rhoppel/CBS-1100-XV_git/Released/Documentation/ST-Link SWD Programming for STM32F01.pdf

# ST-Link SWD Programming for STM32F01

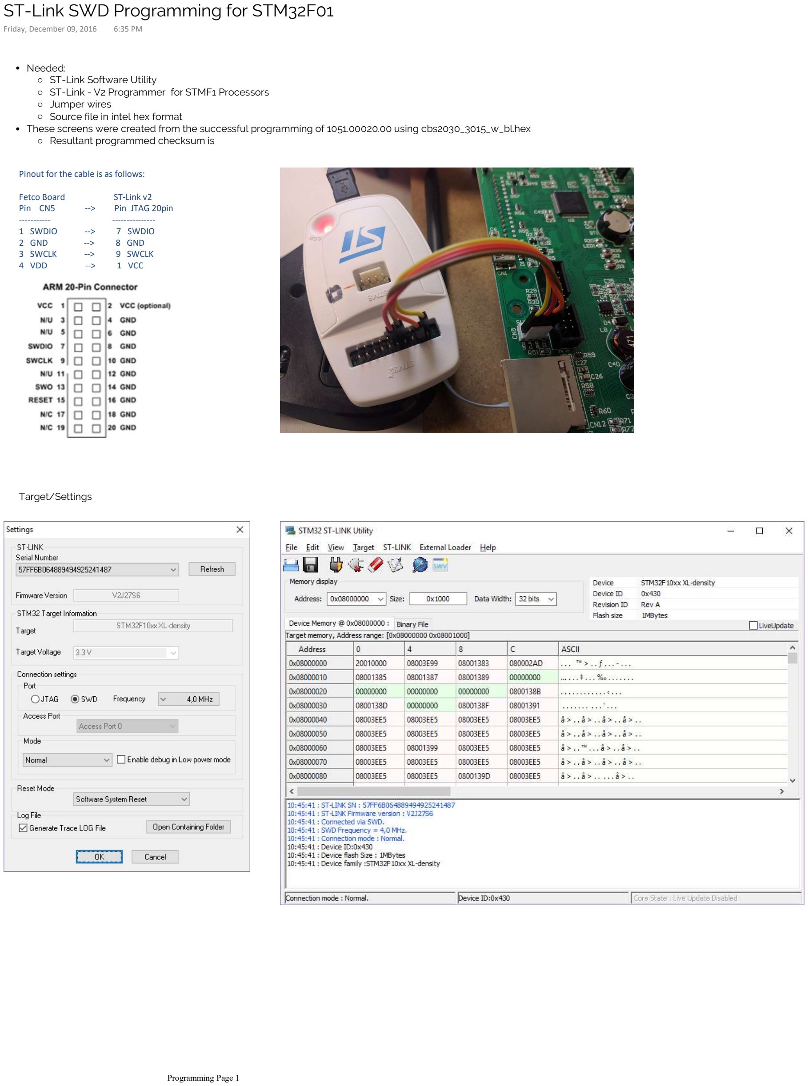
[picture p16: page 1]

- ST-Link Software Utility ○ ST-Link - V2 Programmer for STMF1 Processors ○ Jumper wires ○ Source file in intel hex format • Needed: ○ Resultant programmed checksum is • These screens were created from the successful programming of 1051.00020.00 using cbs2030_3015_w_bl.hex

Pinout for the cable is as follows:

Fetco Board | ST-Link v2 Pin CN5 | --> | Pin JTAG 20pin
----------- | --------------- 1 SWDIO | --> | 7 SWDIO
2 GND | | --> | 8 GND
3 SWCLK | | --> | 9 SWCLK
4 VDD | | --> | 1 VCC

Target/Settings

Friday, December 09, 2016 6:35 PM

Programming Page 1

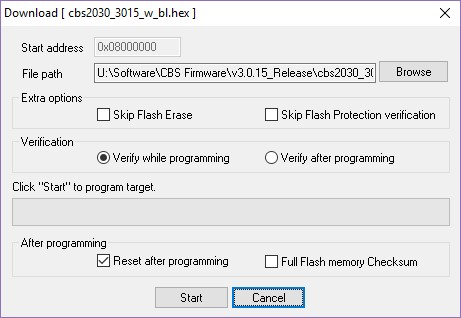
[picture p17: figure]
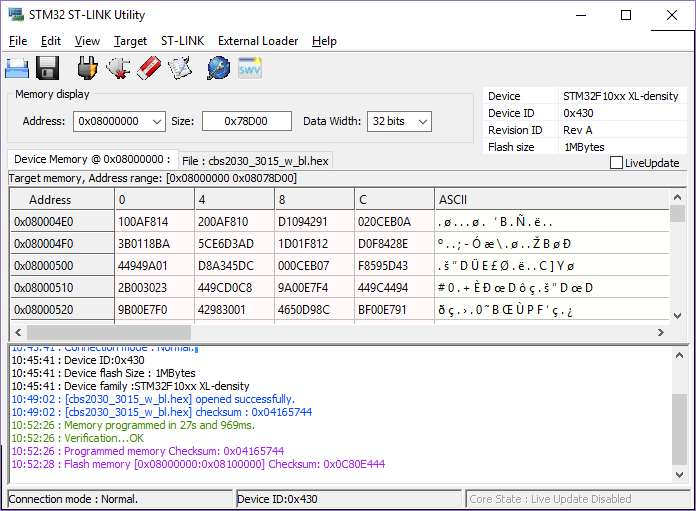
[picture p18: figure]

Target/Program and Verify | Results after a successful program

Programming Page 2
