rhoppel/CBS-1100-XV_git/Released/Drawings/1402 (WIRE HARNESSES)/1402.00097.01.pdf

1402.00097.01 - HARNESS, LOW AMP, CBS-1151-XV+, UL | rev.A
YELLOW | 33" | YELLOW
RED | 33"
BLACK | 33" | BLACK

RED

6" YELLOW
YELLOW | 17" | 1/4", FI
BLACK | 17" | 1/4", FI
ORANGE | 17" | 1/4", FI
GRAY | 10" | 1/4", FI
GRAY | 10" | 1/4", FI

6" BLACK
BLACK | 33"
RED | 33"
6" RED
PURPLE | 30"
YELLOW | 30"
WHITE/GREEN | 32"
GREEN | 16" | RING #8, U

TAB connectors fully insulated.
RING connector double crimped and uninsulated. All wires 18AWG/300VAC, 105o
C (UL 1007/1569).

VHR-5N

1

1

1/4", FI

1/4", FI

1/4", FI

VHR-4N

1/4", FI

VHR-5N

VHR-3N

1

1

1/4", FI

1

VHR-2N

1/4", FI

1/4", FI

SZ 8.18.17
