rhoppel/CBS-1100-XV_git/Released/Drawings/1402 (WIRE HARNESSES)/1402.00097.02.pdf

1402.00097.02 - HARNESS ADDITION, LOW AMP, CBS-1152-XV+, UL | rev.A

6" YEL/WHT 1/4", FI
YELLOW/WHITE | 17" | 1/4", FI
BLACK/WHITE | 17" | 1/4", FI
ORANGE/WHITE | 17" | 1/4", FI
GRAY/WHITE | 10" | 1/4", FI
GRAY/WHITE | 10" | 1/4", FI

1/4" PIGGY, FI

1/4" PIGGY, FI

TAB connectors fully insulated. All wires 18AWG/300VAC, 105o C (UL 1007/1569).

6" RED

1/4", FI

1/4", FI

1

VHR-5N

6" BLACK

SZ 8.18.17
