rhoppel/CBS-1100-XV_git/Released/Drawings/1402 (WIRE HARNESSES)/1402.00098.01.pdf

1402.00098.01 - HARNESS, LOW AMP, CBS-1131-XV+, UL | rev.B
YELLOW | 23" | YELLOW
RED | 23"
BLACK | 23" | BLACK

RED

YELLOW | 17" | 1/4", FI
BLACK | 17" | 1/4", FI
GRAY | 8" | 1/4", FI
GRAY | 8" | 1/4", FI
BLACK | 25"
RED | 25"
PURPLE | 24"
YELLOW | 24" | 1/4", FI
WHITE/GREEN | 29" | 1/4", FI
GREEN | 12" | RING #8, U
RED | 8" | 1/4", FI
BLACK | 8" | 1/4", FI | TAB connectors fully insulated.
| | | RING connector double crimped and uninsulated.
| | | All wires 18AWG/300VAC, 105o C (UL 1007/1569).
RED | 8" | 1/4", FI | * - Wire insulation cut 3/8" from the end and left.
BLACK | 8" | 1/4", FI

1

1

1/4", FI

1/4", FI

1/4", FI

VHR-5N

VHR-3N

1

VHR-5N

VHR-3N

# VHR-4NBLUNT

CUT*

1

1

VHR-2N

1

SZ 8.24.17
