rhoppel/CBS-1100-XV_git/Released/Drawings/1402 (WIRE HARNESSES)/1402.00098.02.pdf

1402.00098.02 - HARNESS ADDITION, LOW AMP, CBS-1132-XV+, UL | rev.B
YELLOW/WHITE | 13" | 1/4", FI
BLACK/WHITE | 13" | 1/4", FI
GRAY/WHITE | 10" | 1/4", FI
GRAY/WHITE | 10" | 1/4", FI

1/4" PIGGY, FI
TAB connectors fully insulated.
1/4" PIGGY, FI | All wires 18AWG/300VAC, 105o
C (UL 1007/1569).

BLACK 6"

RED 6"

1

VHR-5N

1/4", FI

1/4", FI

SZ 8.24.17
