rhoppel/CBS-1100-XV_git/Released/PCB/1051.00041.00-A.3/1051.00041.00_1-A.3/Drawings List/[1051.00041.00_1-A.3] Drawings List-CBS1100(Production).pdf

1051.00041.00_1 | A.3
Project: | CBS1100.PrjPCB
Variant: | CBS Production PCB
Number | Drawing Number | Description | Revision
1 | 1051.00041.00_2 | Schematic; CBS-1100 XV+ | A.4
2 | 1051.00041.00_0 | PCB; CBS-1100 XV+ | A.3
3 | 1051.00041.00_3 | Stencil; CBS-1100 XV+ | A.3
4 | 1051.00041.00_4 | Software; CBS-1100 XV+ | A.1
5
6
7

## DRAWINGS LIST - ASSEMBLY PCB:

Altium Limited Confidential | 8/29/2017 | Page 1
