rhoppel/CBS-1100-XV_git/Released/Documentation/Document.docx

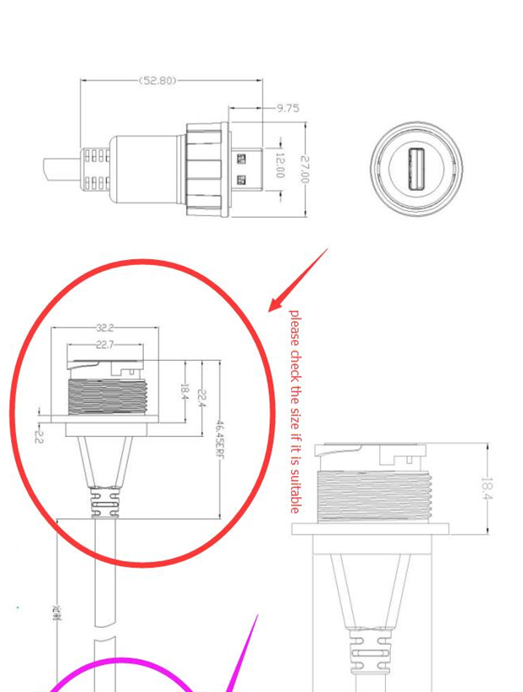
[picture p19: figure]
