rhoppel/CBS-1100-XV_git/Released/Documentation/USB panel waterproof connector.pdf

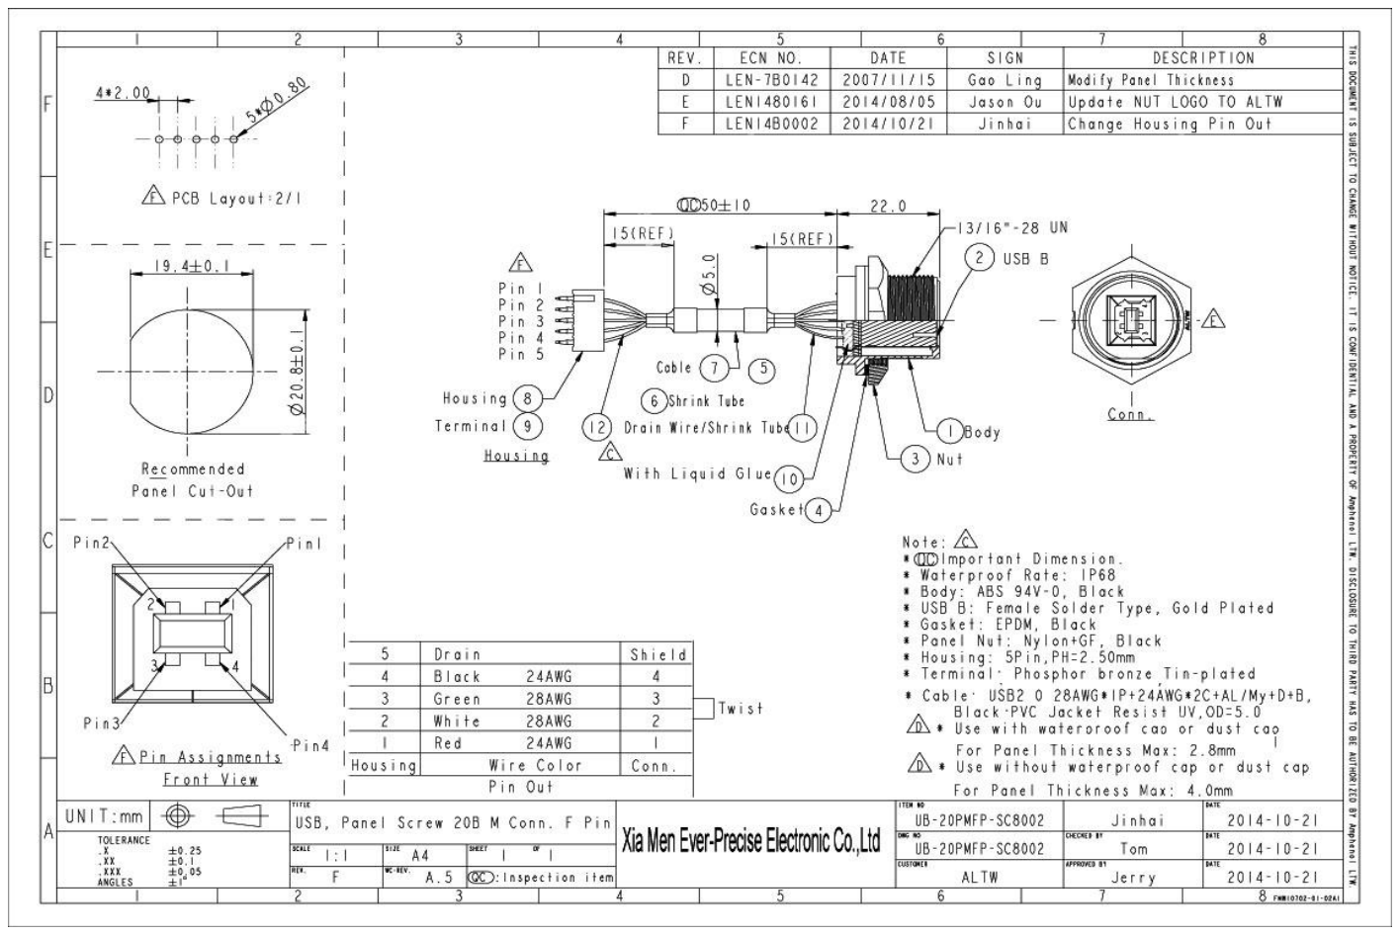
[picture p20: page 1]
