rhoppel/CBS-1100-XV_git/img/CBS/CBS-1131-2.png

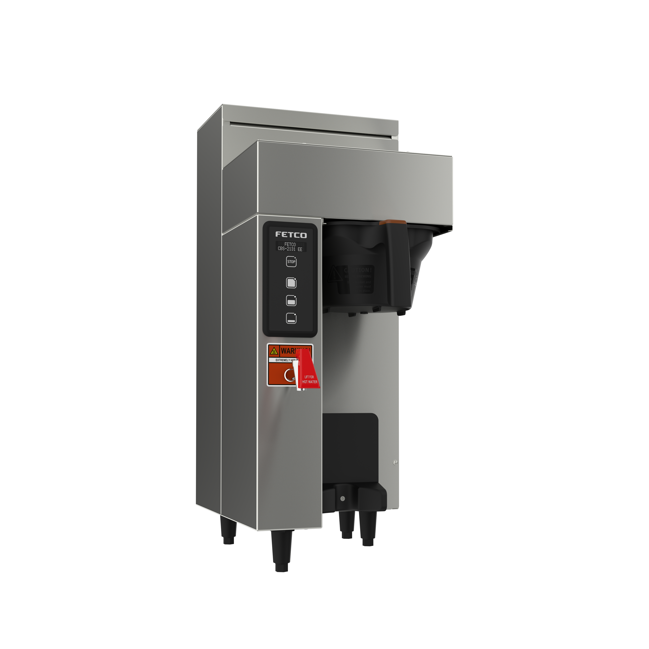
img/CBS/CBS-1131-2.png
