rhoppel/CBS-1100-XV_git/img/CBS/CBS-1131_back.png

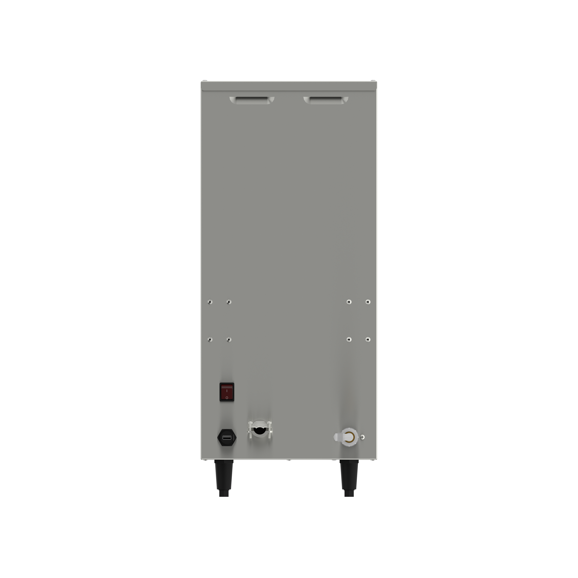
img/CBS/CBS-1131_back.png
