rhoppel/CBS-1100-XV_git/img/CBS/CBS-1131_right.png

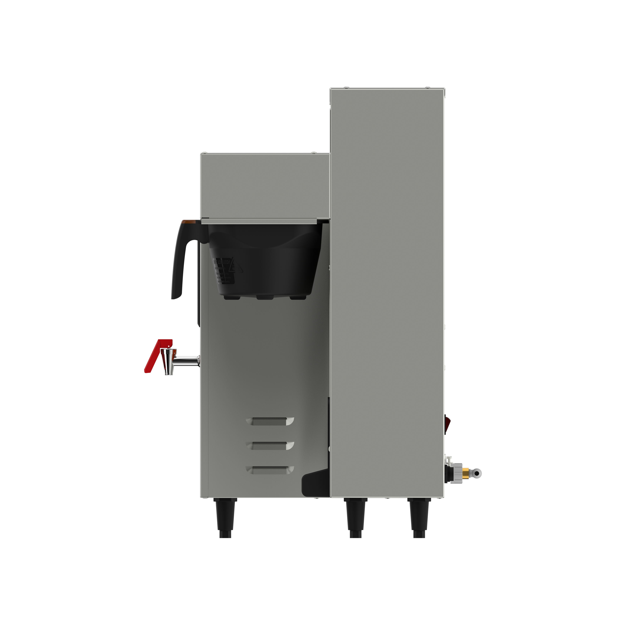
img/CBS/CBS-1131_right.png
