rhoppel/CBS-1100-XV_git/img/CBS/CBS-1132_back.png

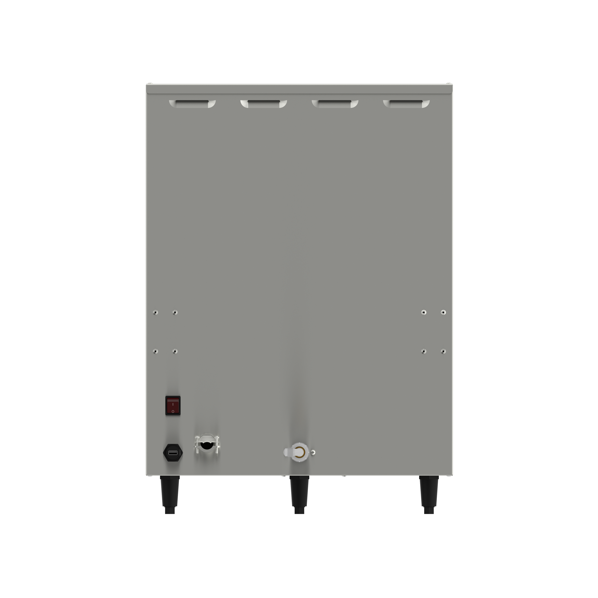
img/CBS/CBS-1132_back.png
