rhoppel/CBS-1100-XV_git/img/CBS/CBS-1132_front.png

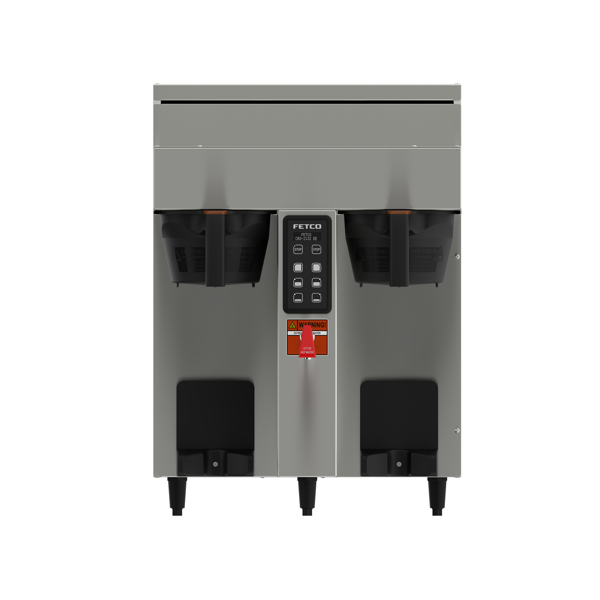
img/CBS/CBS-1132_front.png
