rhoppel/CBS-1100-XV_git/img/CBS/CBS-1151-2.png

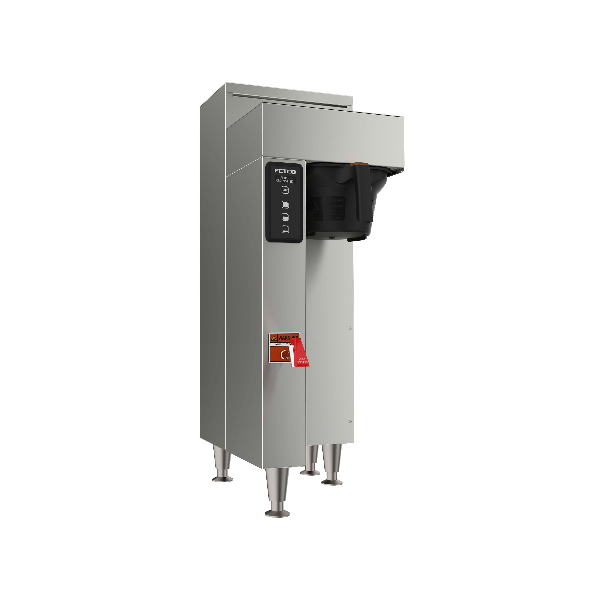
img/CBS/CBS-1151-2.png
