rhoppel/CBS-1100-XV_git/img/CBS/CBS-1151_right.png

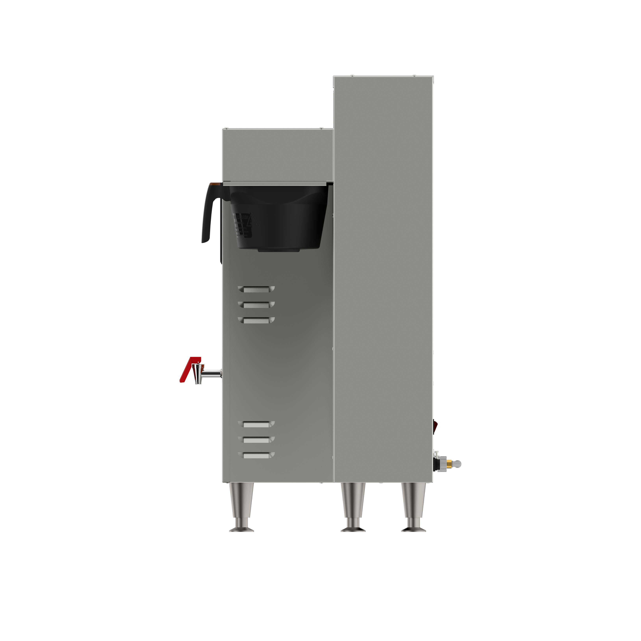
img/CBS/CBS-1151_right.png
