rhoppel/CBS-1100-XV_git/img/CBS/CBS-1152_front.png

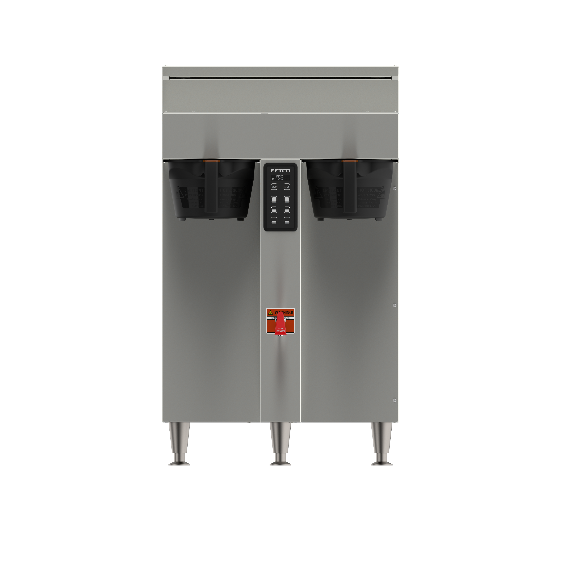
img/CBS/CBS-1152_front.png
