rhoppel/CBS-1100-XV_git/img/FETCO4.jpg

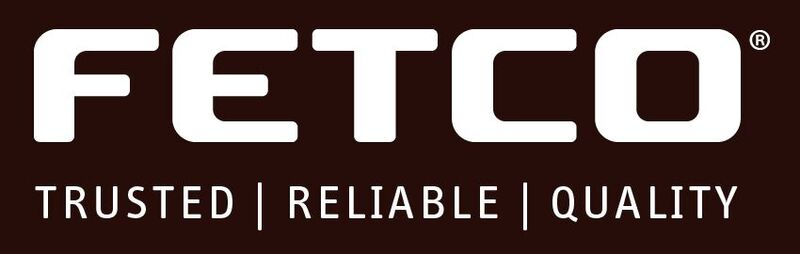
img/FETCO4.jpg
