rhoppel/CBS-1100-XV_git/img/FETCO.png

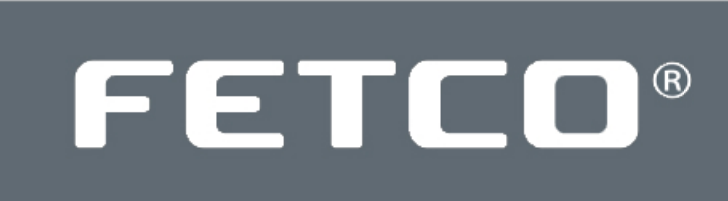
img/FETCO.png
