rhoppel/CBS-1100-XV_git/img/FETCO_HOPPEL.png

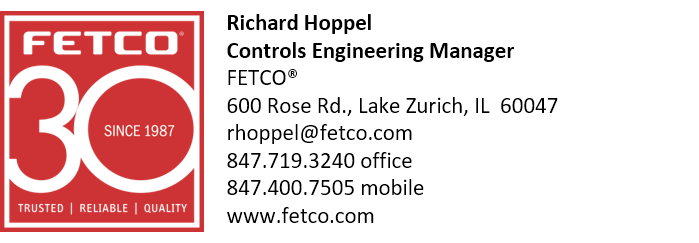
img/FETCO_HOPPEL.png
