rhoppel/CBS-1100-XV_git/img/FETCO_Hoppel_Bcard_small.png

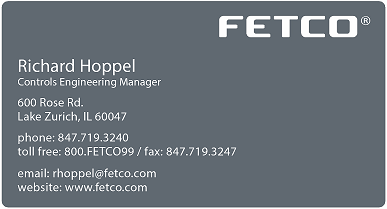
img/FETCO_Hoppel_Bcard_small.png
