rhoppel/CBS-1100-XV_git/img/PCB/1051.00041.00_0-A.3_Top.jpg

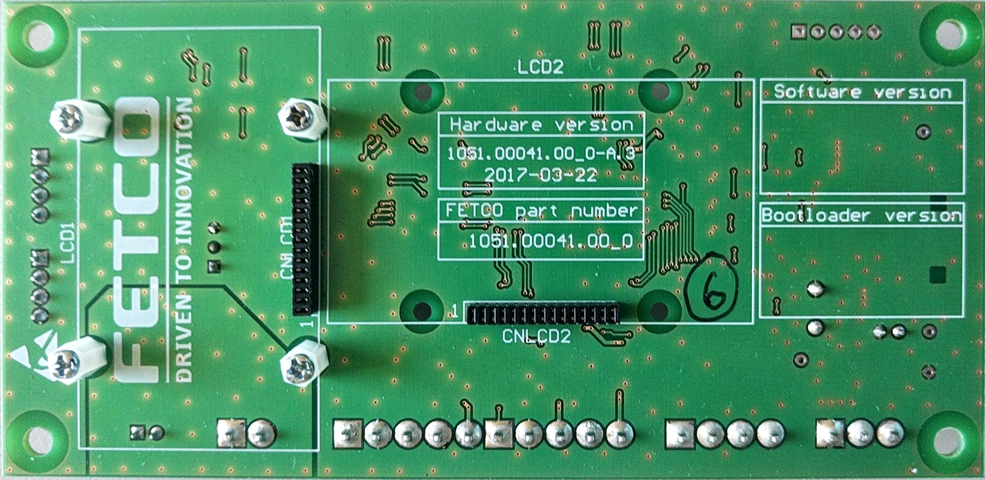
img/PCB/1051.00041.00_0-A.3_Top.jpg
