rhoppel/CBS-1100-XV_git/img/PCB/MembraneSwitch_Dual.jpg

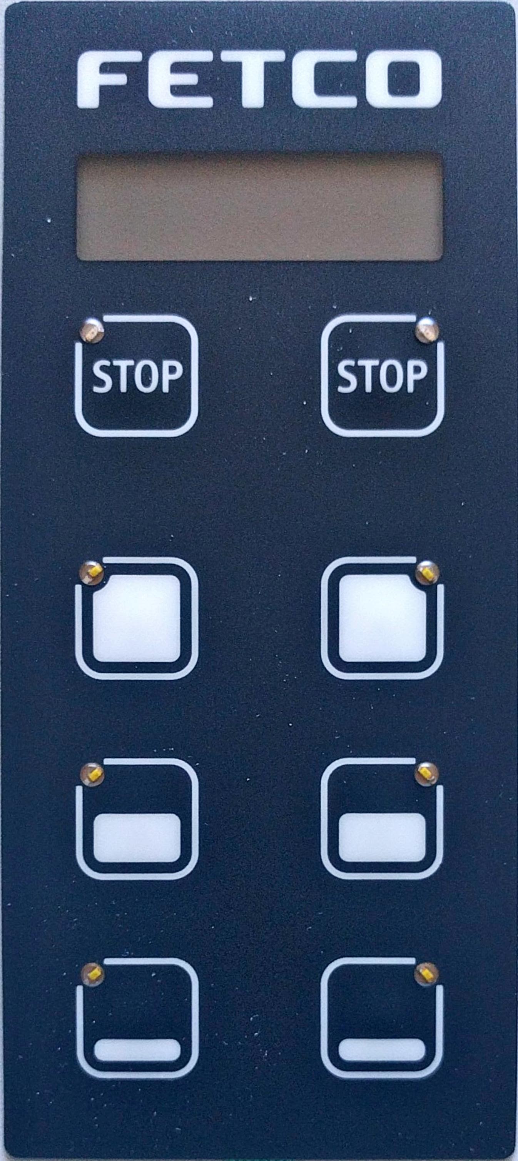
img/PCB/MembraneSwitch_Dual.jpg
