rhoppel/CBS-1100-XV_git/img/PCB/MembraneSwitch_Dual_cable.jpg

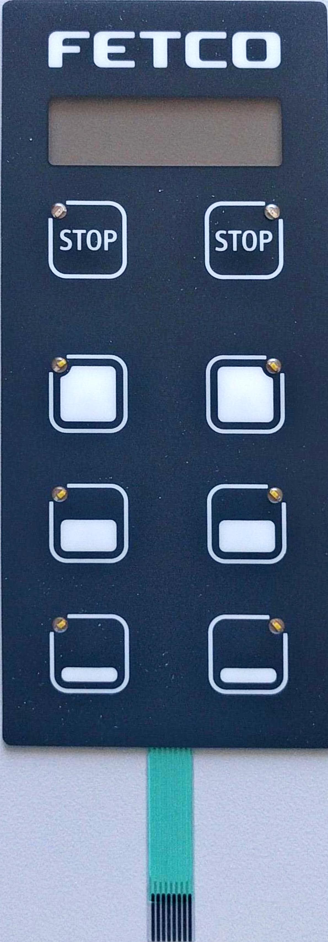
img/PCB/MembraneSwitch_Dual_cable.jpg
