rhoppel/CBS-1100-XV_git/img/PCB/MembraneSwitch_Single.jpg

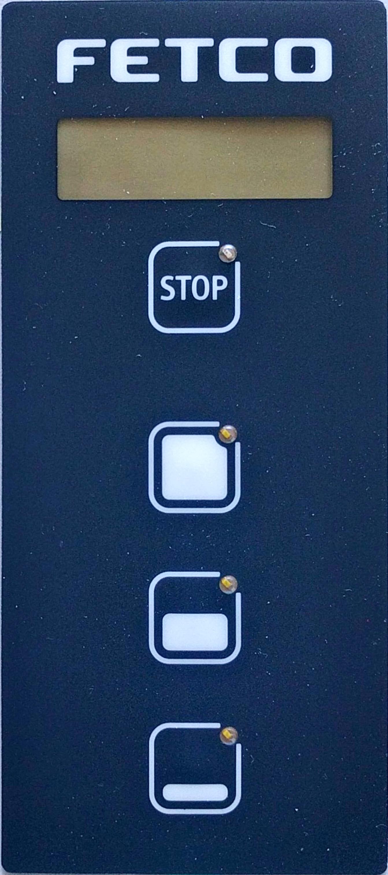
img/PCB/MembraneSwitch_Single.jpg
