rhoppel/CBS-1100-XV_git/img/ST-Link.PNG

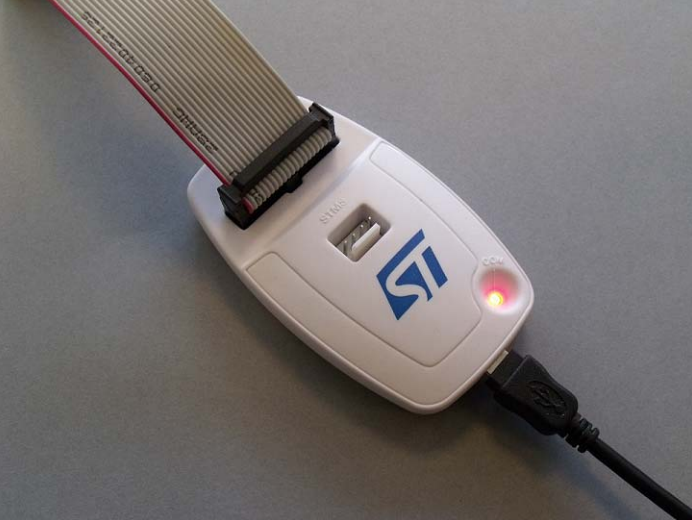
img/ST-Link.PNG
