rhoppel/CBS-1100-XV_git/Released/DisplayAssembly/Documentation/specifications.jpg

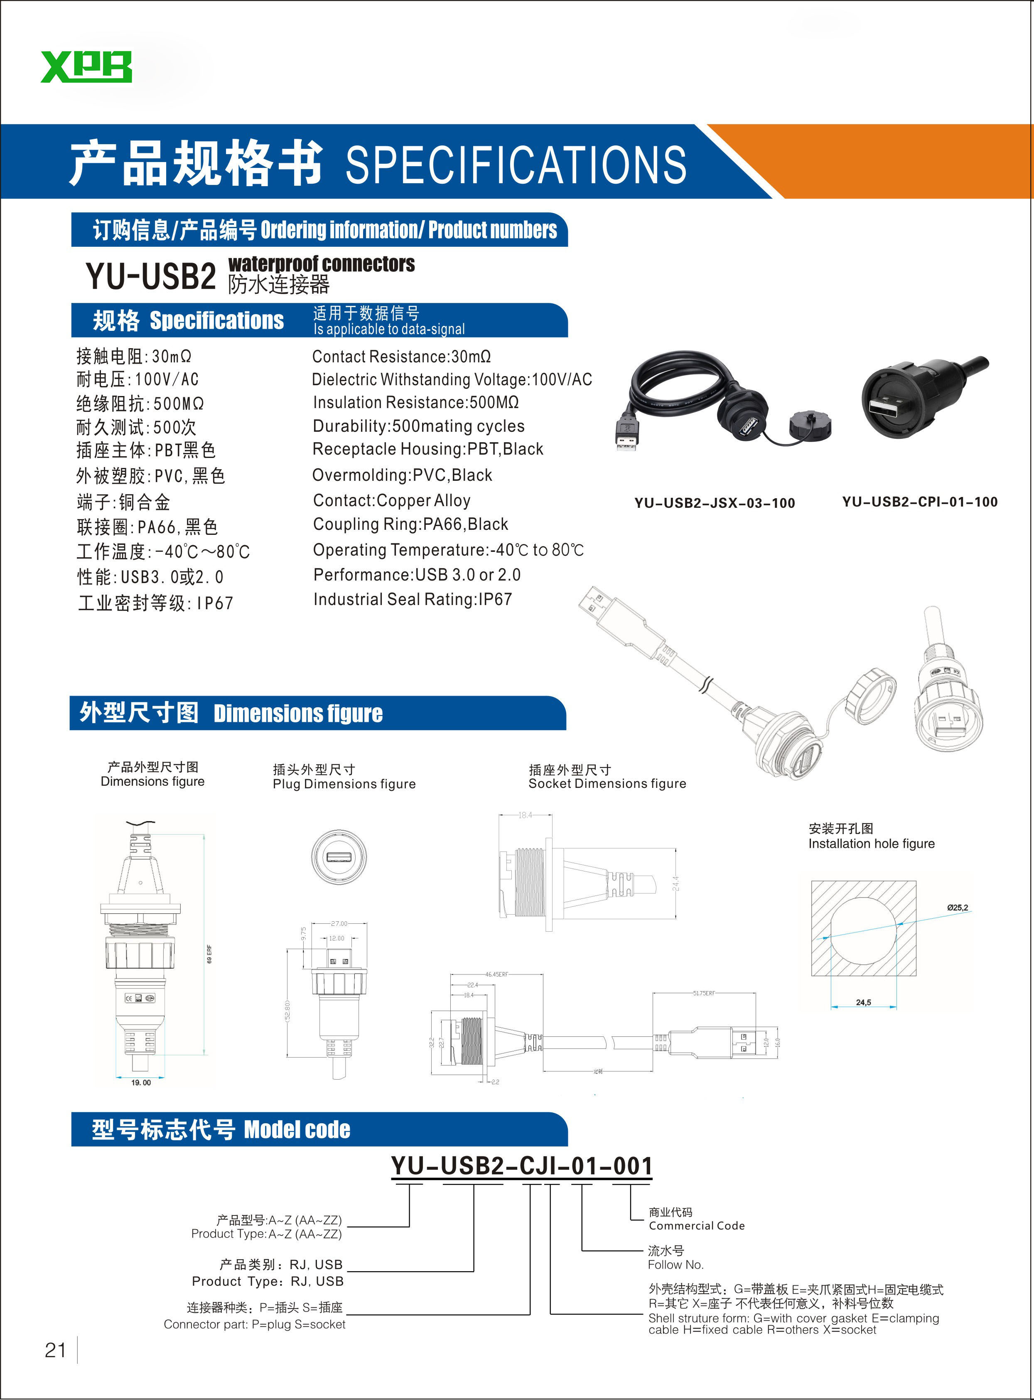
Released/DisplayAssembly/Documentation/specifications.jpg
