rhoppel/CBS-1100-XV_git/Released/DisplayAssembly/Switches/Membrane Switch/CBS Double Schematic2 Transparent.png

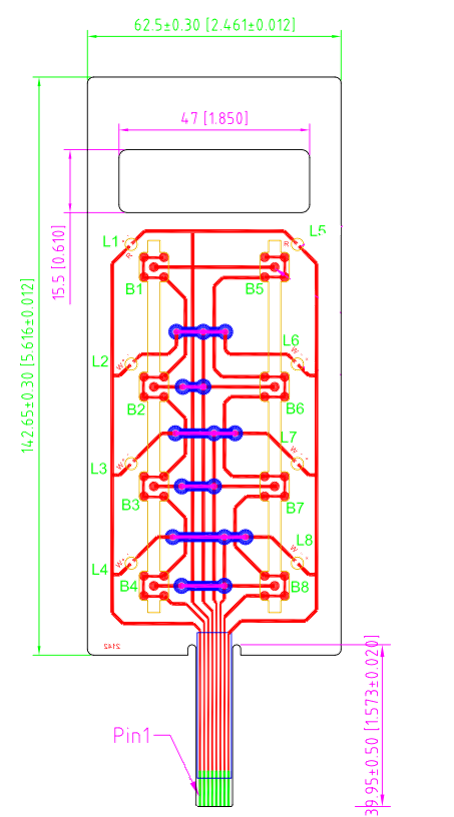
Released/DisplayAssembly/Switches/Membrane Switch/CBS Double Schematic2 Transparent.png
