rhoppel/CBS-1100-XV_git/Released/DisplayAssembly/Switches/Membrane Switch/CBS Single2 Schematic Transparent.png

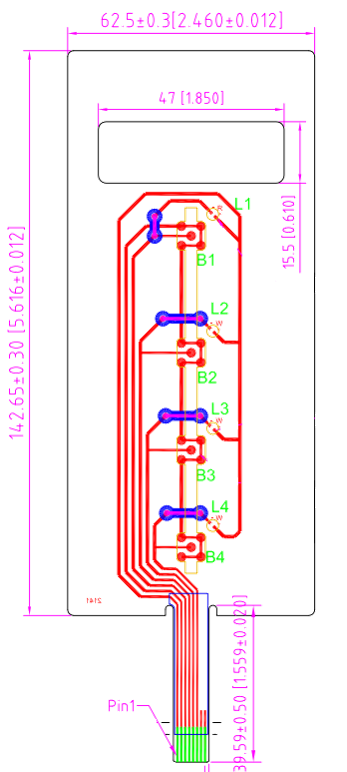
Released/DisplayAssembly/Switches/Membrane Switch/CBS Single2 Schematic Transparent.png
