rhoppel/CBS-1100-XV_git/Released/PCB/img/PCB/1051.00041.png

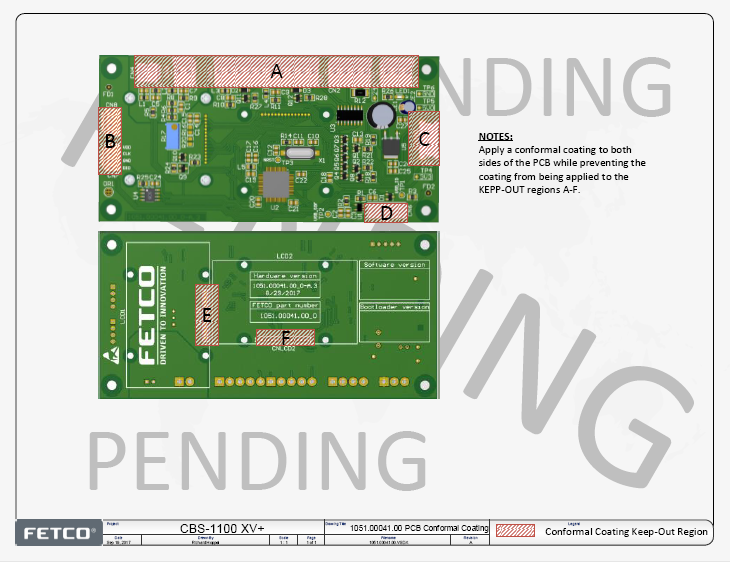
Released/PCB/img/PCB/1051.00041.png
