rhoppel/CBS-1100-XV_git/Released/PCB/img/PCB/PCB_Artwork.PNG

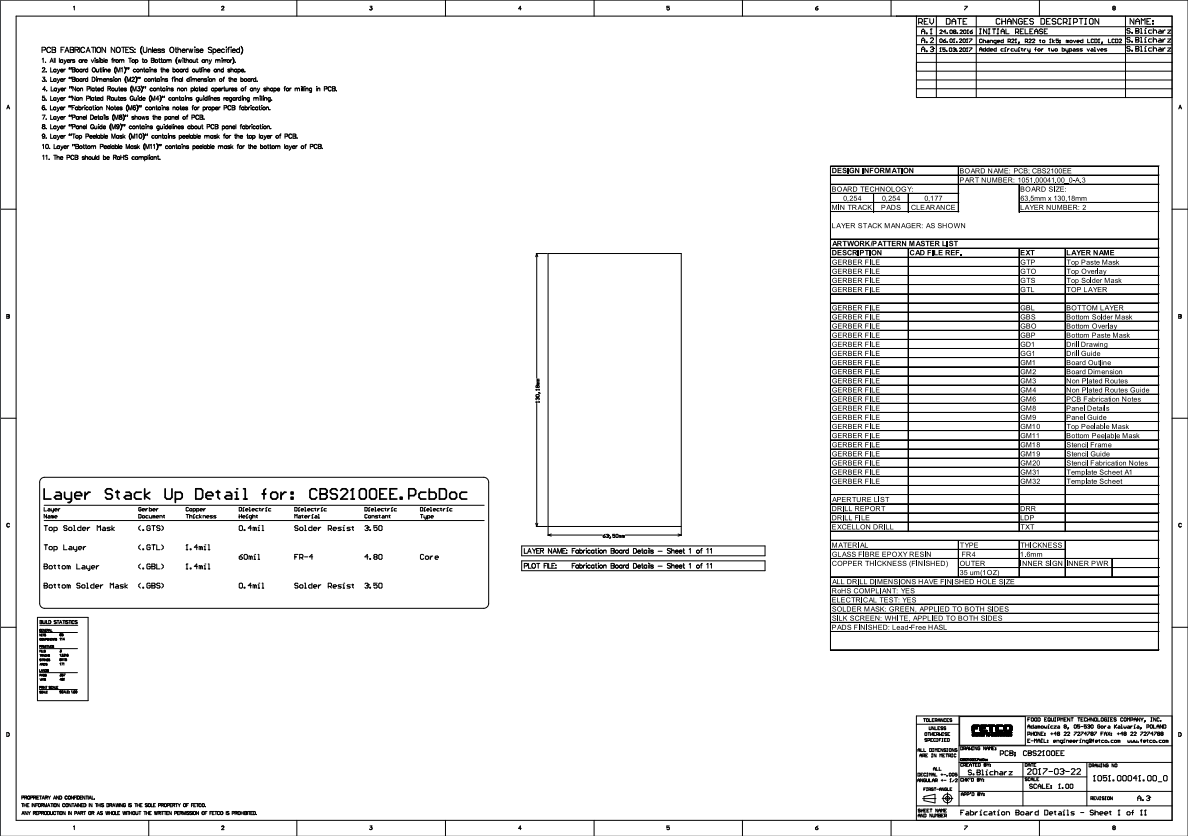
Released/PCB/img/PCB/PCB_Artwork.PNG
