rhoppel/CBS-1100-XV_git/Released/PCB/img/PCB/Stencils_largest.PNG

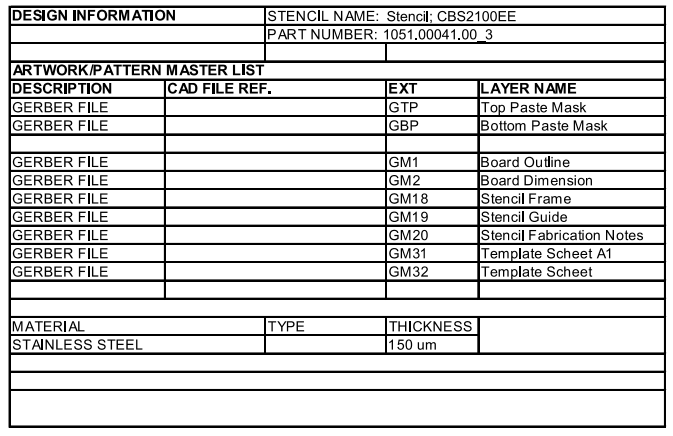
Released/PCB/img/PCB/Stencils_largest.PNG
