rhoppel/CBS-1100-XV_git/Released/PCB/img/PCB/Top_larger.PNG

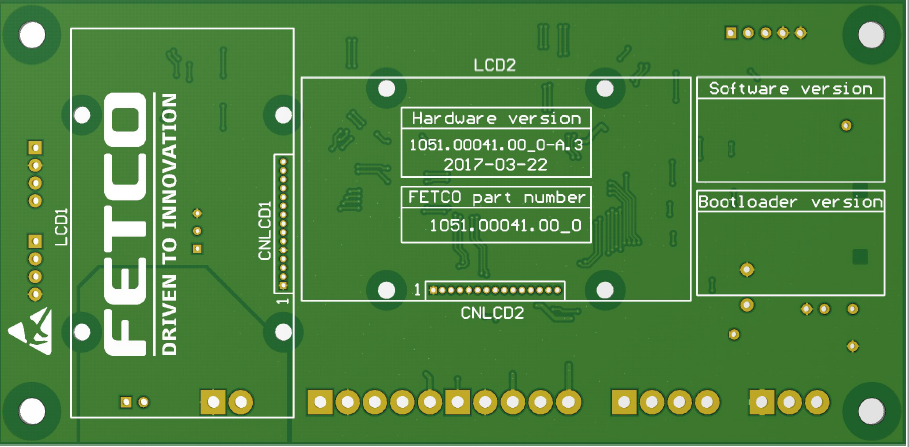
Released/PCB/img/PCB/Top_larger.PNG
