rhoppel/CBS-1100-XV_git/Released/PCB/img/PCB/BOM_largest.PNG

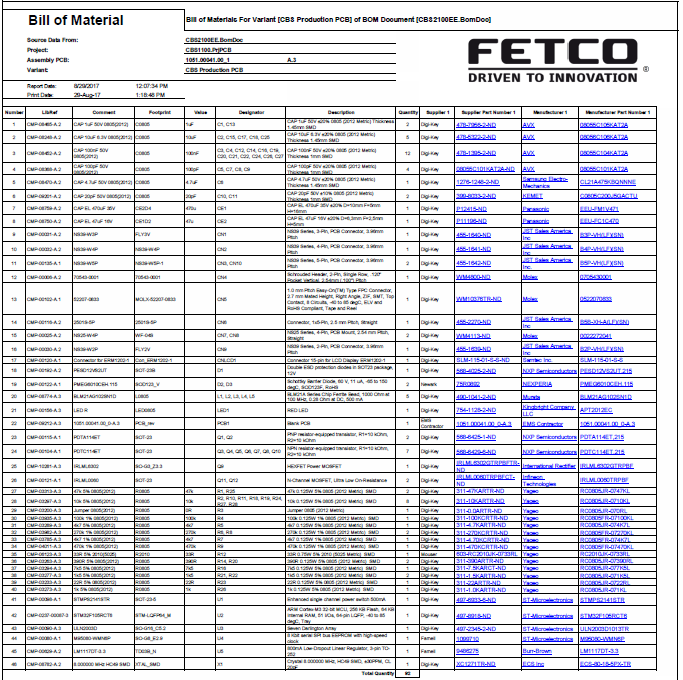
Released/PCB/img/PCB/BOM_largest.PNG
