rhoppel/CBS-1100-XV_git/Released/PCB/1051.00041.00-A.3/1051.00041.00_0-A.3/10510004100_03_19_2017.dxf

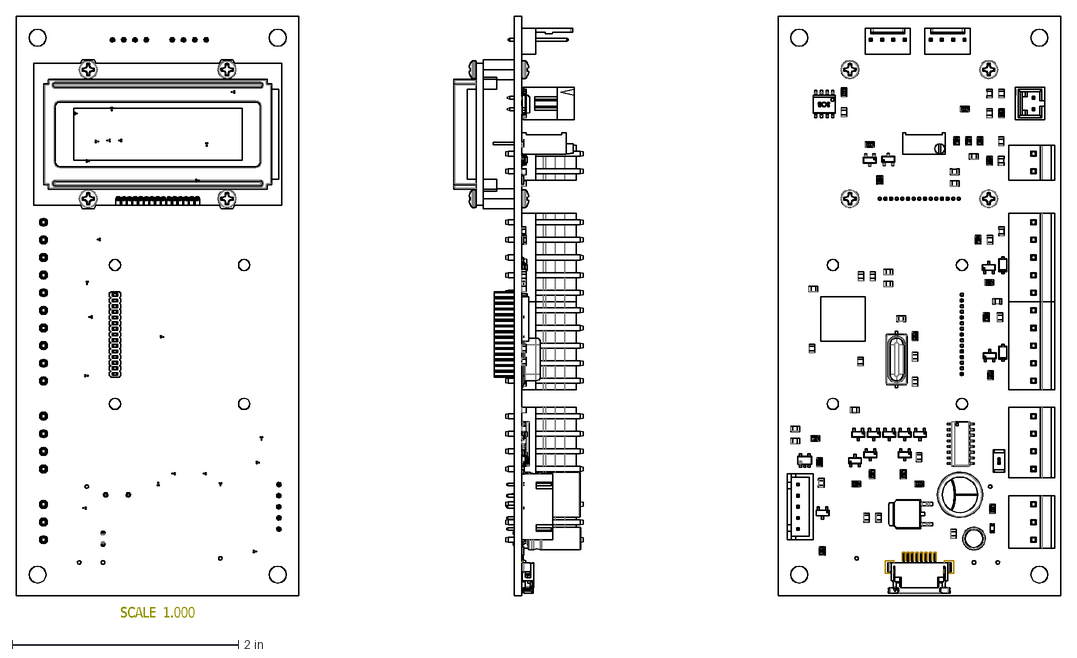
[picture p51: CAD file, 2019-11-21]
Released/PCB/1051.00041.00-A.3/1051.00041.00_0-A.3/10510004100_03_19_2017.dxf
SCALE 1.000
