rhoppel/CBS-1100-XV_git/(list of files, cad)

Other CAD files:
Released/DisplayAssembly/Switches/Membrane Switch/1058.00047.00 CBS Single/UA-1241-R3 PRODUCT DRAWING.DWG
Released/DisplayAssembly/Switches/Membrane Switch/1058.00048.00 CBS Dual/UA-1242-R3 CIRCIUT DRAWING.DWG
Released/DisplayAssembly/Switches/Membrane Switch/UA-1242-R3 CIRCIUT DRAWING.DWG
Released/DisplayAssembly/Switches/Membrane Switch/1058.00047.00 CBS Single/UA-1241-R3 CIRCUIT DRAWING.DWG
Released/DisplayAssembly/Switches/Membrane Switch/1058.00048.00 CBS Dual/UA-1242-R3 PRODUCT DRAWING.DWG
Released/DisplayAssembly/Switches/Membrane Switch/UA-1241-R3 PRODUCT DRAWING.DWG
Released/DisplayAssembly/Switches/Membrane Switch/UA-1242-R3 PRODUCT DRAWING.DWG
Released/DisplayAssembly/Switches/Membrane Switch/UA-1241-R3 CIRCUIT DRAWING.DWG
