rhoppel/CBS-1100-XV_git/Released/Drawings/1108 (ASSEMBLY BOARDS SWITCHING CONTROL & SOFTWARE)/1108.00036.00.pdf

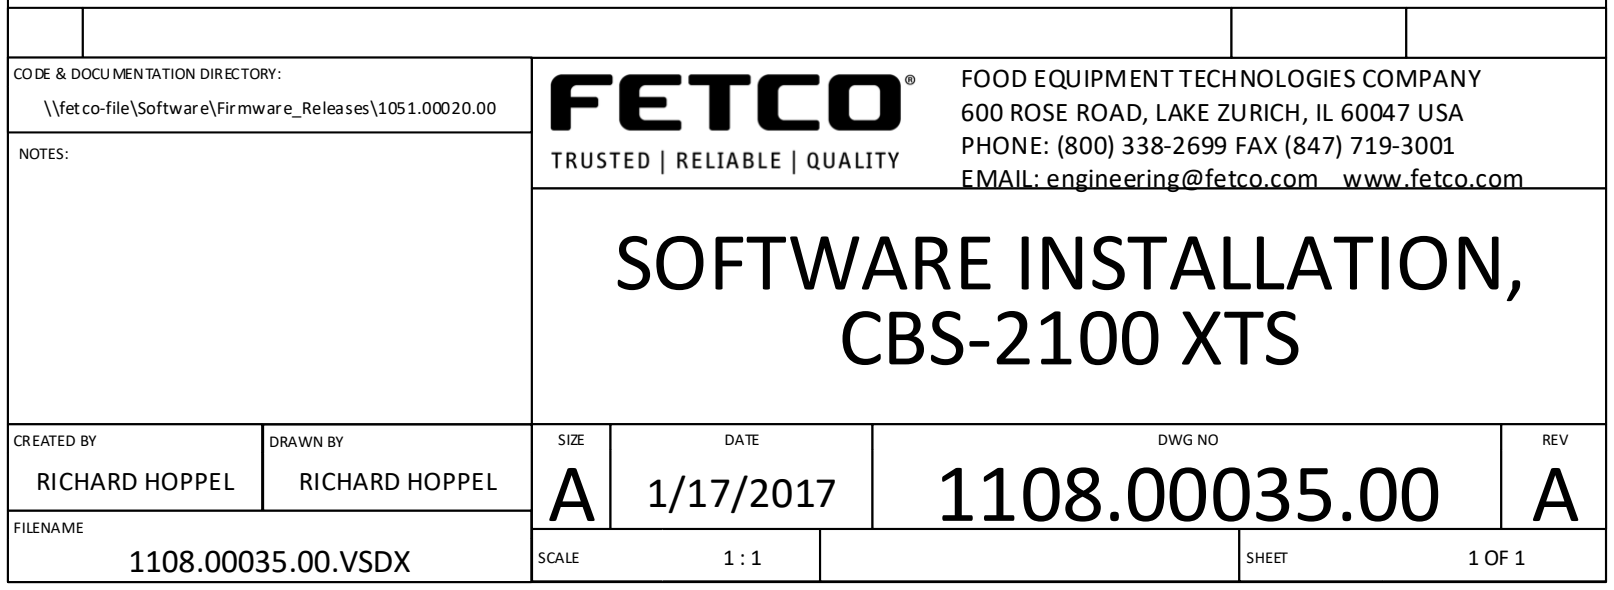
[picture p63: figure]
SOFTWARE INSTALLATION, CBS-2100 XTS; SCALE; SHEET; FOOD EQUIPMENT TECHNOLOGIES COMPANY; FILENAME; 1108.00035.00.VSDX; CODE & DOCUMENTATION DIRECTORY:; NOTES:

CREATED BY | DRAWN BY | SIZE | DATE | DWG NO | REV
RICHARD HOPPEL | RICHARD HOPPEL | A | 1/17/2017 | 1108.00035.00 | A

600 ROSE ROAD, LAKE ZURICH, IL 60047 USA PHONE: (800) 338-2699 FAX (847) 719-3001 EMAIL: engineering@fetco.com www.fetco.com

\\fetco-file\Software\Firmware_Releases\1051.00020.00

### BILL OF MATERIALS

ITEM | PART NUMBER | DESCRIPTION | QTY
1 | 1050.00019.BL | BOOTLOADER, CBS-2100 XTS | 0
2 | 1050.00019.FW | FIRMWARE, CBS-2100 XTS | 0

SOFTWARE = FIRMWARE + BOOTLOADER

SOFTWARE INSTALLATION ON CBS-2100 CONTROL BOARD 1051.00020.00 OR UNIT USING AN SD-CARD:
- OBTAIN A BLANK, FORMATTED SD-CARD GREATER THAN 1 GB
- SKIP THE FOLLOWING STEP IF THE DESIRED BOOTLOADER IS ALREADY INSTALLED ON PCB 1051.00020.00
- COPY 4 FILES SPECIFIED IN 1050.00019.BL ON TO THE SD-CARD
- COPY THE 1 FILE SPECIFIED IN 1050.00019.FW ON TO THE SD-CARD
- CHECK INTEGRITY OF FILES ON SD-CARD BY COMPUTING MD5 CHECKSUM CODE AND VERIFYING THE MD5 CHECKSUM CODE SPECIFIED IN 1050.00019.FW AND 1050.00019.BL
- MD5 CHECKSUM CODE TOOL AND INSTRUCTIONS ARE INCLUDED IN THE DIRECTORY SPECIFIED IN 1050.00019.FW
- POWER OFF UNIT
- INSERT SD-CARD INTO SD-CARD SLOT ON UNIT
- POWER ON UNIT
- UNIT WILL BE AUTOMATICALLY UPDATED
- WAIT UNTIL MESSAGE INDICATING SD-CARD SHOULD BE REMOVED
- REMOVE SD-CARD
- UNIT WILL REBOOT, IF NOT TURN POWER OFF, THEN TURN POWER ON
- CHECK SOFTWARE REVISION ON SCREEN WHICH IS VISIBLE FOR 3 SECONDS AFTER REBOOT, IT SHOULD MATCH THE VERSIONS SPECIFIED IN 1050.00019.FW AND 1050.00019.BL
- REPEAT PROCESS IF NOT PROGRAMMED CORRECTLY

SOFTWARE INSTALLATION ON TO CBS-2100 CONTROL BOARD 1051.00020.00 DURING PCB ASSEMBLY USING SWD CONNECTOR AND A ST-LINK/V2 PROGRAMMER OR USING SPECIALIZED EQUIPMENT TO INSTALL FIRMWARE DIRECTLY ON TO MICROPROCESSOR STM 32F103
- OBTAIN INTEL HEX FORMAT FIRMWARE FILE SPECIFIED IN 1050.00019.FW
- CHECK INTEGRITY OF FILE BY VERIFYING THE MD5 CHECKSUM CODE SPECIFIED IN 1050.00019.FW
- MD5 CHECKSUM CODE TOOL AND INSTRUCTIONS ARE INCLUDED IN THE DIRECTORY SPECIFIED IN 1050.00019.FW
- PROGRAM INTEL HEX FORMAT FIRMWARE FILE ON TO DEVICE USING DESIRED METHOD AS INDICATED ABOVE
- KEEP ALL PROGRAMMING FUSES INTACT
- CHECK PROGRAMMED CHECKSUM TO VERIFY PROGRAMMING AS SPECIFIED IN 1050.00019.FW

### REVISIONS

REV | DESCRIPTION | DATE | APPROVED
A | INSTRUCTIONS FOR INSTALLING FIRMWARE ON TO CBS-2100 CONTROL BOARD 1051.00020.00 | 1/30/17 | RH
