rhoppel/CBS-1100-XV_git/Released/DisplayAssembly/Switches/Membrane Switch/PF_CBS_Double.png

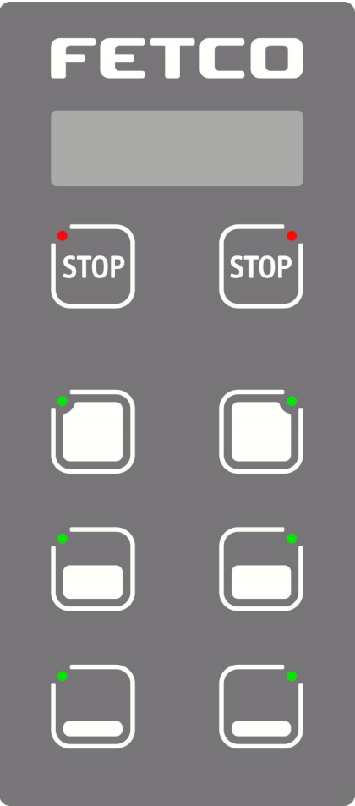
Released/DisplayAssembly/Switches/Membrane Switch/PF_CBS_Double.png
