rhoppel/CBS-1100-XV_git/Released/DisplayAssembly/Switches/Membrane Switch/PF_TBS_Single.png

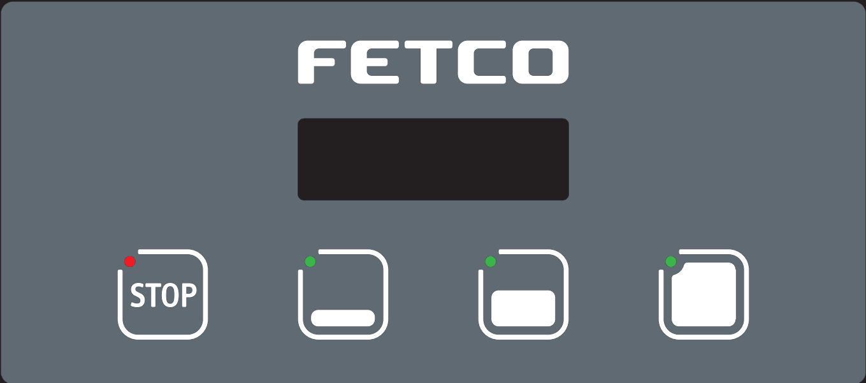
Released/DisplayAssembly/Switches/Membrane Switch/PF_TBS_Single.png
