rhoppel/CBS-1100-XV_git/Released/PCB/img/PCB/SolderPaste_largest.PNG

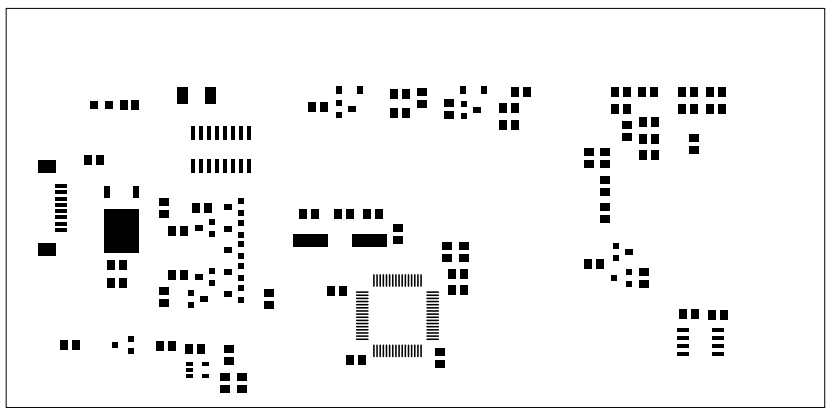
Released/PCB/img/PCB/SolderPaste_largest.PNG
