rhoppel/CBS-1100-XV_git/Released/Test/README.md

FETCO graphic

managed by: __Richard Hoppel__ | Controls Engineering Manager
| __rhoppel@fetco.com__ | mobile 847.400.7505

### [FETCO][FETCO link] |  ProjectName: [__CBS-1100-XV+/Released/Test__](.)
[OneDriveExternalLinkViewonly] | [LocalProjectLocation]  |

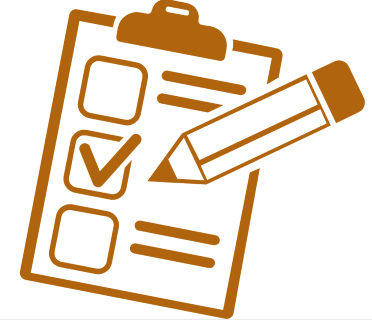
[picture p68: Released/Test/img/checklist_small.PNG]
TestMe


Component | Status | FETCO PN | TYPE | REV |  PCB Base/Link or Drawing NameLink | Notes
--|---|--| --
--|---|--| --
--|---|--| --

---
### To Do
last update:  ___2017.9.22___
- [ ] update Manual

---
### Significant Changes
last update:  ___2017.9.22___

Date  |  Change |  Notes
--|---|--
2017.6.20  | INITIAL  |  New Format
  |   |
-----
### Directory Structure
syntax:[ \[Linked Directory\]](.)  Note: only ___Production Directories/Files___ are shared with our Production Partners

#### \[[..]\] Up A Directory
* [.. README]

#### [\[Drawings\]][Drawings_dir] Main Assembly Production Drawings

#### [\[Documentation\]][Documentation_dir]

#### [\[img\]][img_dir]
<center>Image</center>  |  Name |  Notes
--|---|--
FETCO_label | |

---
[..]: ..
[.. README]: ../README.text.html
[README_html]: README.text.html
[README_markup]: README.text
[FETCO link]: https://www.fetco.com/
[Archive_dir]: Archive
[Documentation_dir]: Documentation
[Drawings_dir]: Drawings
[img_dir]: img

---
[OneDriveExternalLinkViewonly]: https://goo.gl/EGLRtw
