rhoppel/CBS-1100-XV_git/Released/PCB/1051.00041.00-A.3/1051.00041.00_0-A.3/PCB 3D PDF/[1051.00041.00_0-A.3] PCB Bottom 3D.PDF

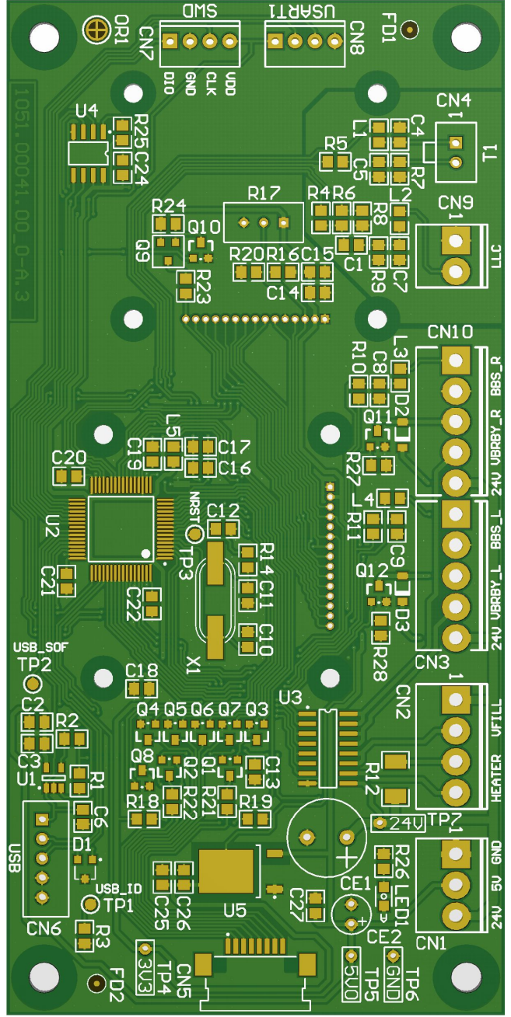
[picture p103: page 1]
