rhoppel/CBS-1100-XV_git/Released/PCB/1051.00041.00-A.3/1051.00041.00_0-A.3/PCB 3D PDF/[1051.00041.00_0-A.3] PCB Top 3D.PDF

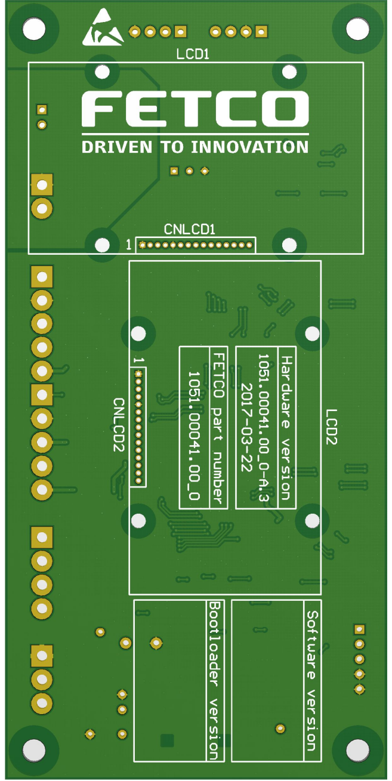
[picture p104: page 1]
