rhoppel/CBS-1100-XV_git/Released/PCB/1051.00041.00-A.3/1051.00041.00_3-A.3/Stencil Documentation/[1051.00041.00_3-A.3] Stencil Paste Mask.PDF

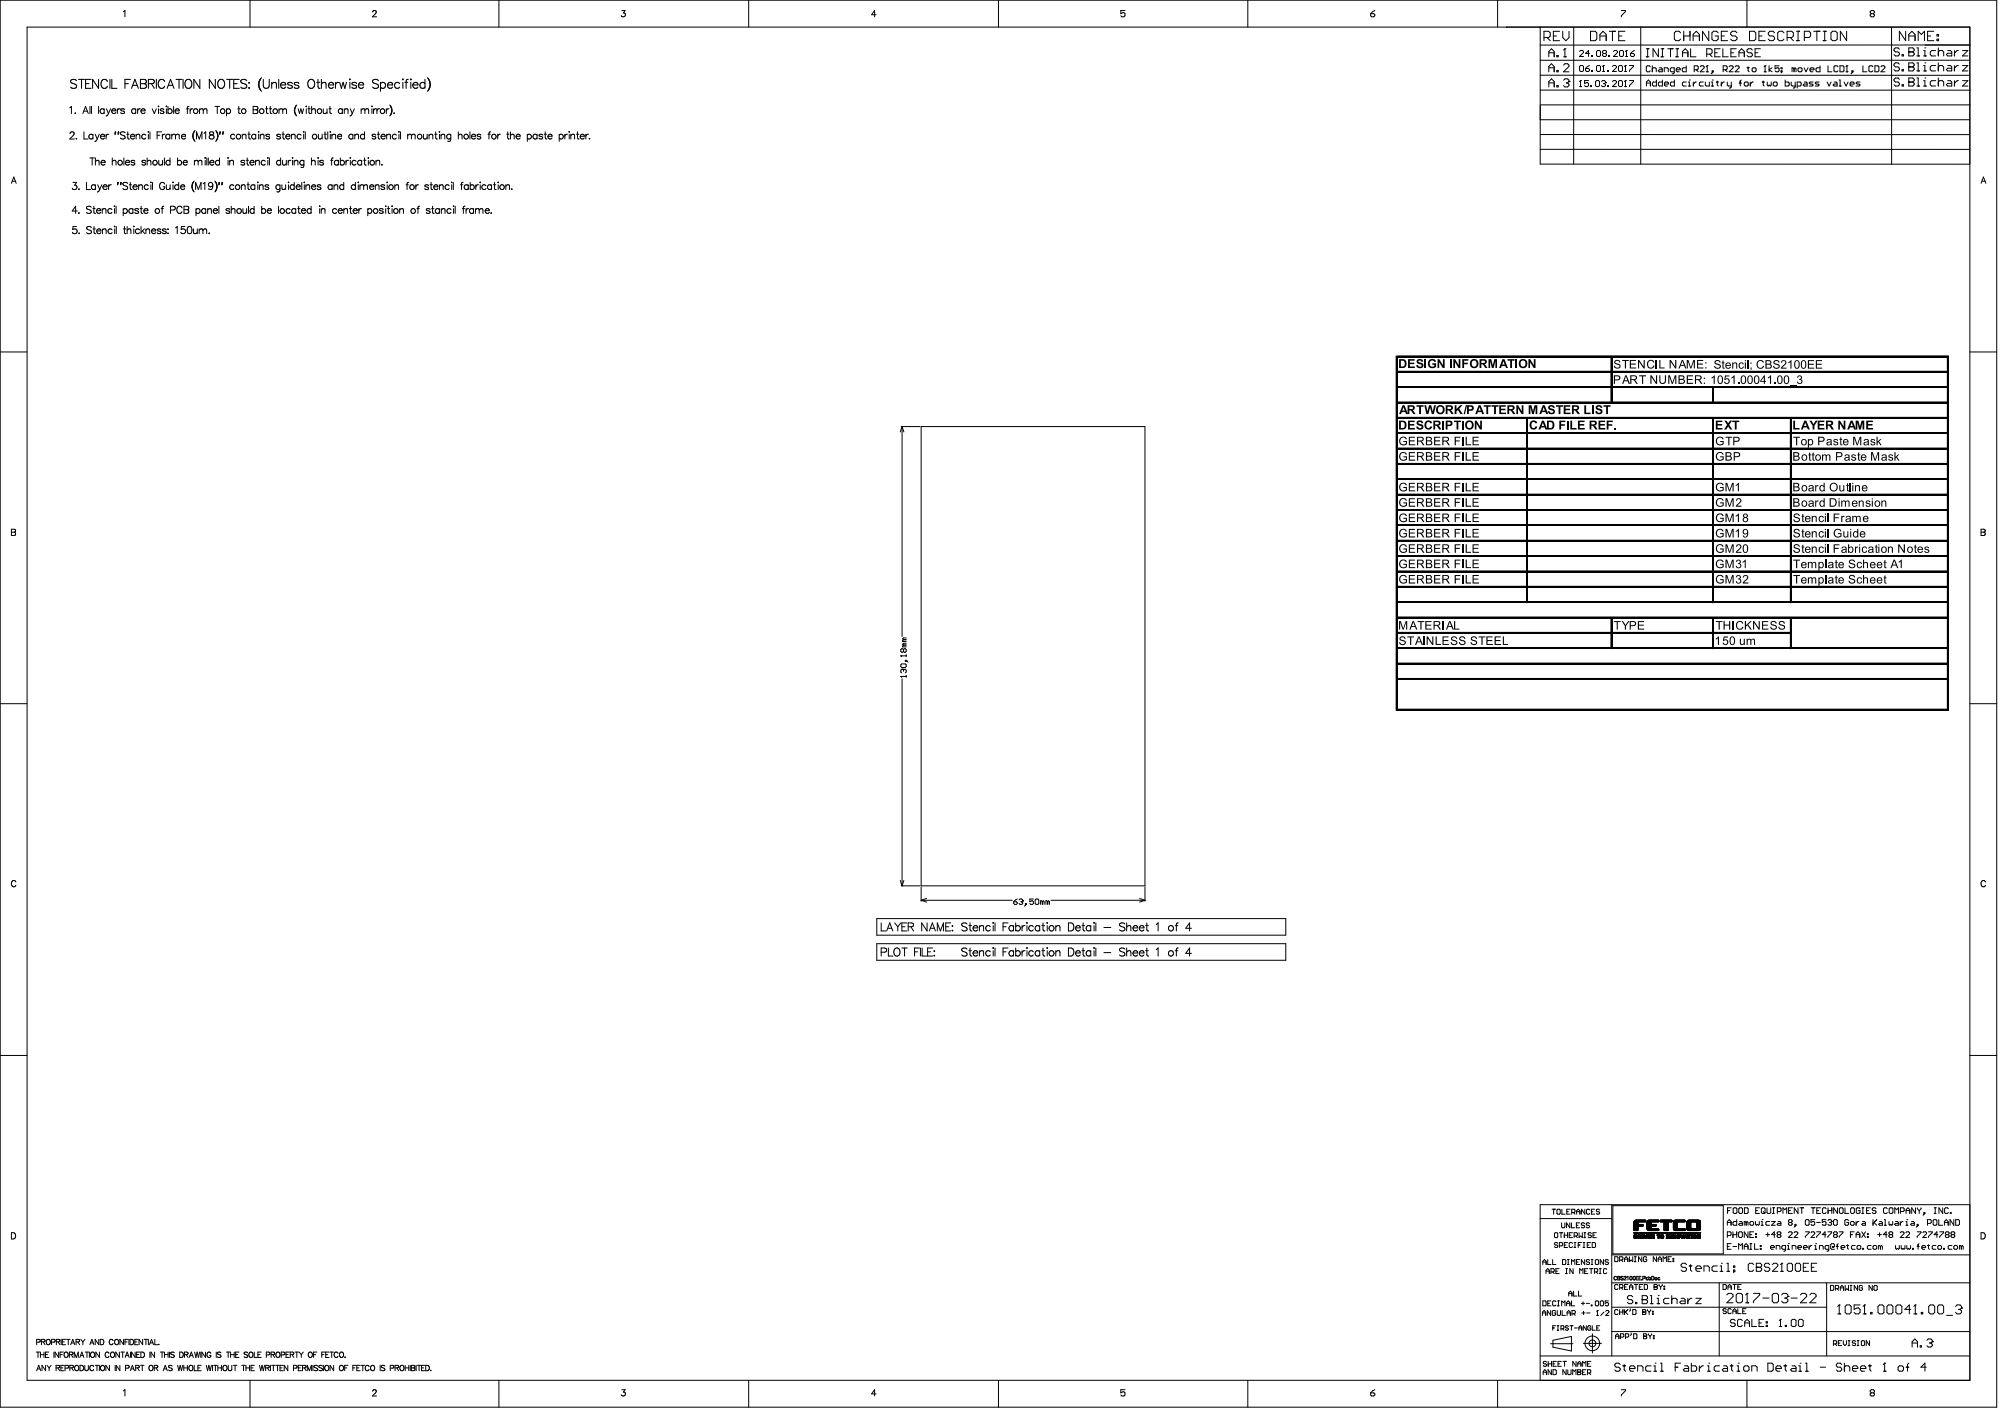
[picture p105: page 1]
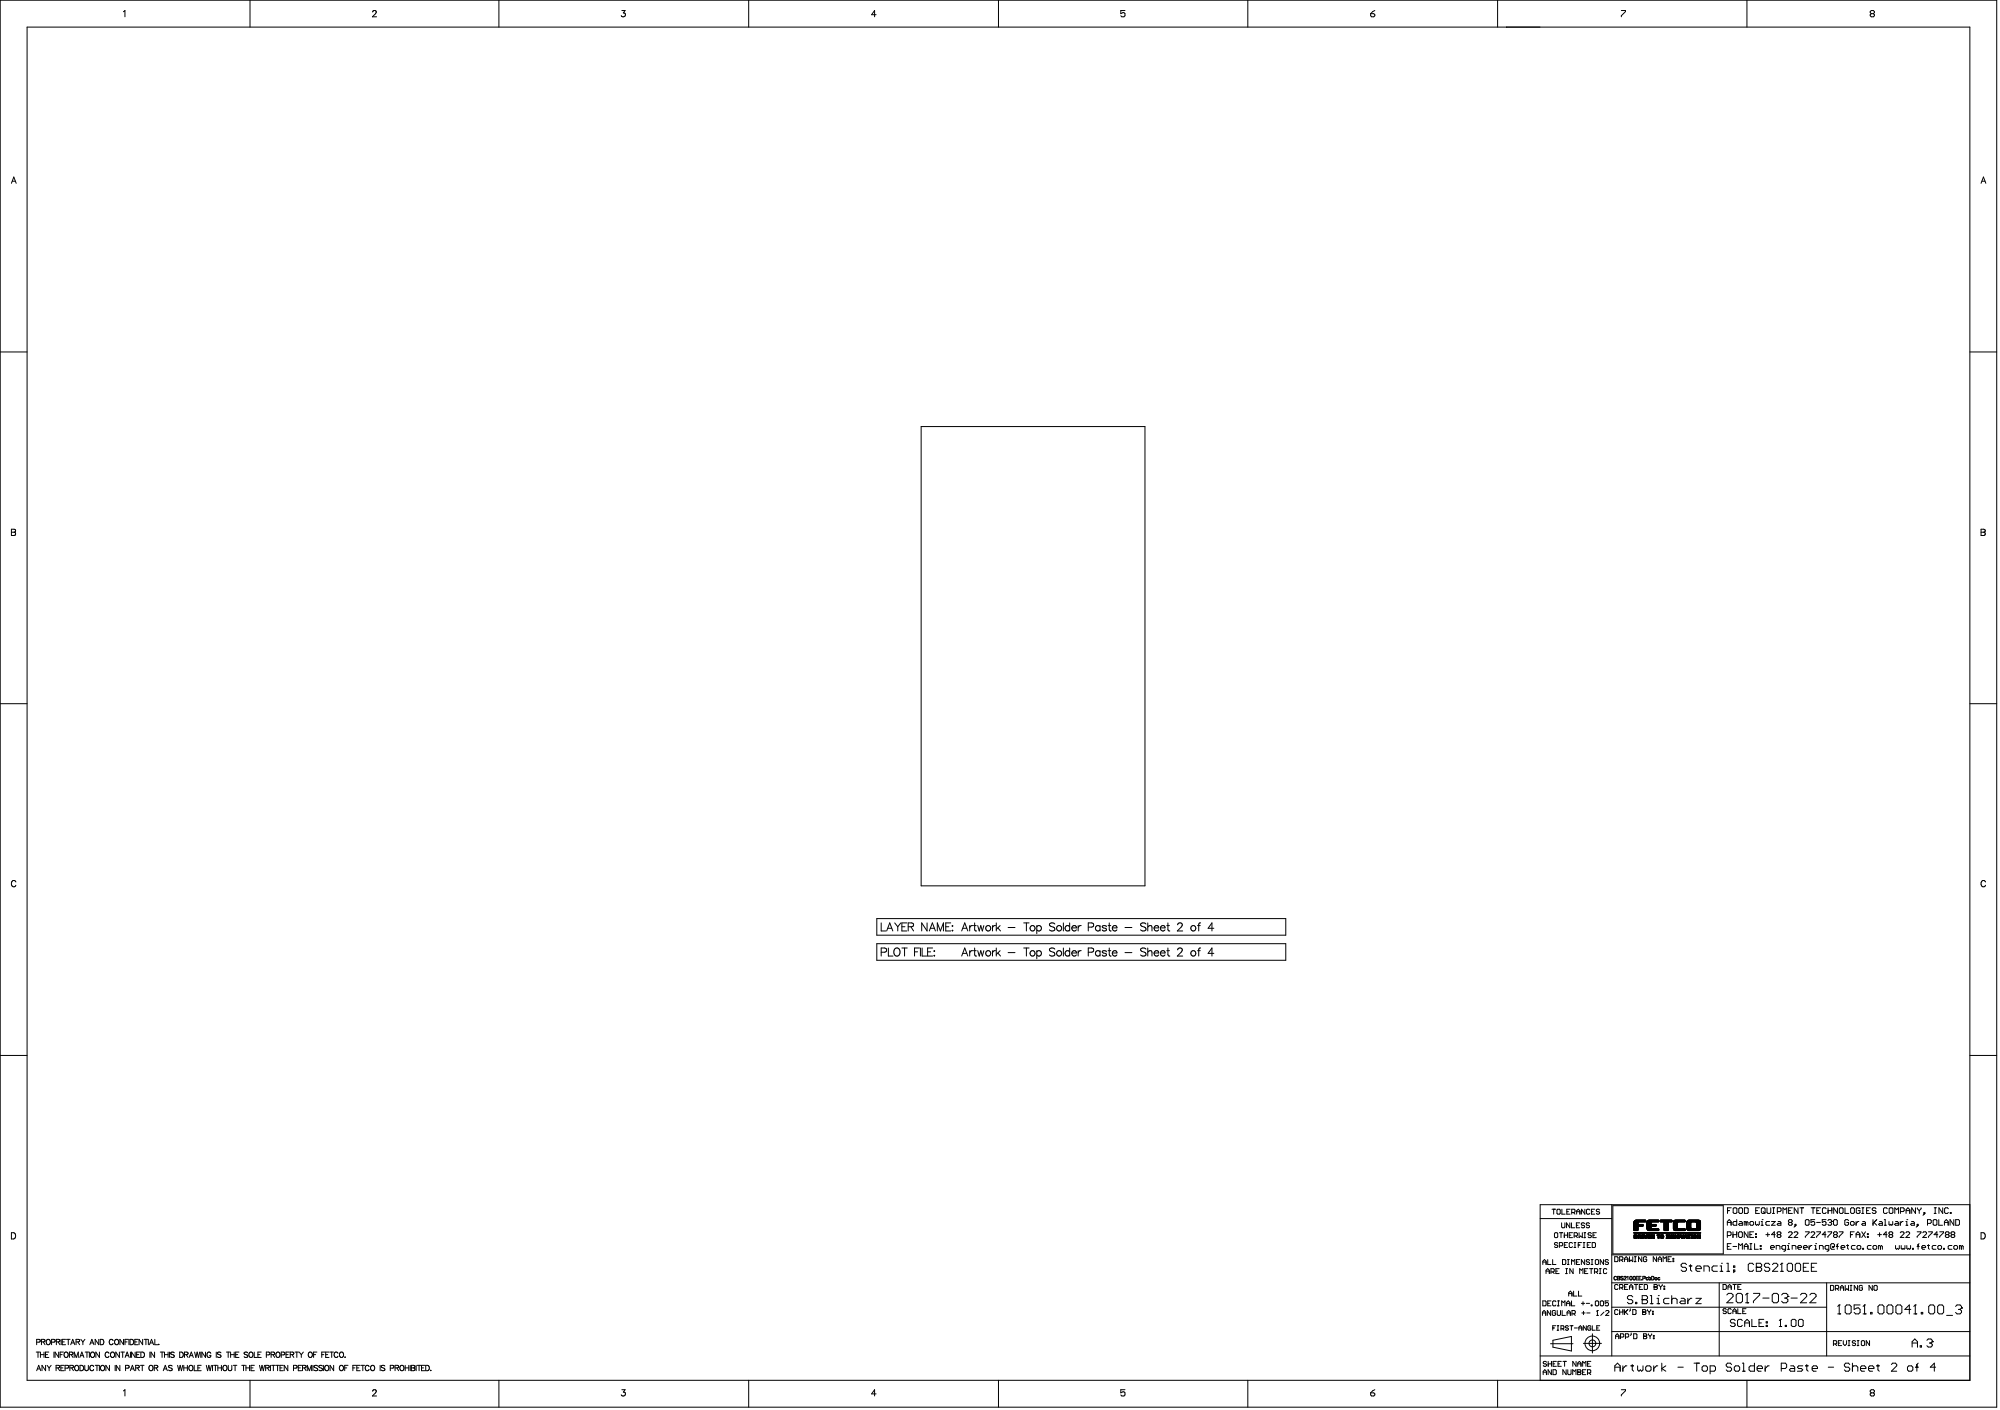
[picture p106: page 2]
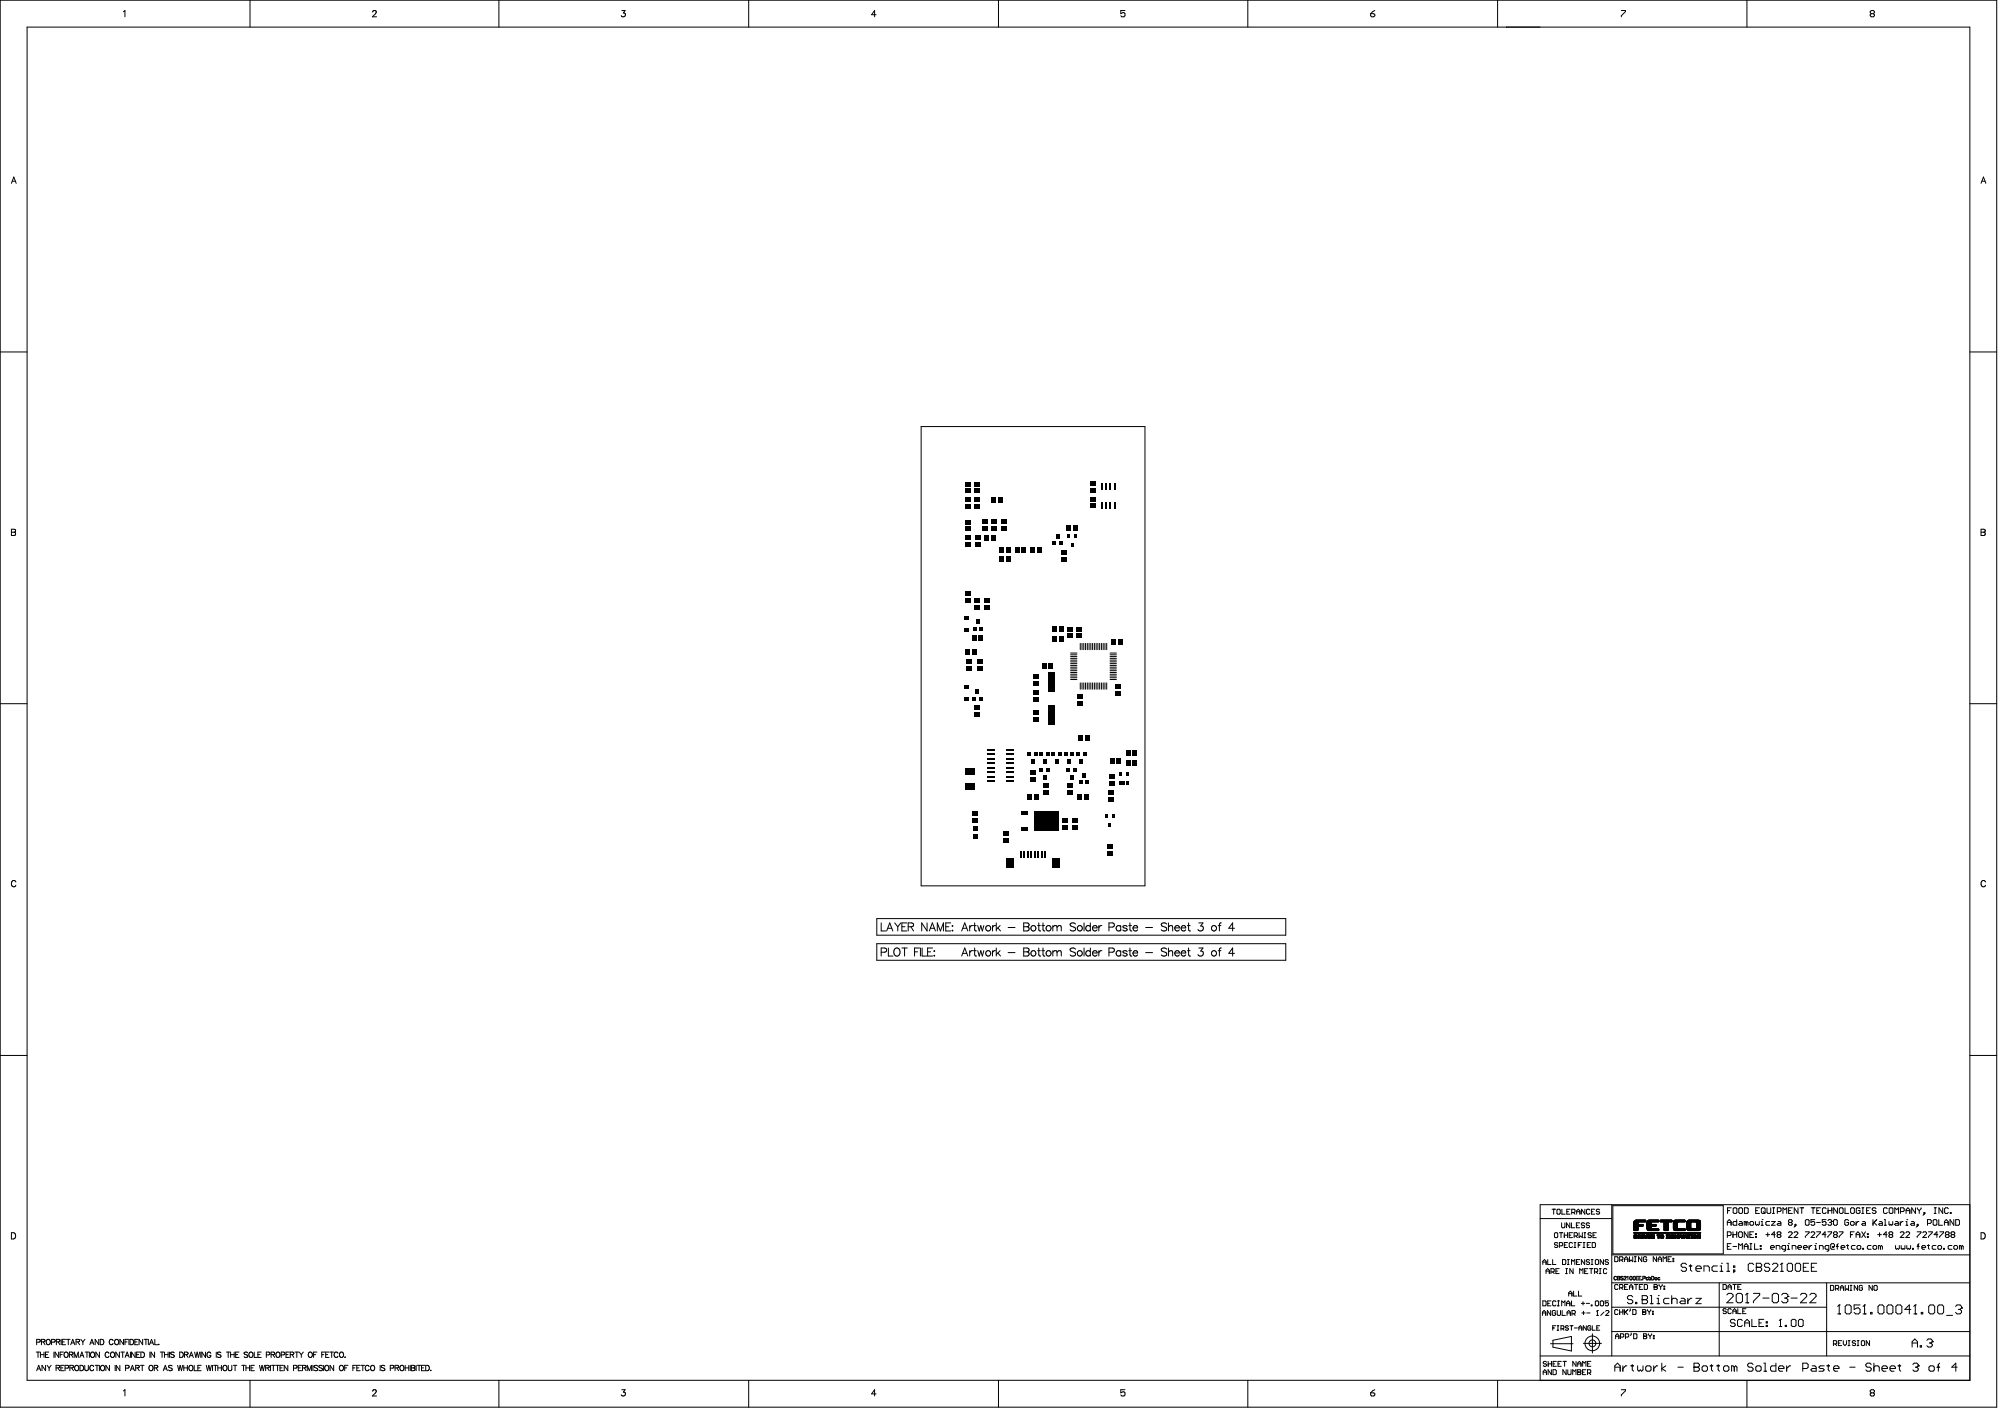
[picture p107: page 3]
