rhoppel/CBS-1100-XV_git/Released/Drawings/1102 (SUB ASSEMBLIES)/1102.00371.00.pdf

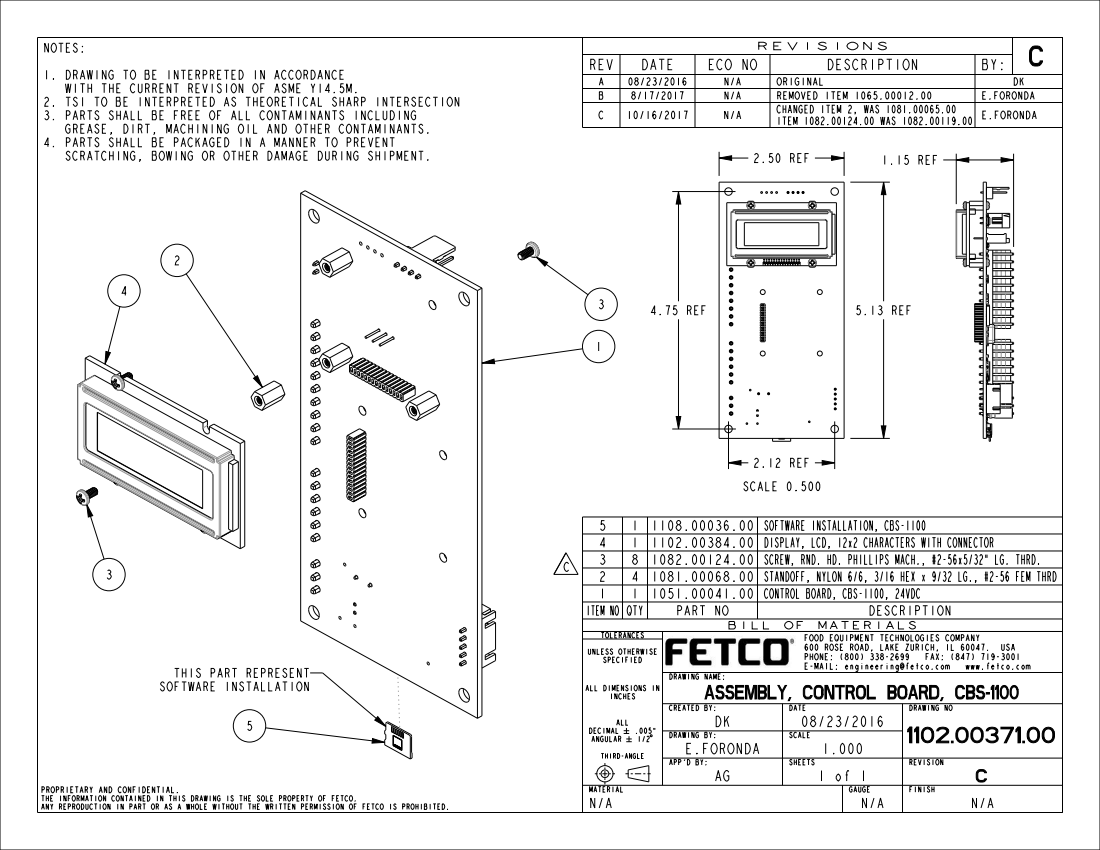
[picture p69: page 1]
4.75 REF; 5.13 REF; 2.12 REF; 2.50 REF; 1.15 REF; TOLERANCES; FOOD EQUIPMENT; TECHNOLOGIES COMPANY; 600 ROSE; ROAD, LAKE; ZURICH, IL; 60047. USA; DRAWING NAME:; INCHES; ASSEMBLY, CONTROL; BOARD, CBS-1100 CREATED BY:; DATE; DRAWING NO; ALL DECIMAL #-; ANGULAR #-; 08/23/2016 DRAWING BY:; SCALE; E.FORONDA; 1.000 THIRD-ANGLE; APP'D BY:; SHEETS; REVISION; C MATERIAL; GAUGE; FINISH; C REVISIONS; REV DATE; ECO NO; DESCRIPTION; ORIGINAL; REMOVED ITEM 1065.00012.00; CHANGED ITEM 2, WAS 1081.00065.00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

NOTES:
1. DRAWING TO BE INTERPRETED IN ACCORDANCE
2. TSI TO BE INTERPRETED AS THEORETICAL SHARP INTERSECTION
3. PARTS SHALL BE FREE OF ALL CONTAMINANTS INCLUDING
GREASE, DIRT, MACHINING OIL AND OTHER CONTAMINANTS.
4. PARTS SHALL BE PACKAGED IN A MANNER TO PREVENT
SCRATCHING, BOWING OR OTHER DAMAGE DURING SHIPMENT.

ITEM 1082.00124.00 WAS 1082.00119.00 E.FORONDA

5 1 1108.00036.00 SOFTWARE INSTALLATION, CBS-1100
4 1 1102.00384.00 DISPLAY, LCD, 12x2 CHARACTERS WITH CONNECTOR
3 8 1082.00124.00 SCREW, RND. HD. PHILLIPS MACH., #2-56x5/32" LG. THRD.
2 4 1081.00068.00 STANDOFF, NYLON 6/6, 3/16 HEX x 9/32 LG., #2-56 FEM THRD
1 1 1051.00041.00 CONTROL BOARD, CBS-1100, 24VDC

BILL OF MATERIALS

UNLESS OTHERWISE
SPECIFIED
ALL DIMENSIONS IN

PHONE: (800) 338-2699 FAX: (847) 719-3001
E-MAIL: engineering @fetco.com www.fetco.com

THIS PART REPRESENT
SOFTWARE INSTALLATION

PROPRIETARY AND CONFIDENTIAL.
THE INFORMATION CONTAINED IN THIS DRAWING IS THE SOLE PROPERTY OF FETCO.
ANY REPRODUCTION IN PART OR AS A WHOLE WITHOUT THE WRITTEN PERMISSION OF FETCO IS PROHIBITED.
