rhoppel/CBS-1100-XV_git/Released/Drawings/1102 (SUB ASSEMBLIES)/1102.00372.00.pdf

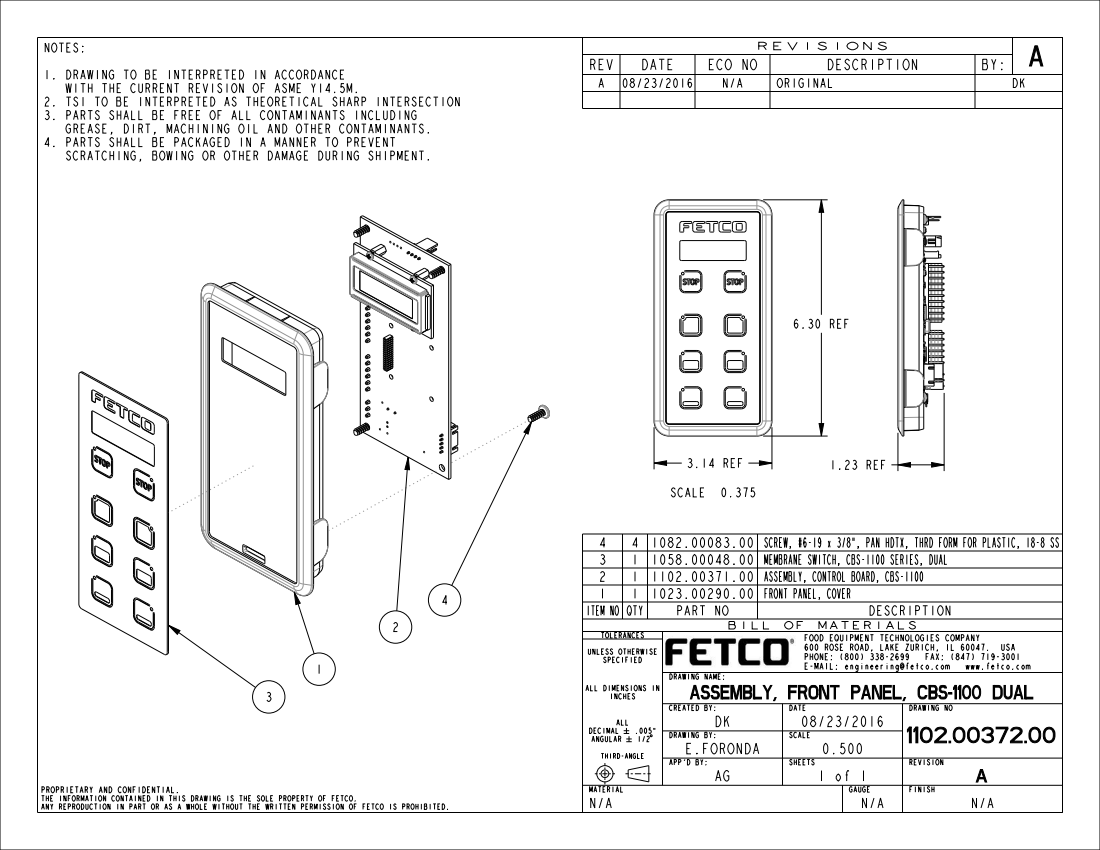
[picture p70: page 1]
3.14 REF; 6.30 REF; 1.23 REF; TOLERANCES; FOOD EQUIPMENT; TECHNOLOGIES COMPANY; 600 ROSE; ROAD, LAKE; ZURICH, IL; 60047. USA; DRAWING NAME:; INCHES; ASSEMBLY, FRONT; PANEL, CBS-1100 DUAL; CREATED BY:; DATE; DRAWING NO; ALL DECIMAL #-; ANGULAR #-; 08/23/2016 DRAWING BY:; SCALE; E.FORONDA; 0.500 THIRD-ANGLE; APP'D BY:; SHEETS; REVISION; A MATERIAL; GAUGE; FINISH; A REVISIONS; REV DATE; ECO NO; DESCRIPTION; ORIGINAL; ITEM NO QTY; PART NO; WITH; THE CURRENT; REVISION OF ASME Y14.5M.; SCALE 0.375

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

4 4 1082.00083.00 SCREW, #6-19 x 3/8", PAN HDTX, THRD FORM FOR PLASTIC, 18-8 SS
3 1 1058.00048.00 MEMBRANE SWITCH, CBS-1100 SERIES, DUAL
2 1 1102.00371.00 ASSEMBLY, CONTROL BOARD, CBS-1100
1 1 1023.00290.00 FRONT PANEL, COVER

BILL OF MATERIALS

UNLESS OTHERWISE
SPECIFIED
ALL DIMENSIONS IN

PHONE: (800) 338-2699 FAX: (847) 719-3001
E-MAIL: engineering @fetco.com www.fetco.com

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
