rhoppel/CBS-1100-XV_git/Released/Drawings/1102 (SUB ASSEMBLIES)/1102.00384.00.pdf

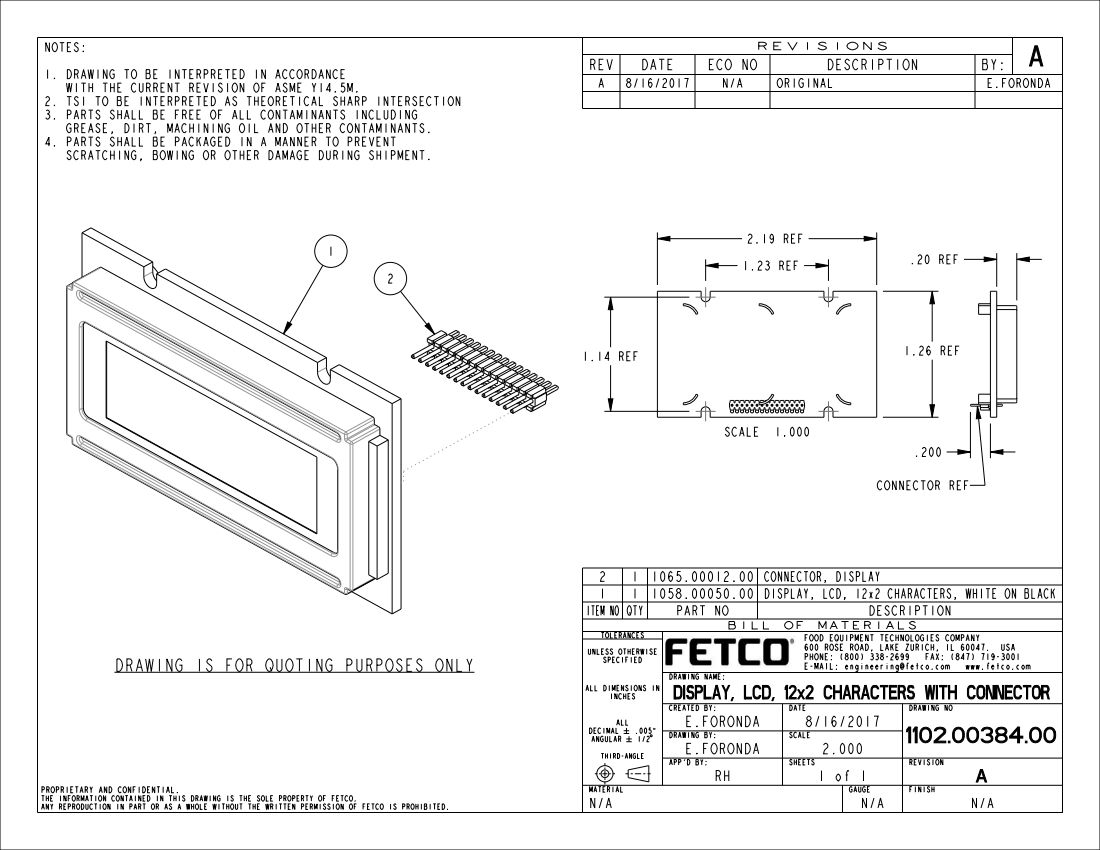
[picture p71: page 1]
.20 REF; 1.26 REF; 2.19 REF 1.23 REF; 1.14 REF; TOLERANCES; FOOD EQUIPMENT; TECHNOLOGIES COMPANY; 600 ROSE; ROAD, LAKE; ZURICH, IL; 60047. USA; INCHES; DISPLAY, LCD,; CHARACTERS; WITH CONNECTOR; ALL DECIMAL #-; ANGULAR #-; A MATERIAL; GAUGE; FINISH; A REVISIONS; ITEM NO; QTY; PART NO; DESCRIPTION; WITH; THE CURRENT; REVISION OF ASME Y14.5M.; SCALE 1.000; CONNECTOR REF

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

REV | DATE | ECO NO | DESCRIPTION | | BY:
A | 8/16/2017 | | N/A | ORIGINAL | E.FORONDA

2 | 1 | | 1065.00012.00 | | CONNECTOR, DISPLAY
1 | | 1 | | 1058.00050.00 | DISPLAY, LCD, 12x2 CHARACTERS, WHITE ON BLACK

BILL OF MATERIALS

UNLESS OTHERWISE
SPECIFIED
ALL DIMENSIONS IN

PHONE: (800) 338-2699 FAX: (847) 719-3001
E-MAIL: engineering @fetco.com www.fetco.com

DRAWING IS FOR QUOTING PURPOSES ONLY

DRAWING NAME:

CREATED BY: E.FORONDA | DATE SCALE 8/16/2017 DRAWING BY: | | 1102.00384.00 | DRAWING NO REVISION

APP'D BY: E.FORONDA | SHEETS 2.000 THIRD-ANGLE

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
