rhoppel/CBS-1100-XV_git/Released/DisplayAssembly/Drawings/1065 (CONNECTOR)/1065.00012.00.pdf

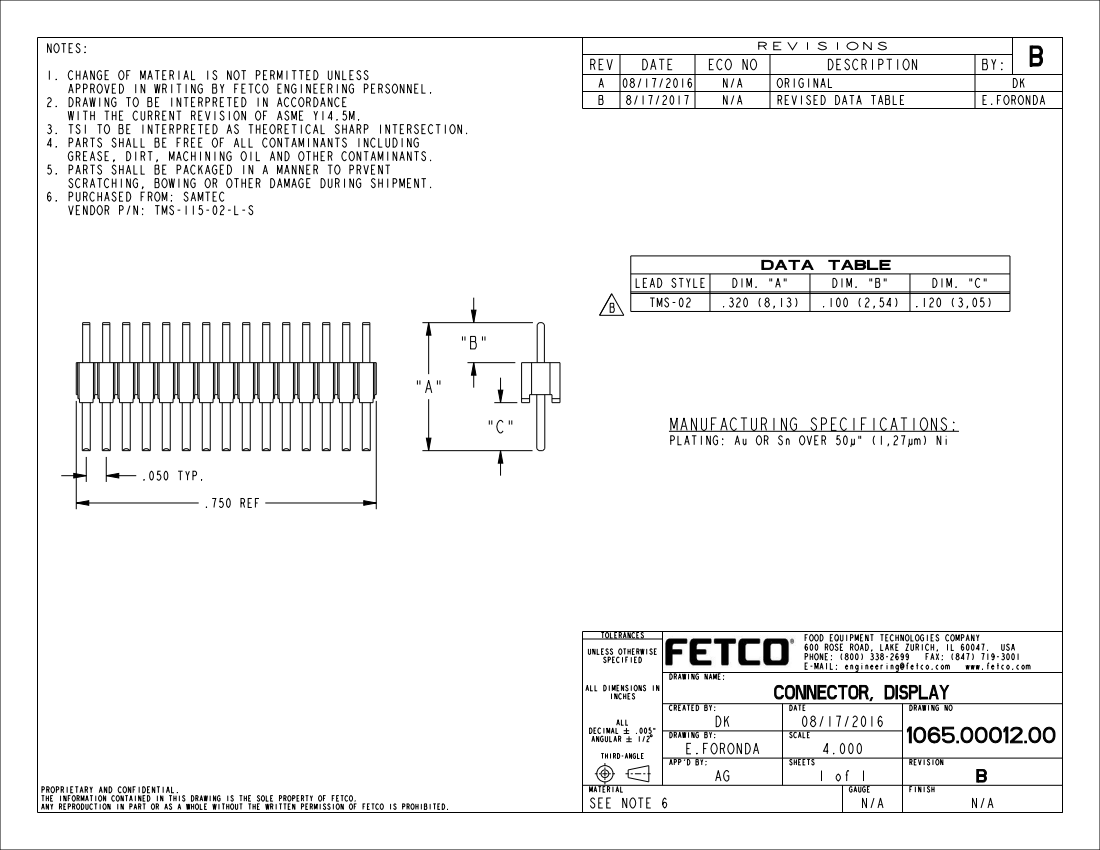
[picture p72: page 1]
.750 REF; .050 TYP.; TOLERANCES; FOOD EQUIPMENT; TECHNOLOGIES COMPANY; 600 ROSE; ROAD, LAKE; ZURICH, IL; 60047. USA; UNLESS OTHERWISE SPECIFIED; INCHES; CONNECTOR,; DISPLAY CREATED BY:; DATE; DRAWING NO; ALL DECIMAL #-; ANGULAR #-; B MATERIAL; GAUGE; FINISH; B REVISIONS; DATA TABLE; 1. CHANGE OF MATERIAL IS NOT; PERMITTED UNLESS; WITH; THE CURRENT; REVISION OF ASME Y14.5M.; MANUFACTURING SPECIFICATIONS:; PLATING: Au; OR Sn OVER 50µ" (1,27µm) Ni

NOTES:
APPROVED IN WRITING BY FETCO ENGINEERING PERSONNEL.
2. DRAWING TO BE INTERPRETED IN ACCORDANCE
3. TSI TO BE INTERPRETED AS THEORETICAL SHARP INTERSECTION.
4. PARTS SHALL BE FREE OF ALL CONTAMINANTS INCLUDING
GREASE, DIRT, MACHINING OIL AND OTHER CONTAMINANTS.
5. PARTS SHALL BE PACKAGED IN A MANNER TO PRVENT
SCRATCHING, BOWING OR OTHER DAMAGE DURING SHIPMENT.
6. PURCHASED FROM: SAMTEC
VENDOR P/N: TMS-115-02-L-S

REV | DATE | ECO NO | DESCRIPTION | | BY:
A | 08/17/2016 | | N/A | ORIGINAL | DK
B | 8/17/2017 | | N/A | REVISED DATA TABLE | | E.FORONDA

LEAD STYLE | DIM. "A" | DIM. "B" | DIM. "C"
TMS-02 | .320 (8,13) | .100 (2,54) | .120 (3,05)

PHONE: (800) 338-2699 FAX: (847) 719-3001
E-MAIL: engineering @fetco.com www.fetco.com

DRAWING NAME:

ALL DIMENSIONS IN

DK | SCALE 08/17/2016 DRAWING BY: 1065.00012.00 | REVISION

APP'D BY: E.FORONDA | SHEETS 4.000 THIRD-ANGLE

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

SEE NOTE 6 | | N/A | N/A
