rhoppel/CBS-1100-XV_git/Released/DisplayAssembly/Drawings/1082 (SCREWS)/1082.00083.00.pdf

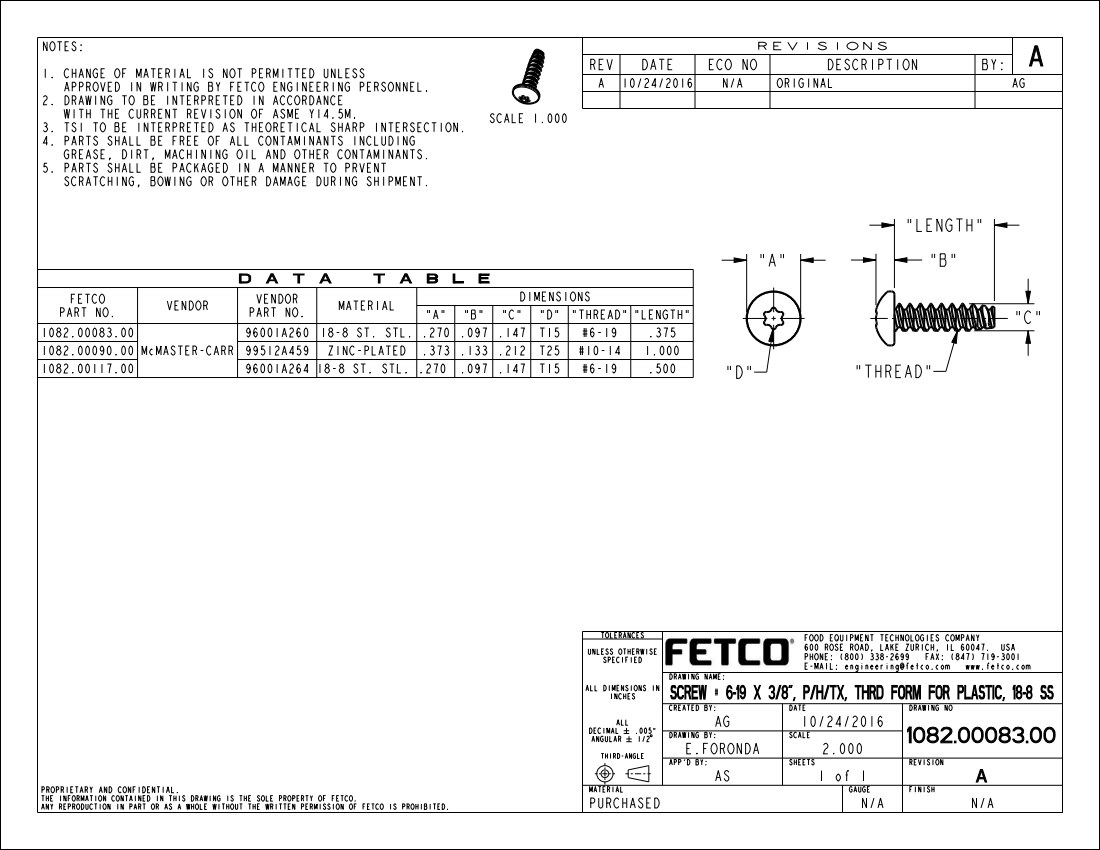
[picture p73: page 1]
"LENGTH"; TOLERANCES; FOOD EQUIPMENT; TECHNOLOGIES COMPANY; 600 ROSE; ROAD, LAKE; ZURICH, IL; 60047. USA; INCHES SCREW # 6-19 X 3/8", P/H/TX, THRD FORM FOR PLASTIC, 18-8 SS CREATED BY:; DATE; DRAWING NO; ALL DECIMAL #-; ANGULAR #-; A MATERIAL; GAUGE; FINISH; A REVISIONS; 18-8 ST. STL.; ZINC-PLATED; 1. CHANGE OF MATERIAL IS NOT; PERMITTED UNLESS; WITH; THE CURRENT; REVISION OF ASME Y14.5M.; "THREAD"; SCALE 1.000

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

REV | DATE | ECO NO | DESCRIPTION | | BY:
A | 10/24/2016 | N/A | ORIGINAL | AG

PART NO. FETCO | | VENDOR | VENDOR PART NO. | MATERIAL | DIMENSIONS

"A" | "B" | "C" | "D" | "THREAD" | | "LENGTH"

McMASTER-CARR

UNLESS OTHERWISE
SPECIFIED
ALL DIMENSIONS IN

PHONE: (800) 338-2699 FAX: (847) 719-3001
E-MAIL: engineering @fetco.com www.fetco.com

DRAWING NAME:

AG | SCALE 10/24/2016 DRAWING BY: 1082.00083.00 | REVISION

APP'D BY: E.FORONDA | SHEETS 2.000 THIRD-ANGLE

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

PURCHASED | | N/A | N/A
