rhoppel/CBS-1100-XV_git/Released/DisplayAssembly/Switches/Membrane Switch/2017-01-10_TBS EE Overlay layouts.pdf

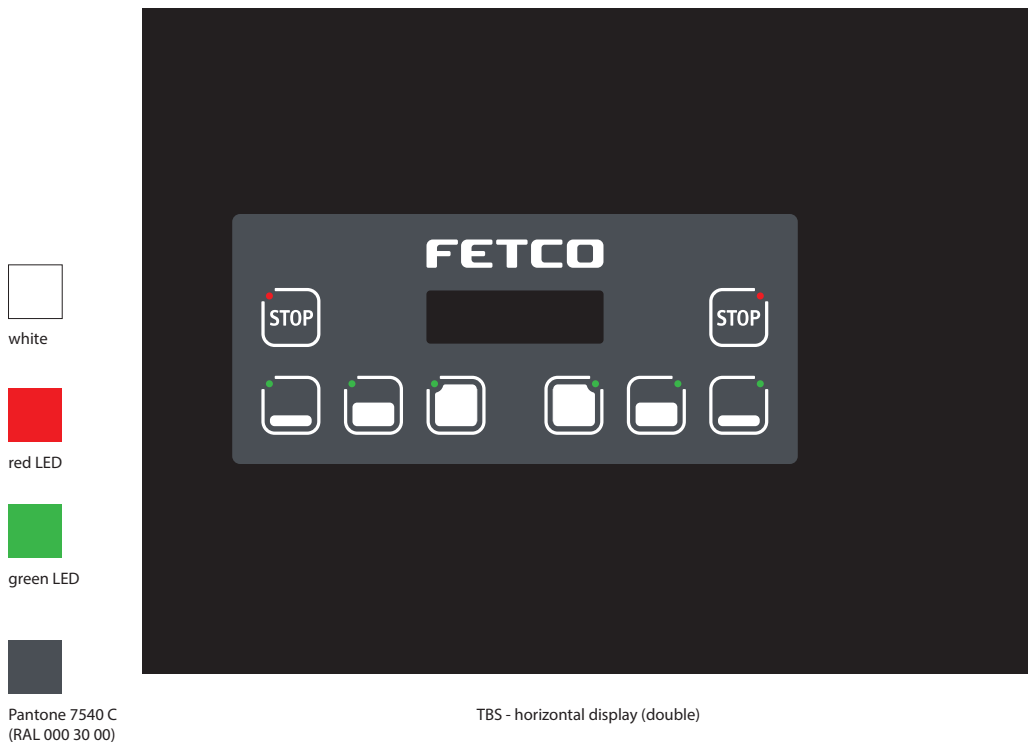
[picture p74: page 1]
Pantone 7540 C (RAL 000 30 00); red LED; green LED; white

TBS - horizontal display (double)

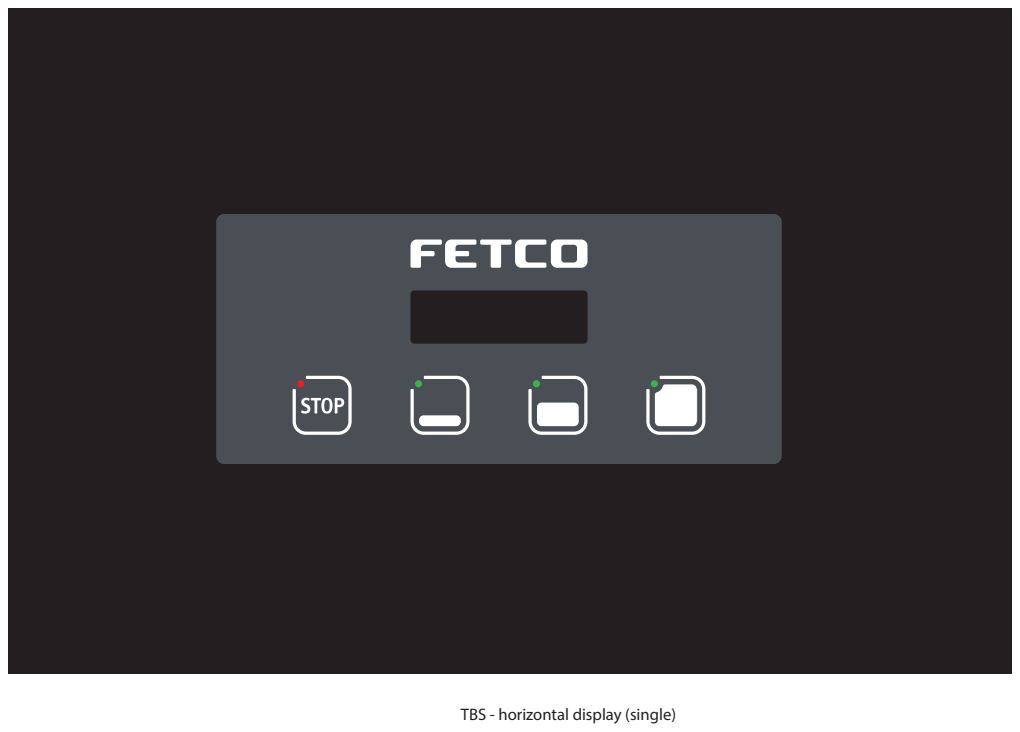
[picture p75: page 2]

TBS - horizontal display (single)
