rhoppel/CBS-1100-XV_git/Released/DisplayAssembly/Switches/Membrane Switch/Cbs_overlays .pdf

# A REVISIONS

REV | DATE | ECO NO | DESCRIPTION | BY:

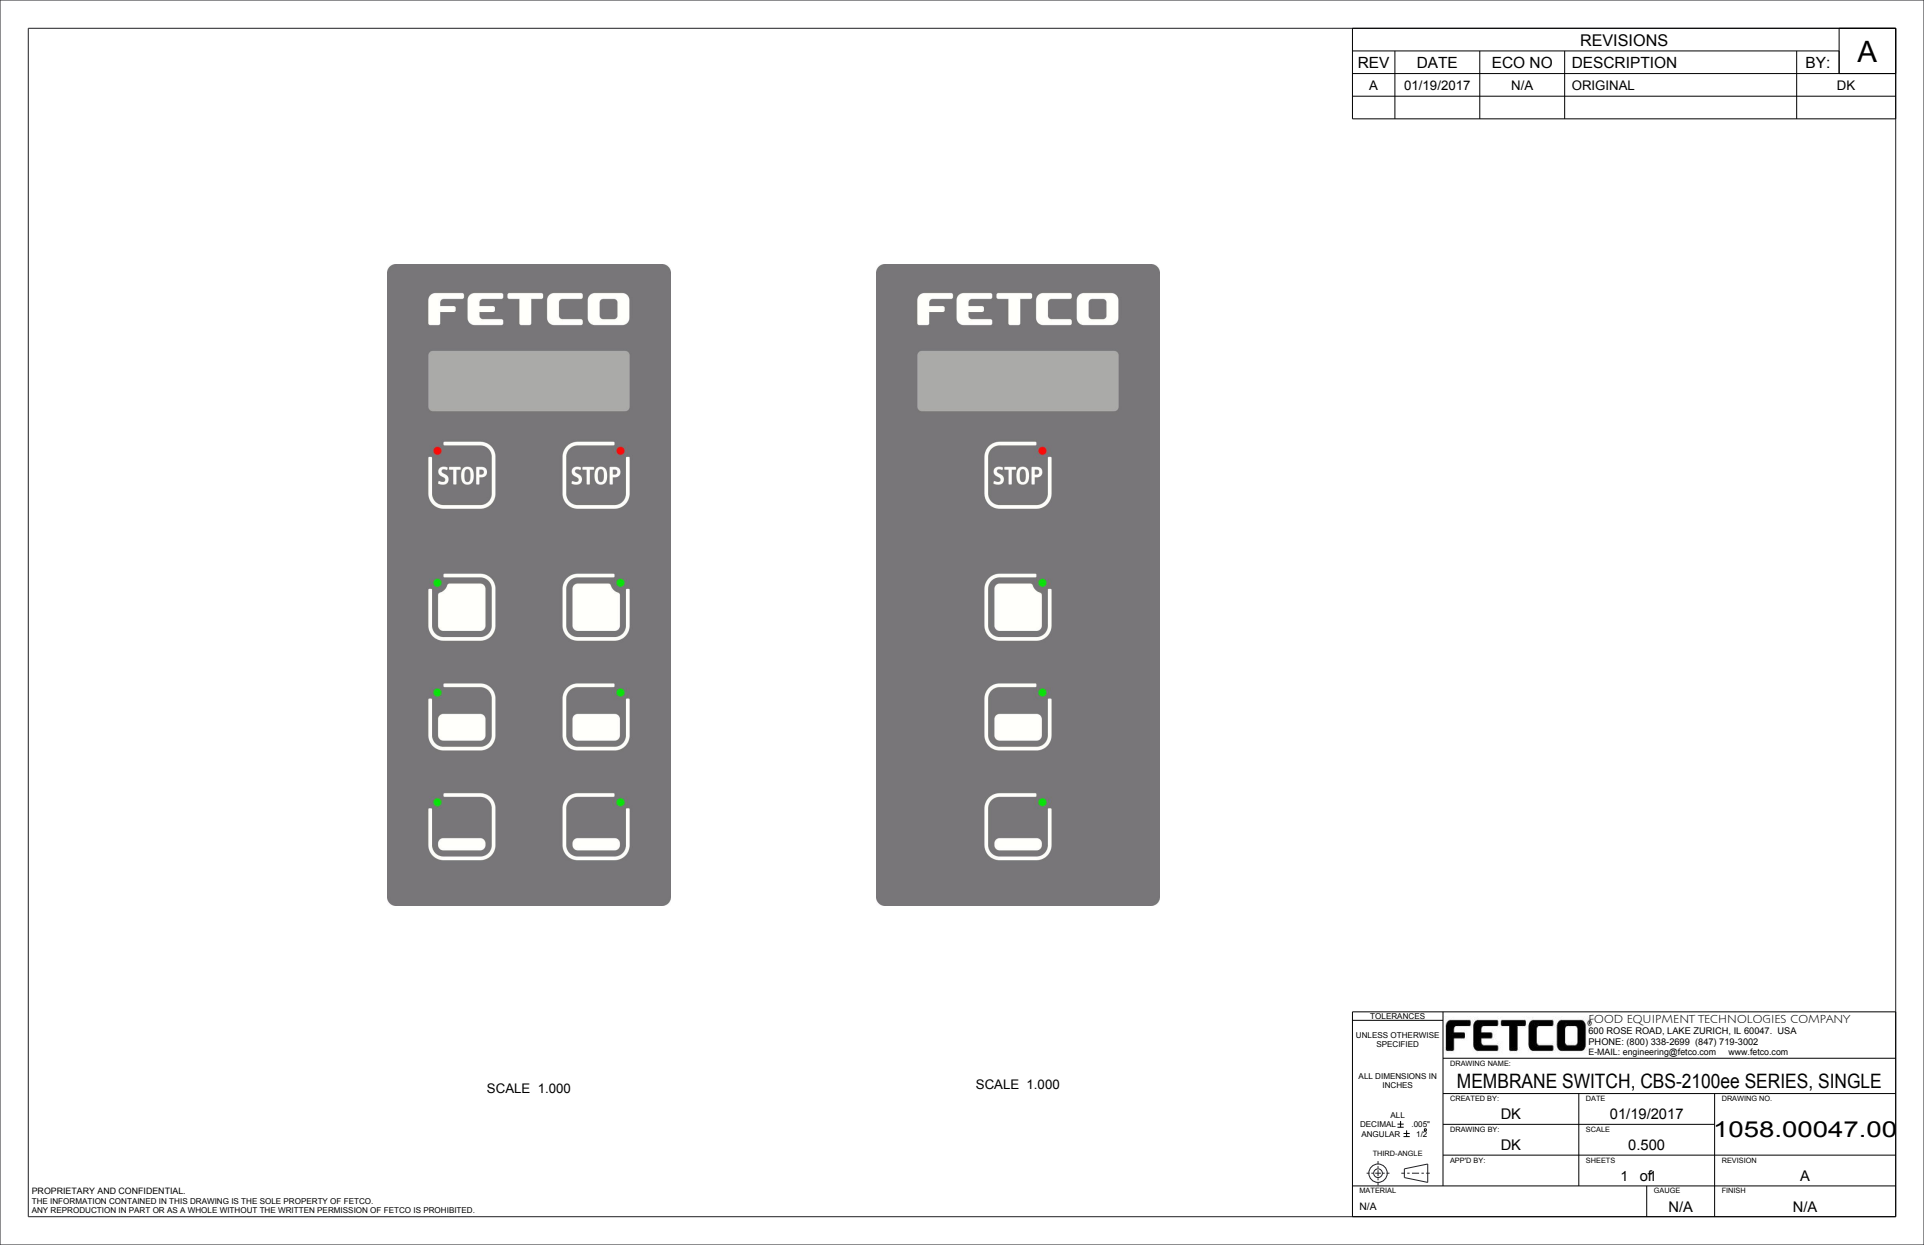
[picture p76: page 1]
TOLERANCES; FOOD EQUIPMENT TECHNOLOGIES COMPANY; DRAWING NAME:; INCHES; MEMBRANE SWITCH, CBS-2100ee SERIES, SINGLE; ALL; DECIMAL; ANGULAR; A MATERIAL; GAUGE; FINISH; SCALE 1.000

A | 01/19/2017 | N/A | ORIGINAL | DK

UNLESS OTHERWISE
SPECIFIED
ALL DIMENSIONS IN

600 ROSE ROAD, LAKE ZURICH, IL 60047. USA
PHONE: (800) 338-2699 (847) 719-3002
E-MAIL: engineering@fetco.com www.fetco.com

CREATED BY: DK | DATE SCALE 01/19/2017 DRAWING BY: | DRAWING NO. 1058.00047.00 REVISION

APP'D BY: DK | SHEETS 0.500 THIRD-ANGLE

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
