rhoppel/CBS-1100-XV_git/Released/DisplayAssembly/Switches/Membrane Switch/UA-1241-R3 PRODUCT DRAWING.PDF

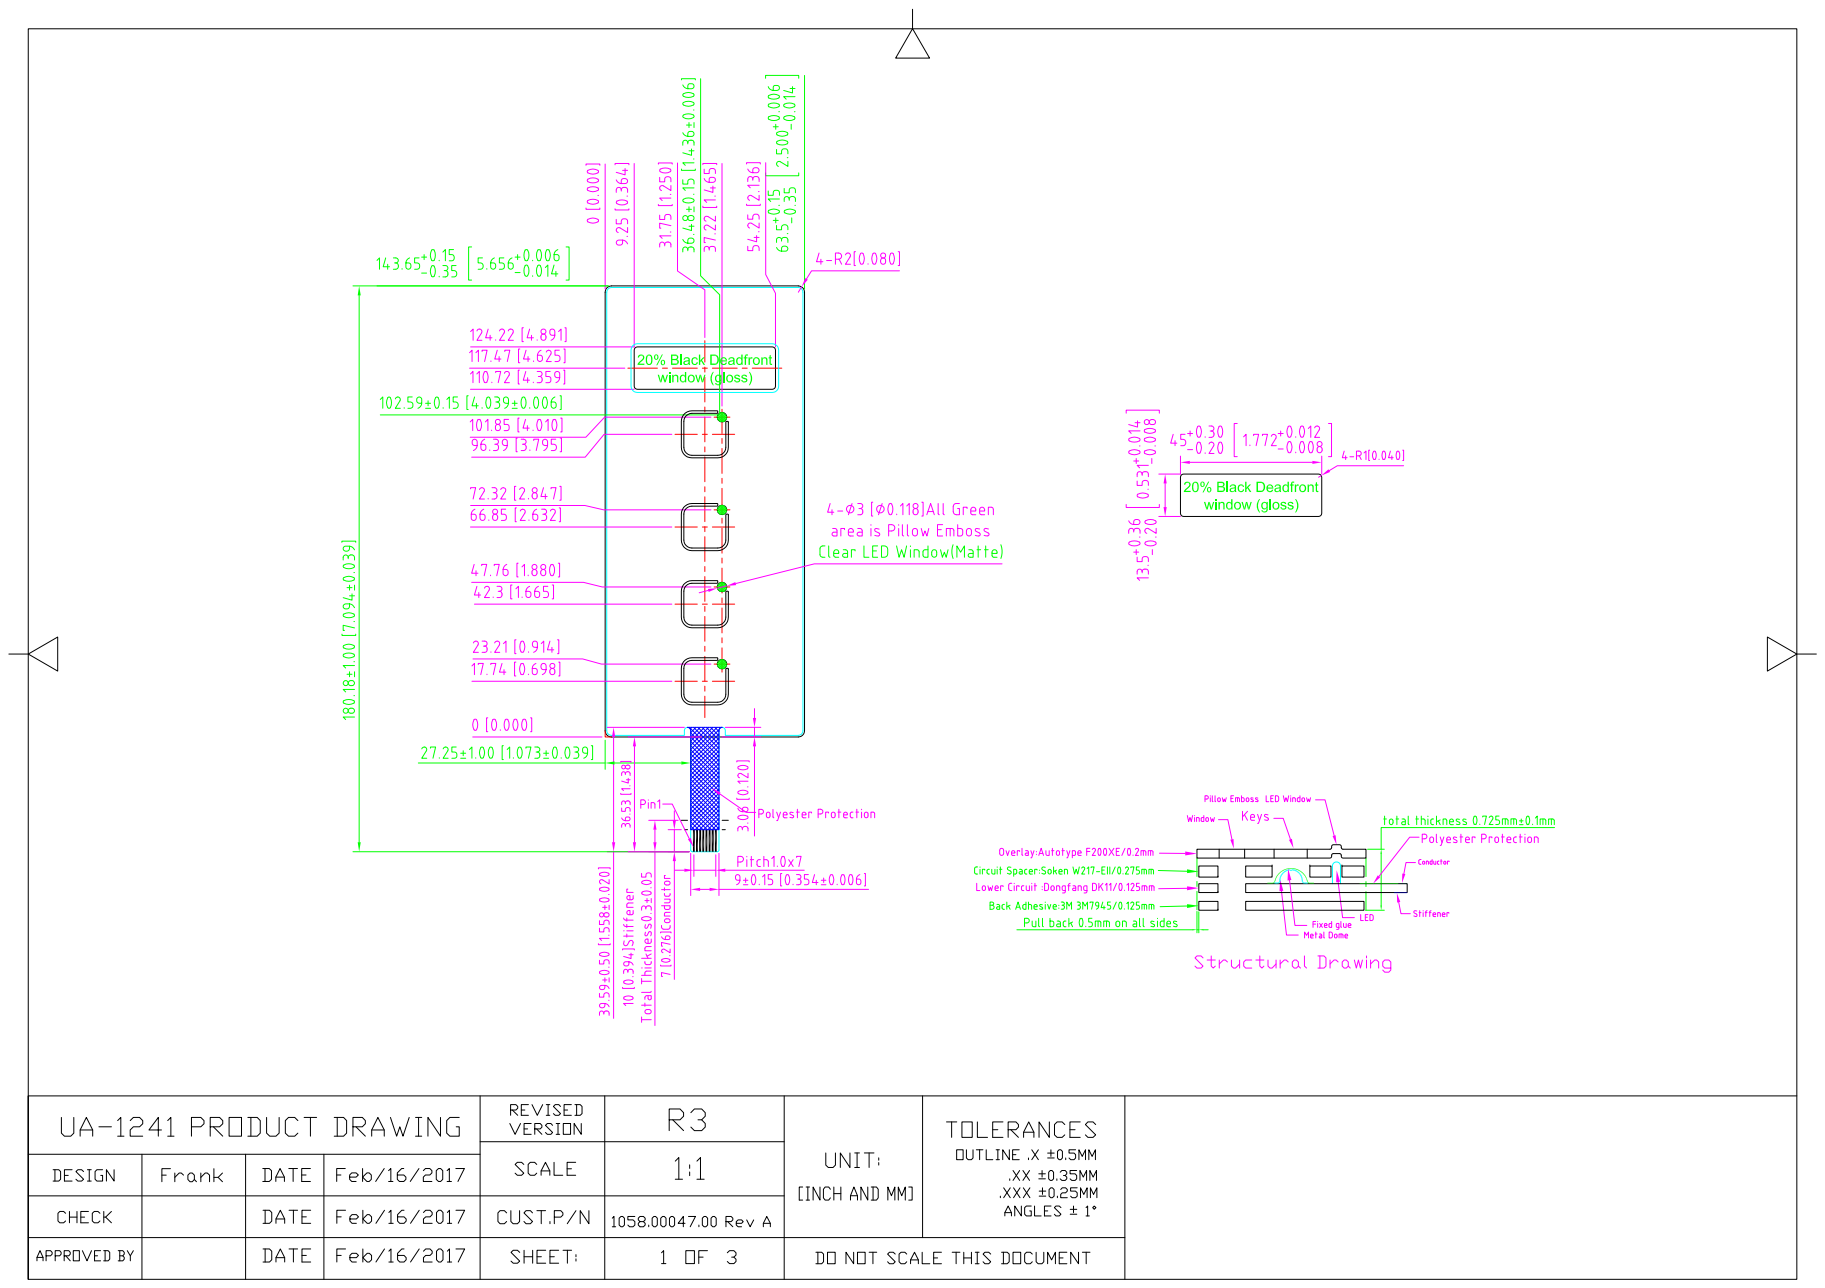
[picture p77: page 1]

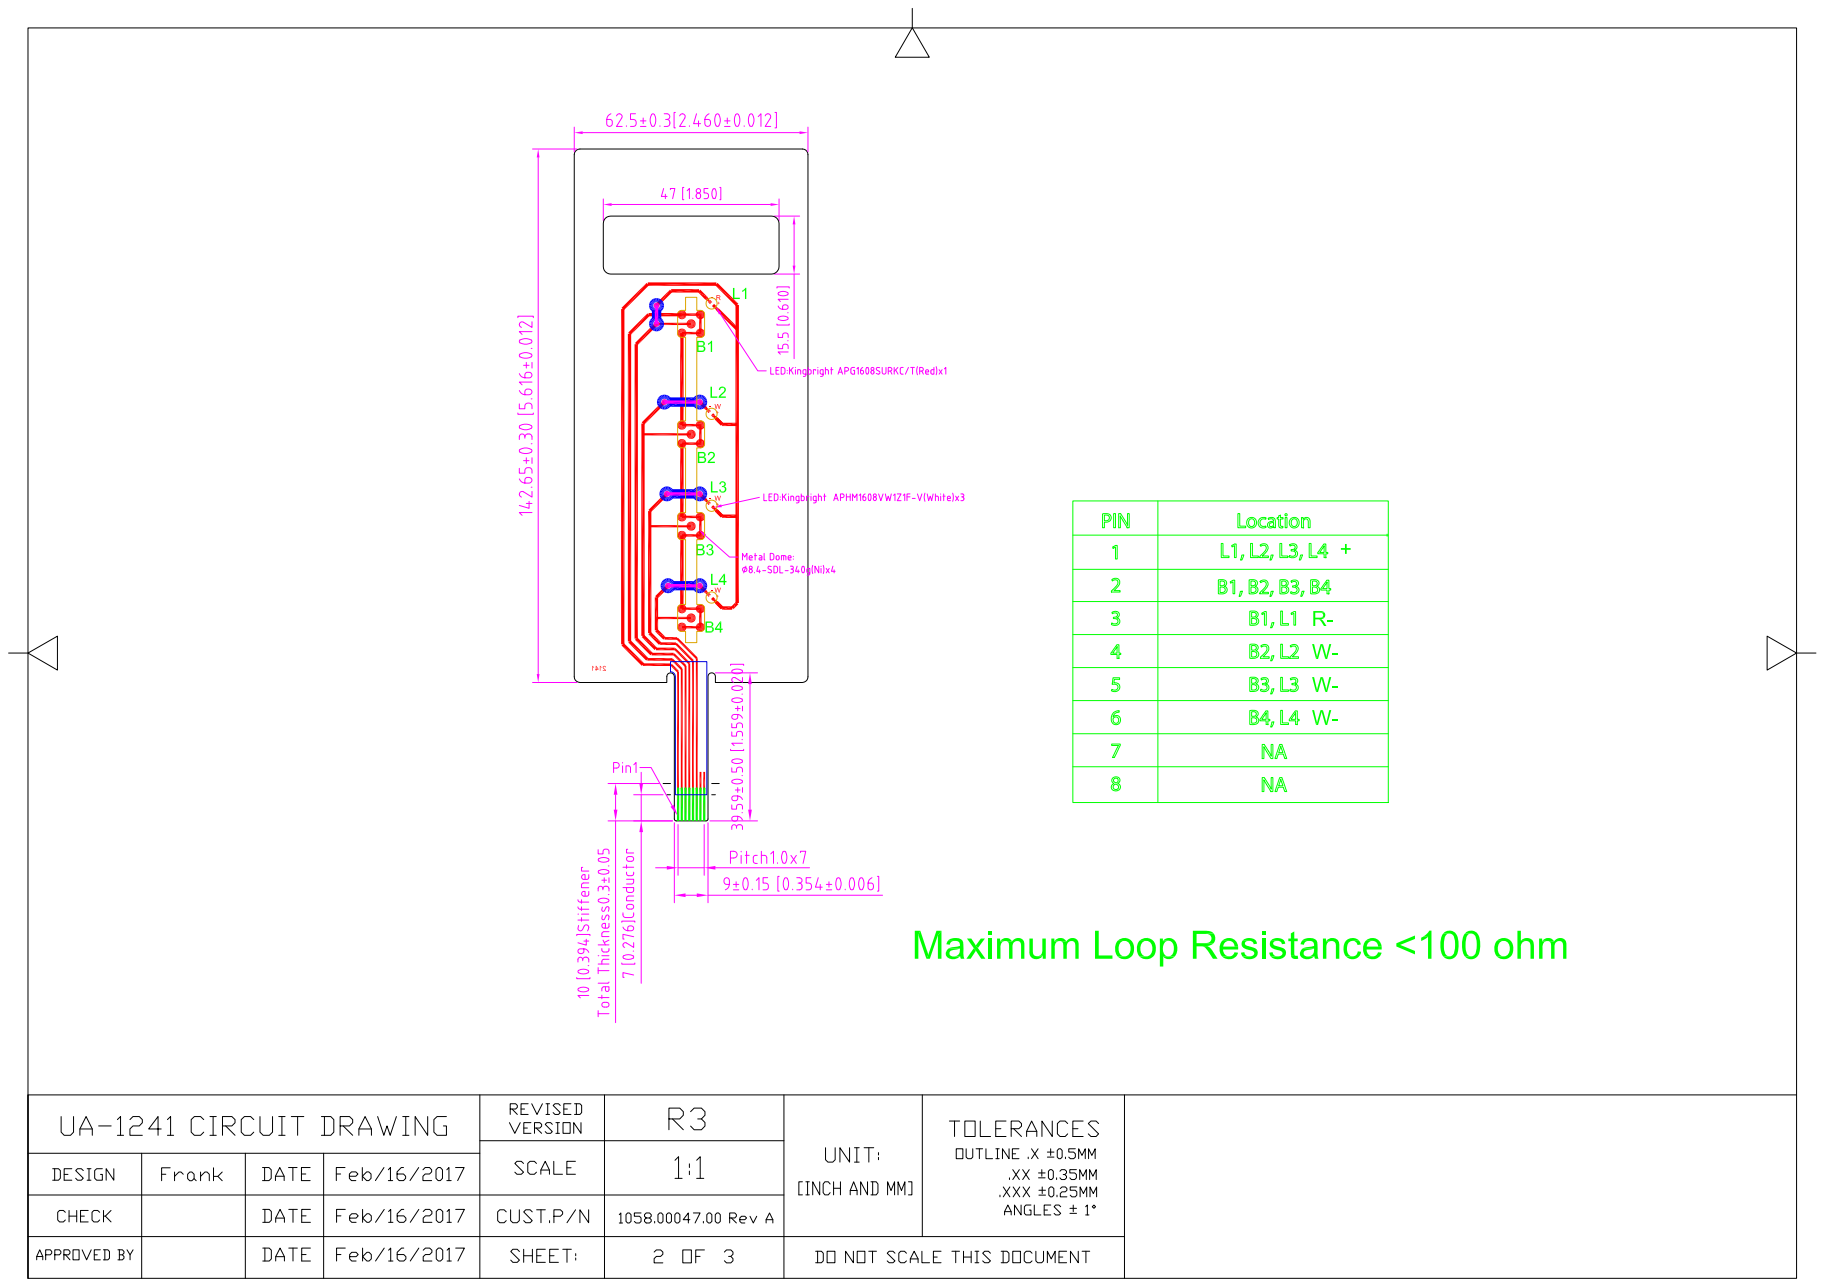
[picture p78: page 2]

## 20% Black Deadfront window (gloss)

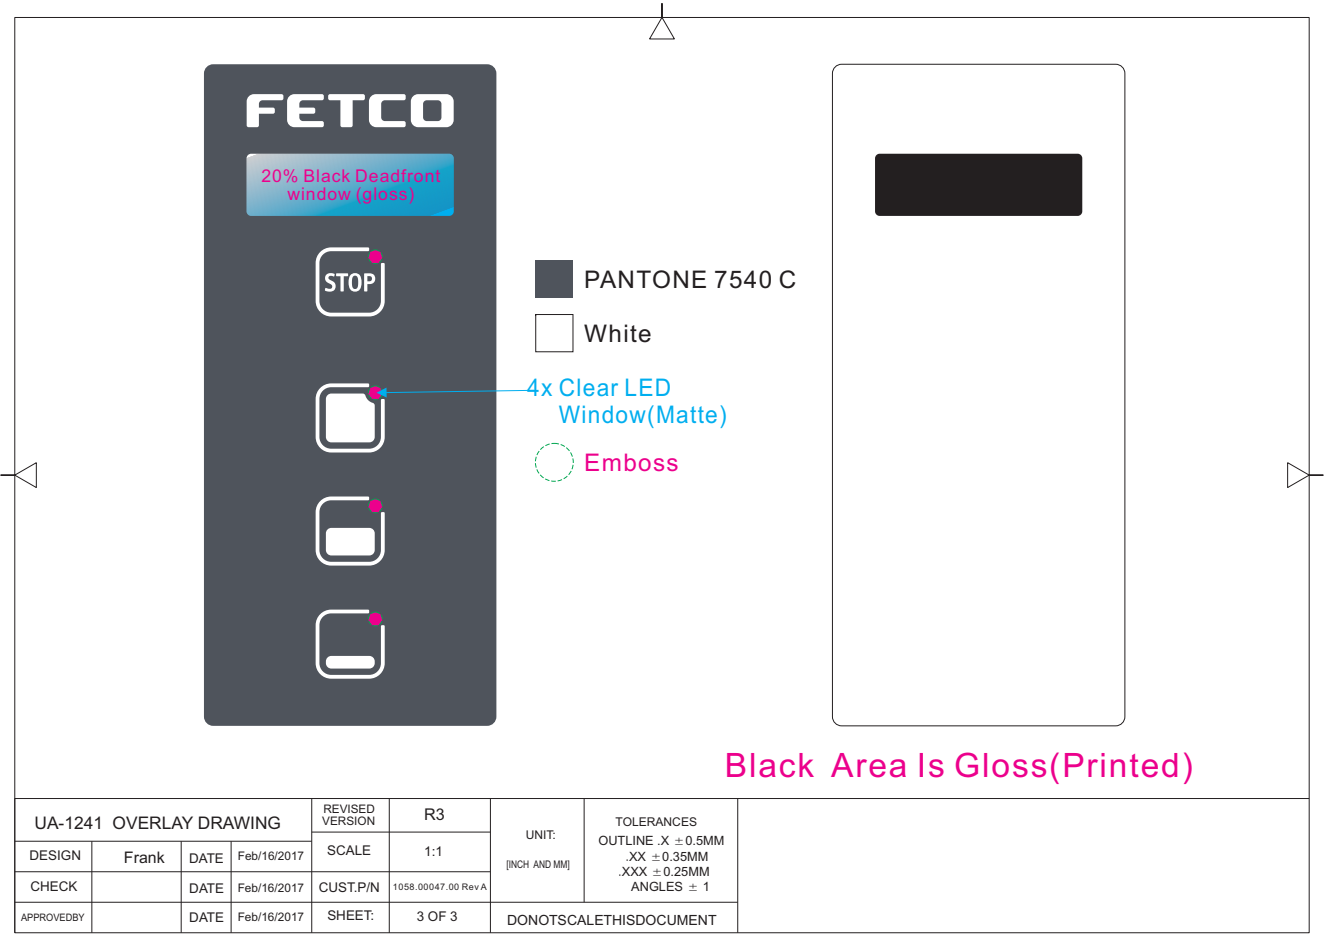
[picture p79: page 3]
PANTONE 7540 C; White; Emboss; 4x Clear LED Window(Matte); SCALE; CHECK; DATE; DESIGN; SHEET:; CUST.P/N; REVISED VERSION; DONOTSCALETHISDOCUMENT; APPROVEDBY; 1058.00047.00 Rev A; Feb/16/2017; UNIT:; TOLERANCES; OUTLINE .X; .XXX; ANGLES; Frank

Black Area Is Gloss(Printed)

UA-1241 OVERLAY DRAWING

[INCH AND MM]
