rhoppel/CBS-1100-XV_git/Released/DisplayAssembly/Switches/Membrane Switch/UA-1242-R3 PRODUCT DRAWING.PDF

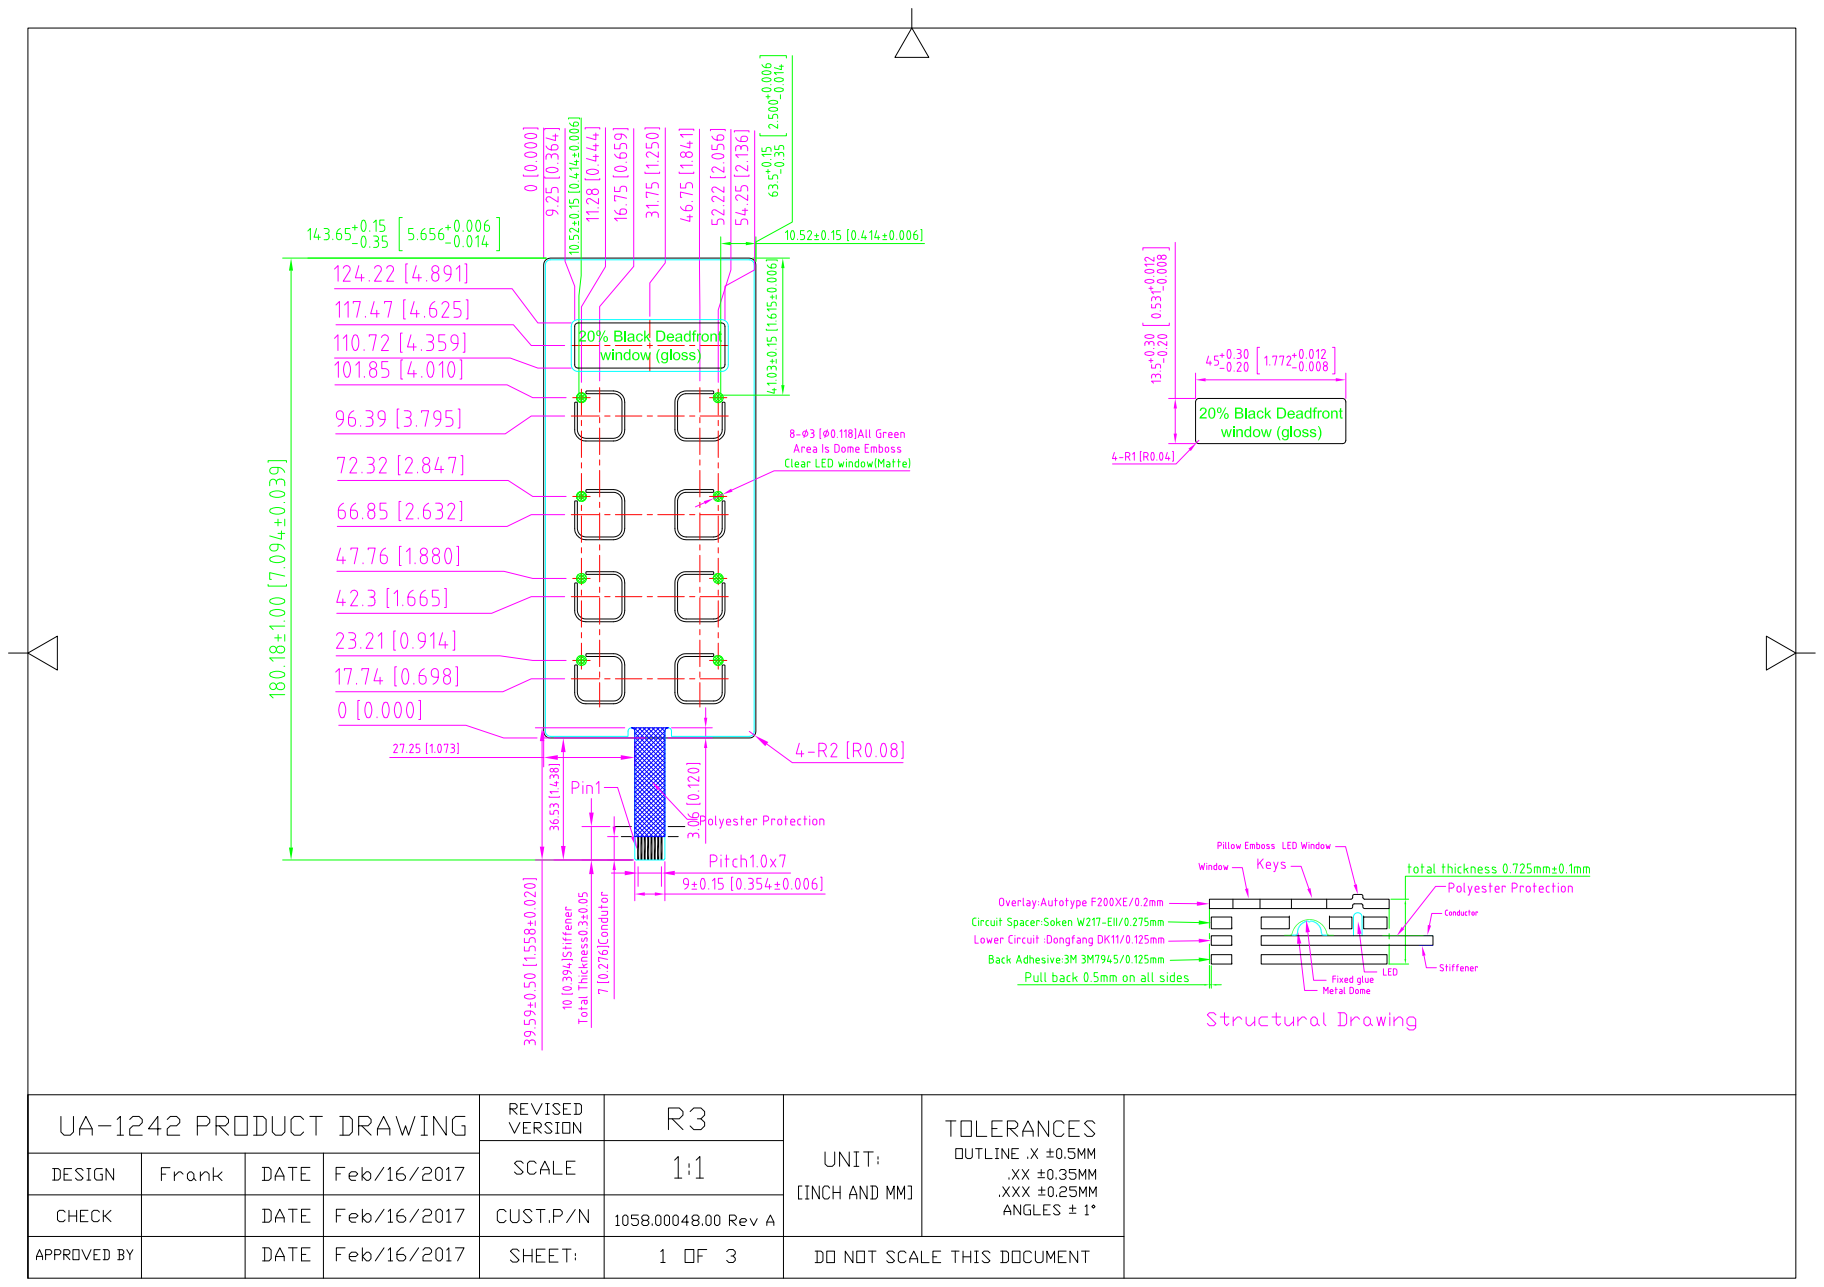
[picture p80: page 1]

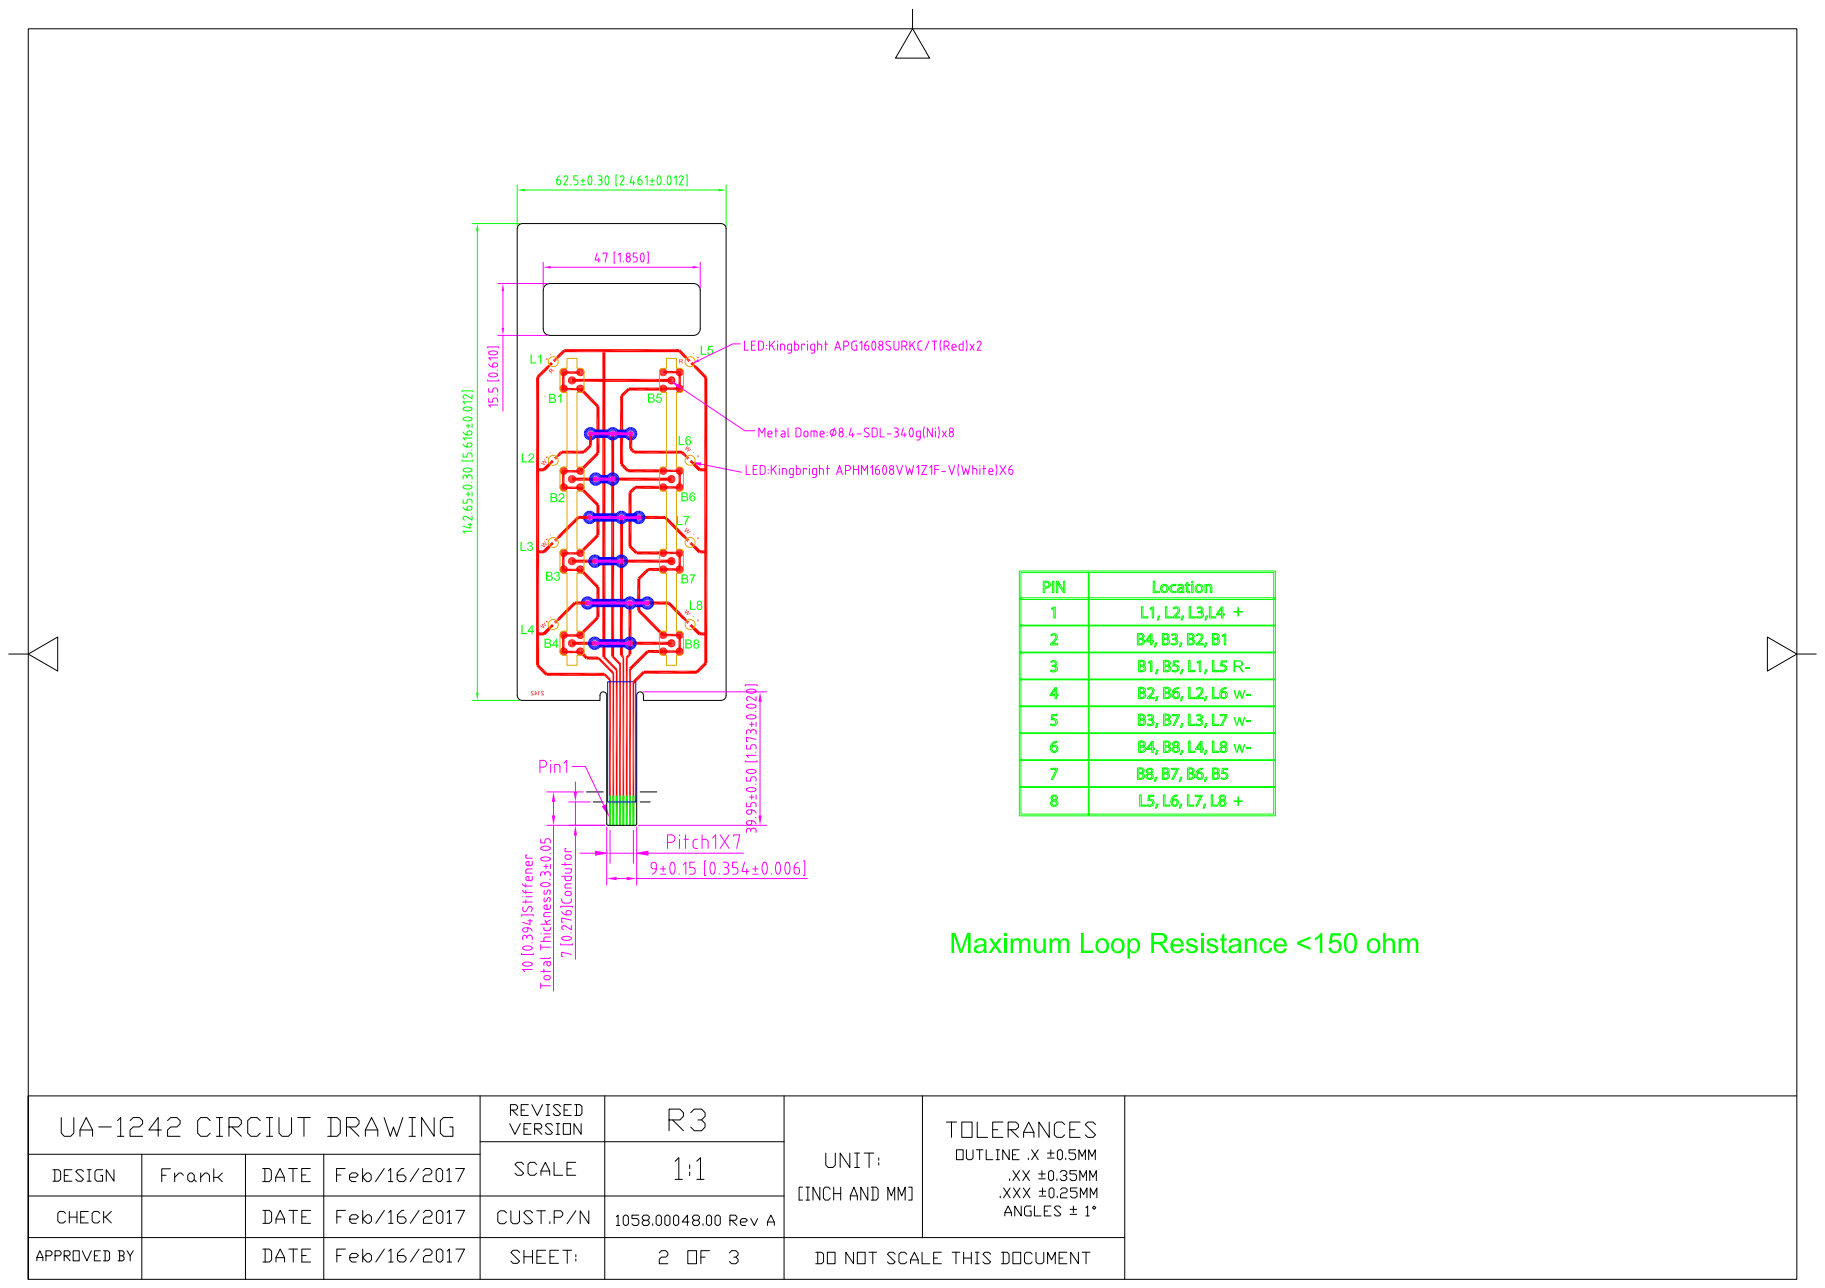
[picture p81: page 2]

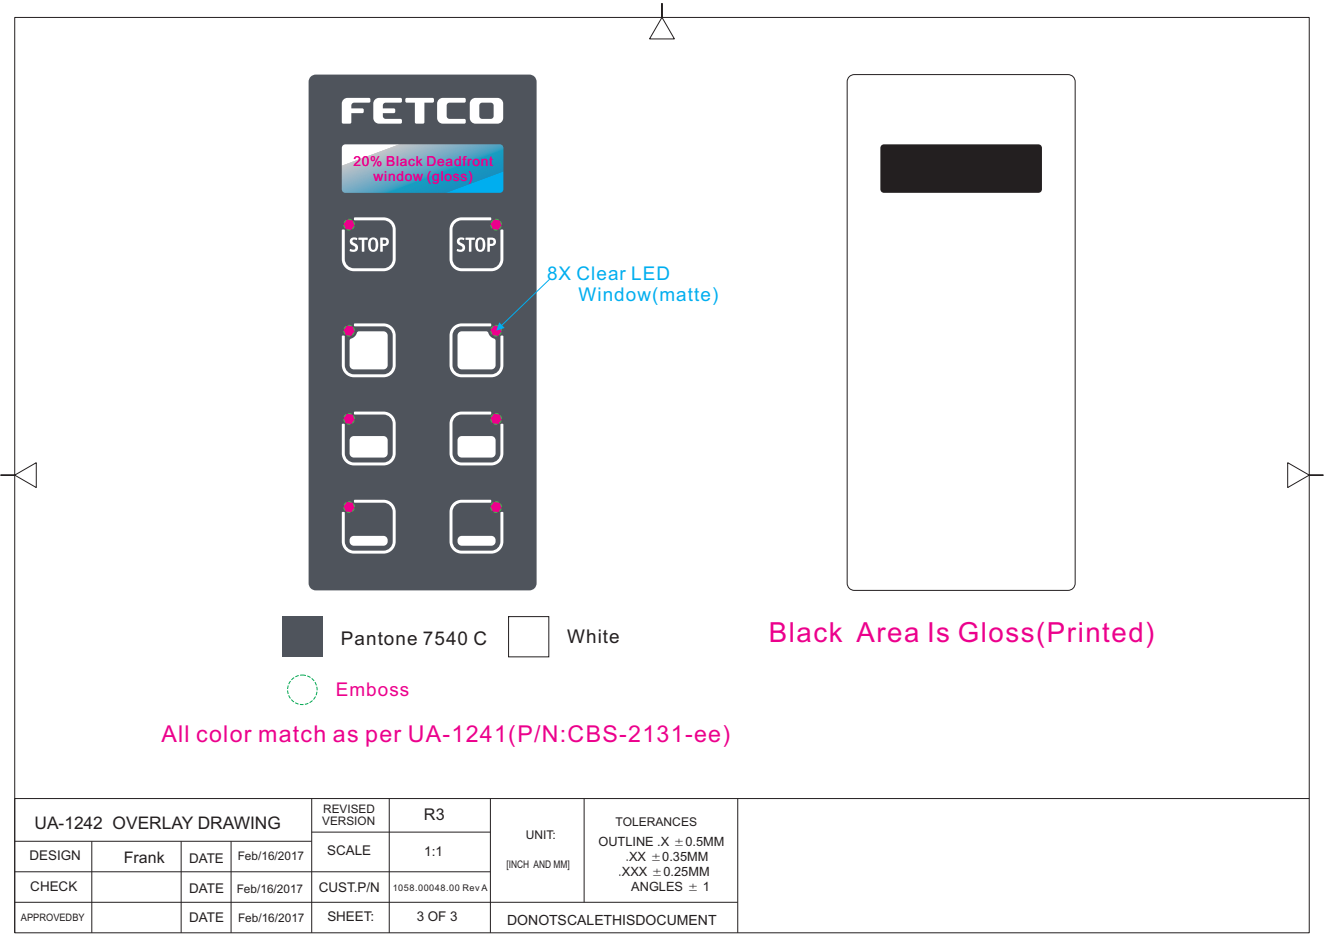
[picture p82: page 3]
20% Black Deadfront window (gloss); Emboss; 8X Clear LED Window(matte); Pantone 7540 C; White; SCALE; CHECK; DATE; DESIGN; SHEET:; CUST.P/N; REVISED VERSION; DONOTSCALETHISDOCUMENT; APPROVEDBY; 1058.00048.00 Rev A; Feb/16/2017; UNIT:; TOLERANCES; OUTLINE .X; .XXX; ANGLES; Frank

Black Area Is Gloss(Printed)

All color match as per UA-1241(P/N:CBS-2131-ee)

UA-1242 OVERLAY DRAWING

[INCH AND MM]
