rhoppel/CBS-1100-XV_git/Released/DisplayAssembly/Switches/Membrane Switch/1058.00047.00 CBS Single/1058.00047.00.pdf

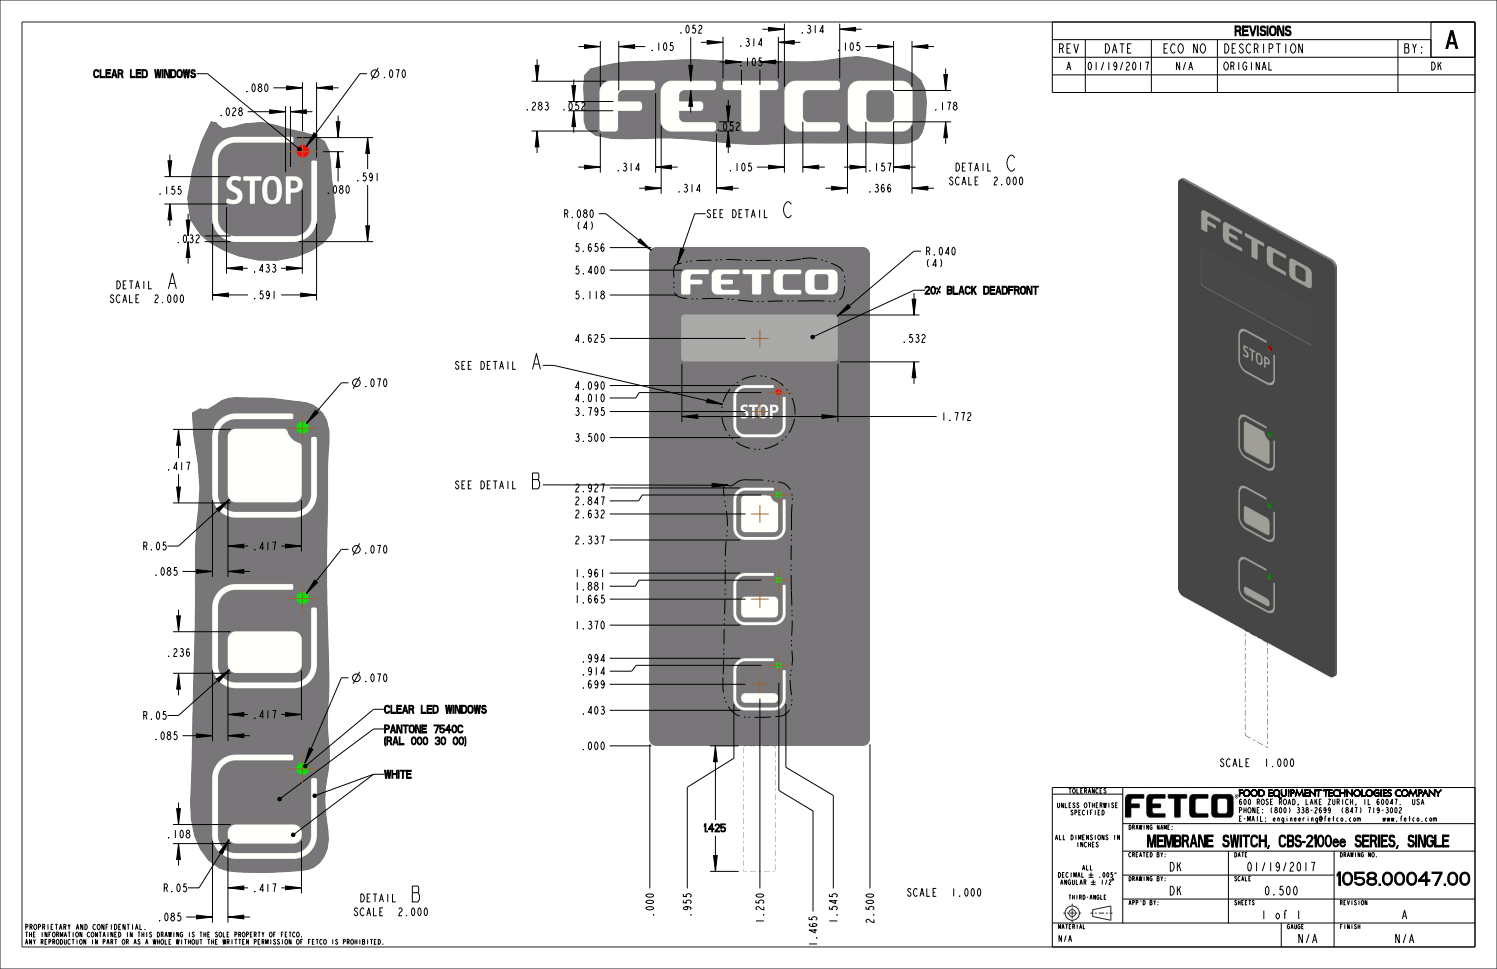
[picture p83: page 1]
A REVISIONS; REV DATE; ECO NO DESCRIPTION; ORIGINAL; TOLERANCES; FOOD EQUIPMENT TECHNOLOGIES COMPANY; 600 ROSE; ROAD, LAKE; ZURICH, IL; 60047. USA; PHONE: (800) 338-2699 (847) 719-3002; E-MAIL: engineering @fetco.com; www.fetco.com; DRAWING NAME:; INCHES; MEMBRANE; SWITCH,; CBS-2100ee SERIES,; SINGLE; CREATED BY:; DATE; DRAWING NO.; ALL DECIMAL #-; ANGULAR #-; 01/19/2017 DRAWING BY:; SCALE; 0.500 THIRD-ANGLE; APP'D BY:; SHEETS; REVISION; A MATERIAL; GAUGE; FINISH; SCALE 1.000; SEE DETAIL A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

CLEAR LED WINDOWS

UNLESS OTHERWISE
SPECIFIED
ALL DIMENSIONS IN

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
