rhoppel/CBS-1100-XV_git/Released/PCB/1051.00041.00-A.3/1051.00041.00_2-A.4/Schematic PDF/[1051.00041.00_2-A.4] Schematic Color.PDF

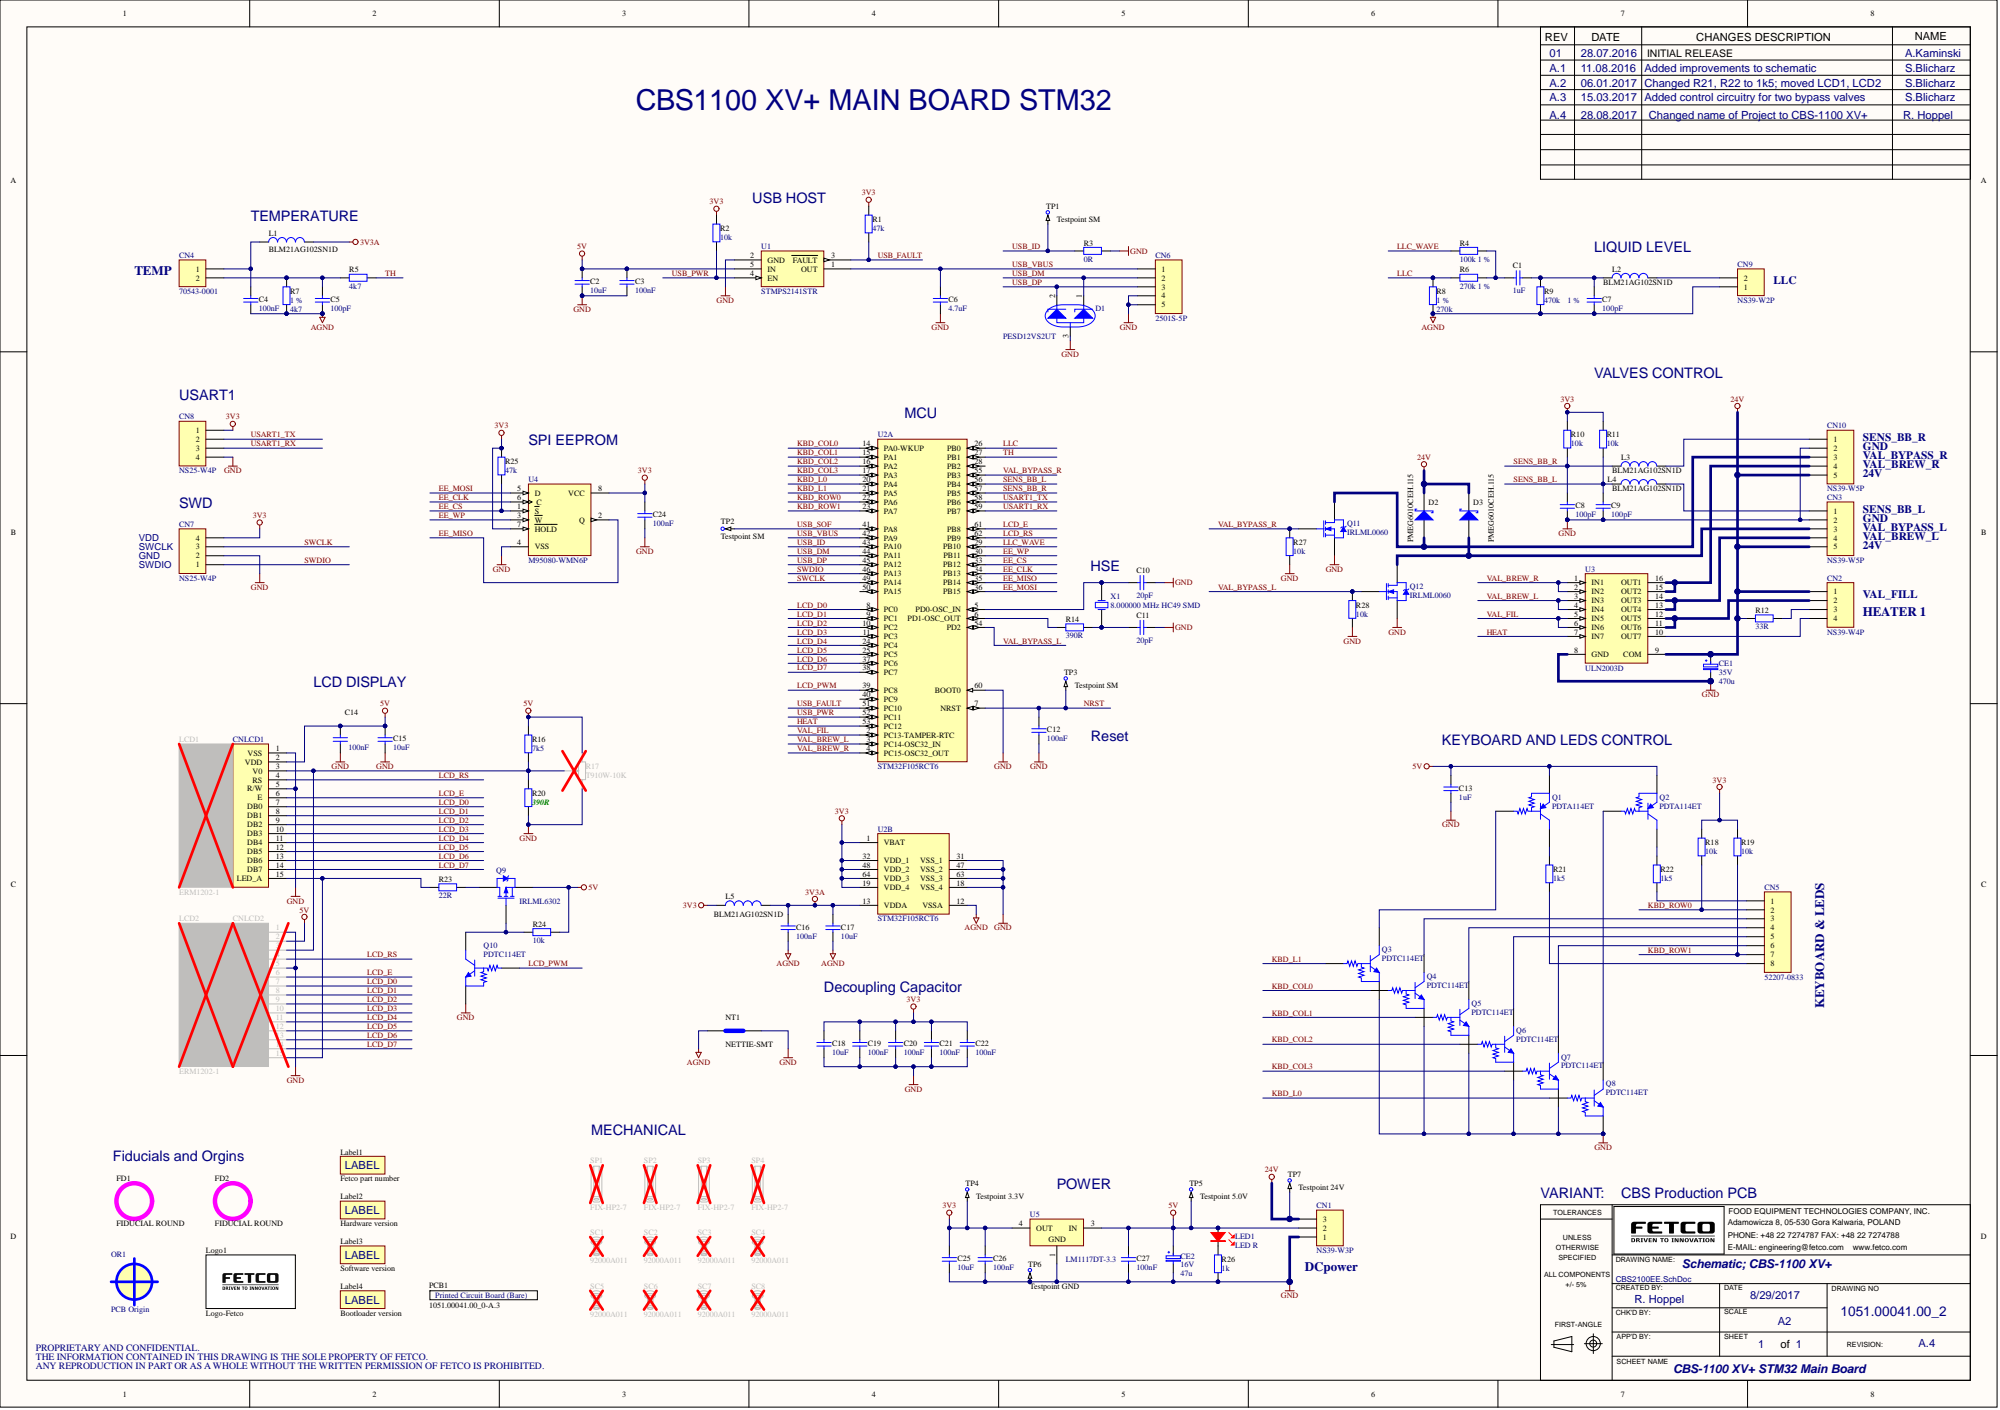
[picture p84: page 1]

REV | DATE | CHANGES DESCRIPTION | NAME
01 | 28.07.2016 | INITIAL RELEASE | A.Kaminski
A.1 | 11.08.2016 | Added improvements to schematic | S.Blicharz
A.2 | 06.01.2017 | Changed R21, R22 to 1k5; moved LCD1, LCD2 | S.Blicharz
A.3 | 15.03.2017 | Added control circuitry for two bypass valves | S.Blicharz
A.4 | 28.08.2017 | Changed name of Project to CBS-1100 XV+ | R. Hoppel

KEYBOARD AND LEDS CONTROL

GND 5V | IRLML6302 R24

VDD V0 E DB0 DB1 DB2 DB3 DB4 DB5 DB6 DB7
6 R/W 5 RS 4

KBD_ROW1

Adamowicza 8, 05-530 Gora Kalwaria, POLAND
PHONE: +48 22 7274787 FAX: +48 22 7274788
E-MAIL: engineering@fetco.com www.fetco.com

CREATED BY: R. Hoppel | DATE 8/29/2017 | DRAWING NO 1051.00041.00_2

CHK'D BY: | SCALE A2

APP'D BY: | SHEET 1 of 1 | A.4 REVISION:

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

CBS-1100 XV+ STM32 Main Board
