rhoppel/CBS-1100-XV_git/Released/Drawings/1058 (SWITCHES LCD DISPLAYS LIGHT INDICATORS)/1058.00048.00.pdf

## SEE DETAIL C

# DETAIL C

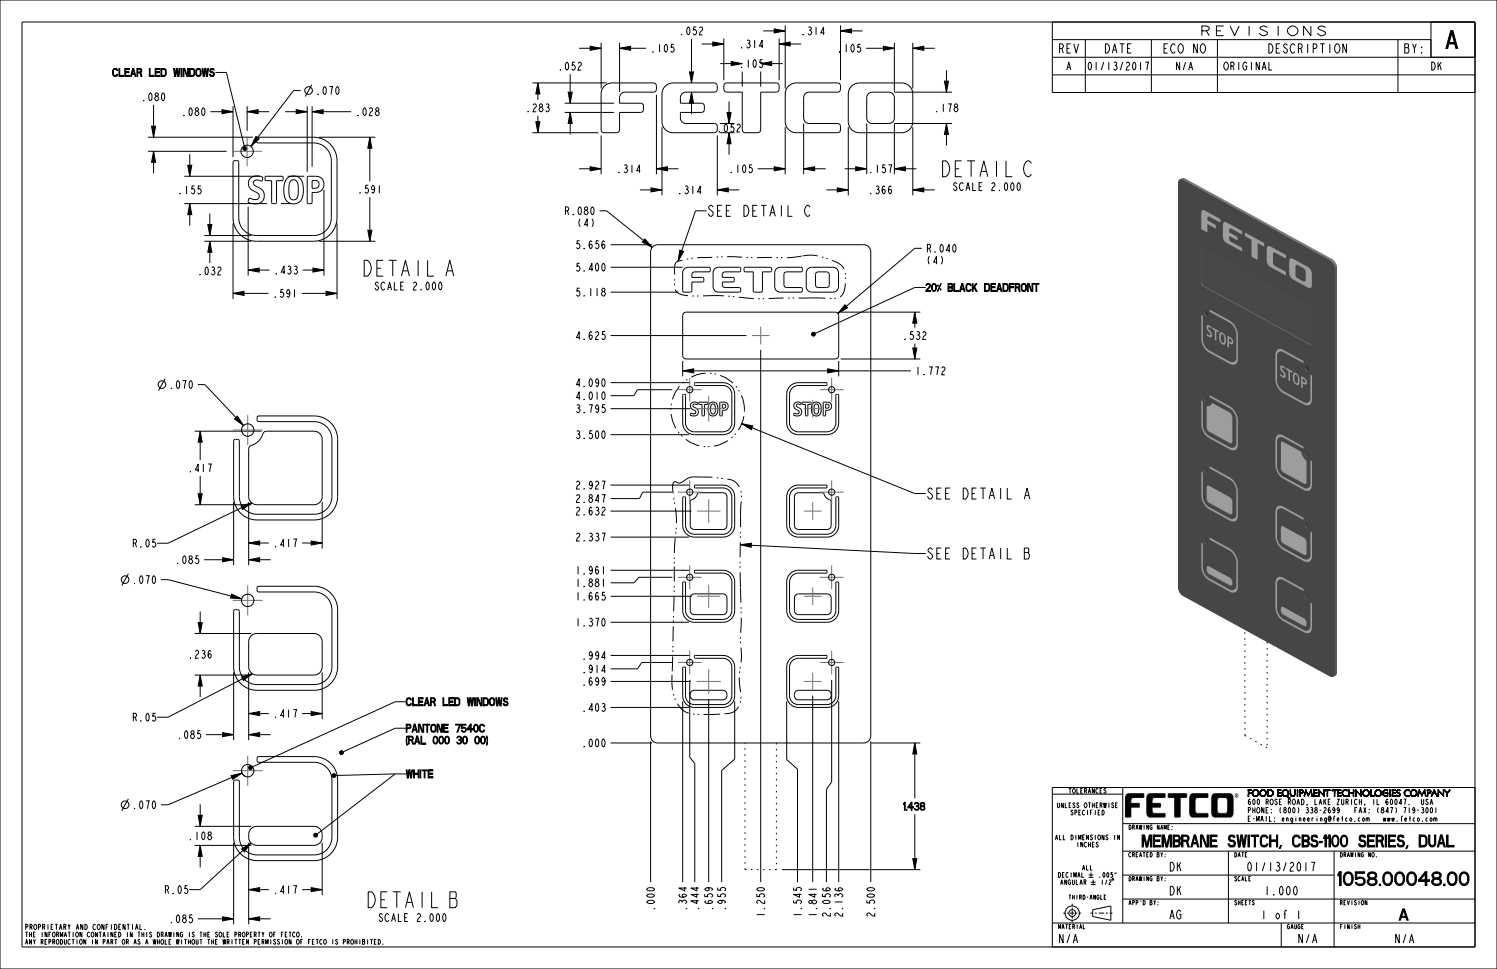
[picture p86: page 1]
A REVISIONS; REV DATE; ECO NO; DESCRIPTION; ORIGINAL; TOLERANCES; FOOD EQUIPMENT TECHNOLOGIES COMPANY; 600 ROSE; ROAD, LAKE; ZURICH, IL; 60047. USA; DRAWING NAME:; INCHES; MEMBRANE; SWITCH,; CBS-1100 SERIES, DUAL; CREATED BY:; DATE; DRAWING NO.; ALL DECIMAL #-; ANGULAR #-; 01/13/2017 DRAWING BY:; SCALE; 1.000 THIRD-ANGLE; APP'D BY:; SHEETS; REVISION; A MATERIAL; GAUGE; FINISH; SEE DETAIL A; SEE DETAIL B; 20% BLACK DEADFRONT; DETAIL A SCALE 2.000; CLEAR LED WINDOWS; DETAIL B SCALE 2.000; WHITE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

CLEAR LED WINDOWS
PANTONE 7540C
(RAL 000 30 00)

UNLESS OTHERWISE
SPECIFIED
ALL DIMENSIONS IN

PHONE: (800) 338-2699 FAX: (847) 719-3001
E-MAIL: engineering @fetco.com www.fetco.com

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
