rhoppel/CBS-1100-XV_git/Released/PCB/Drawings/1051.00041.CC.pdf

# PENDING

A

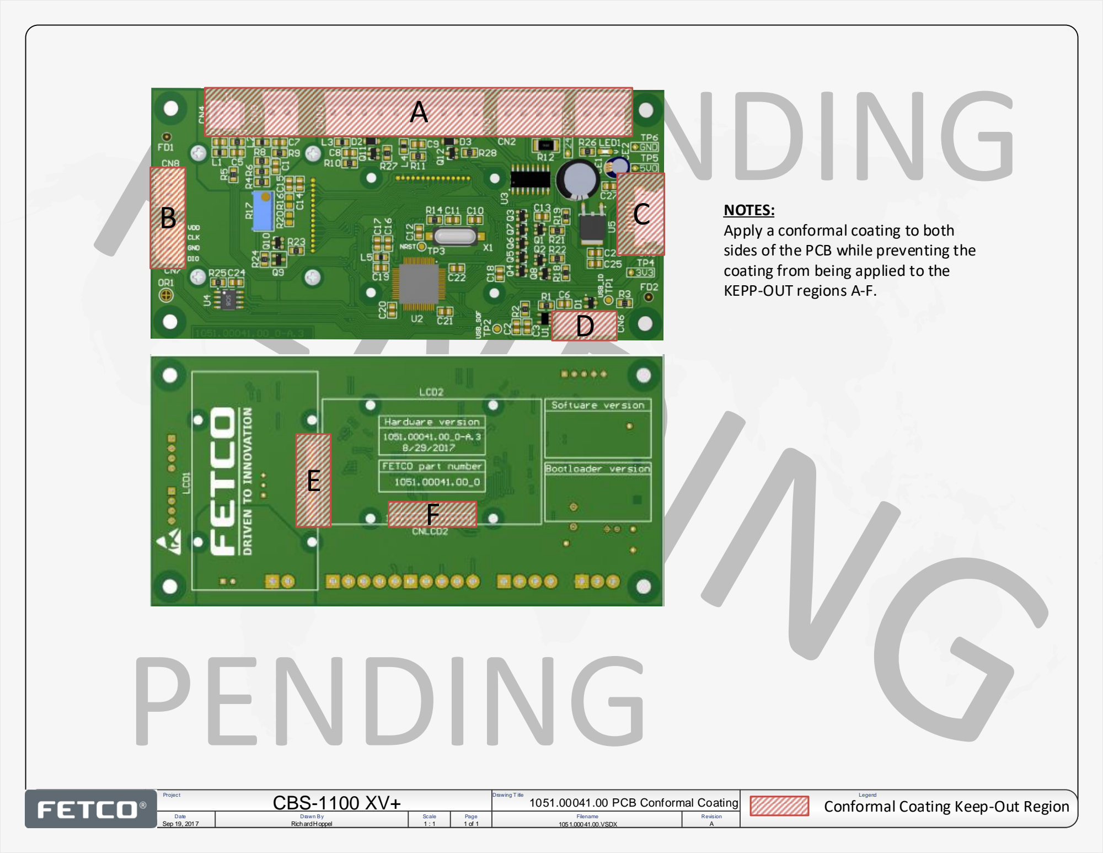
[picture p87: page 1]
PENDING; Project; Drawing T itle; Legend; Date; Drawn By; Sep 19, 2017; Richard Hoppel; Page; 1051.00041.00.VSDX; Filename; Scale; Revision; CBS-1100 XV+

NOTES:
Apply a conformal coating to both
sides of the PCB while preventing the
coating from being applied to the
KEPP-OUT regions A-F.

1051.00041.00 PCB Conformal Coating

Conformal Coating Keep-Out Region
