rhoppel/CBS-1100-XV_git/Released/DisplayAssembly/Documentation/TSM1202A-1_看图王 (003).pdf

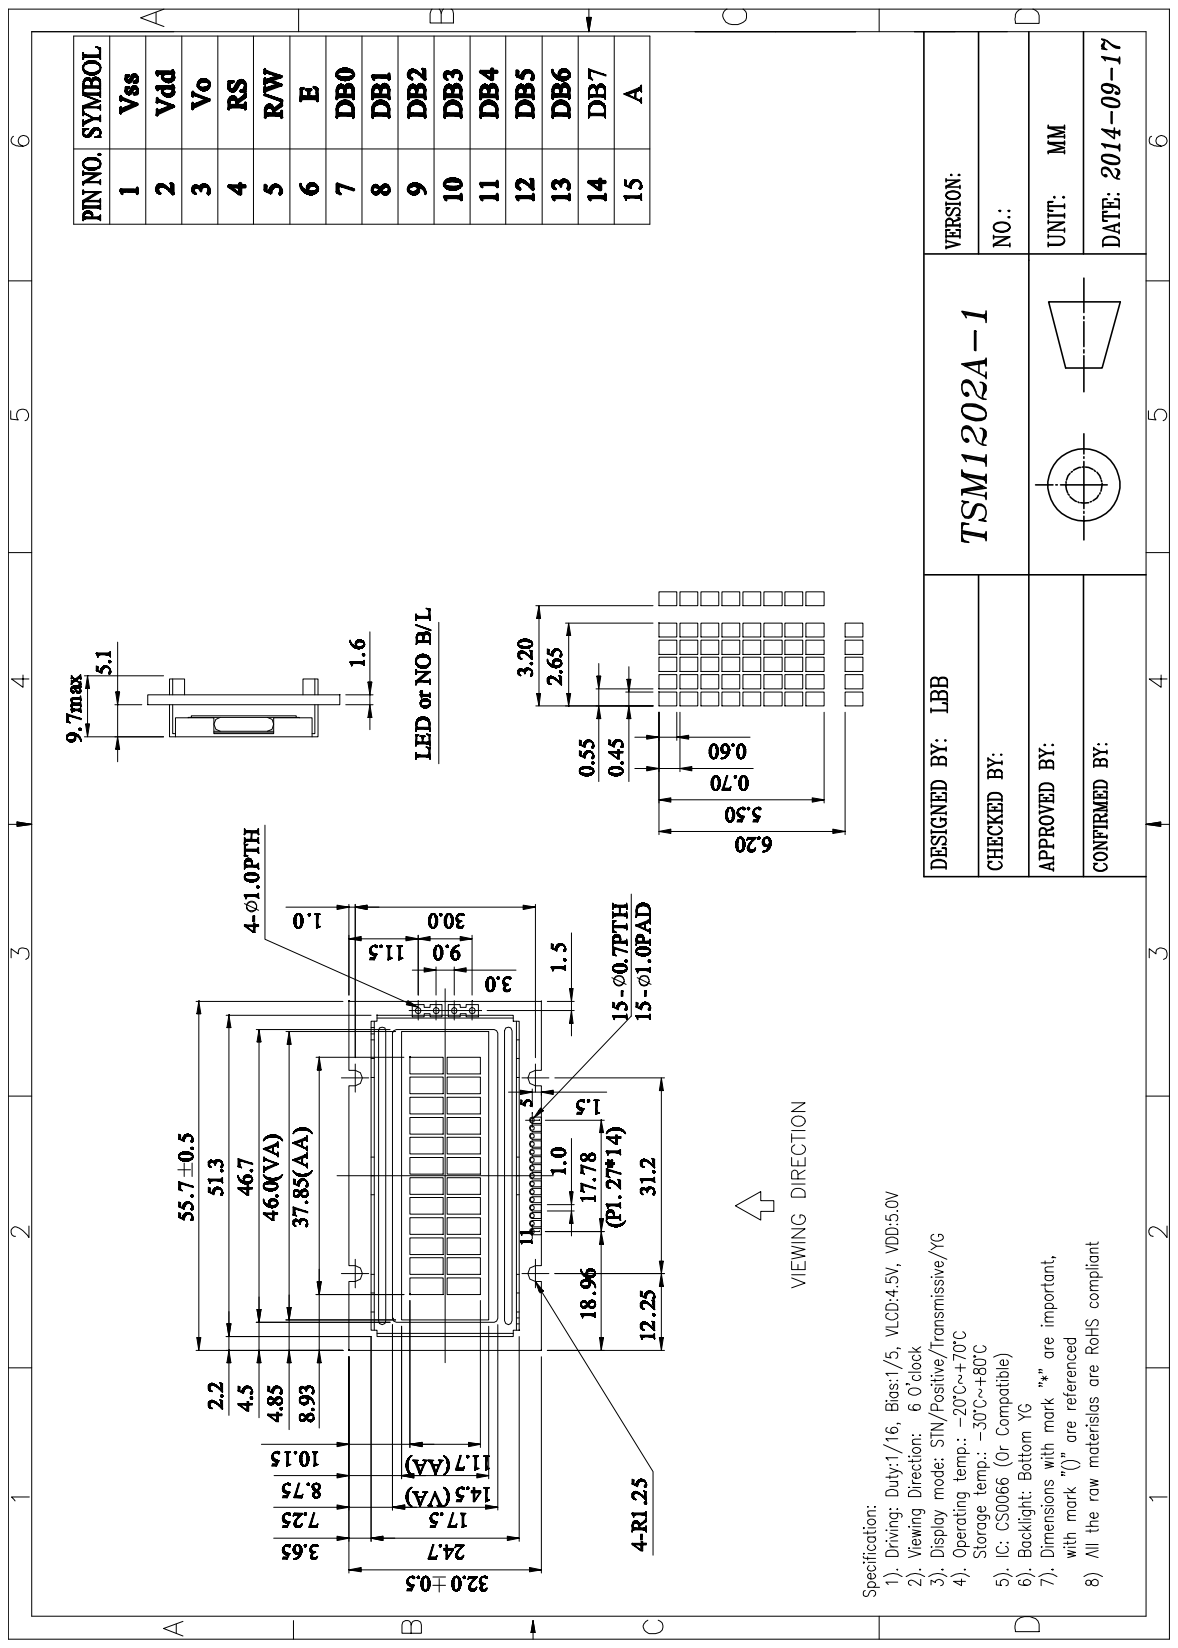
[picture p88: page 1]
