rhoppel/CBS-1100-XV_git/Released/DisplayAssembly/Documentation/USB cable SCN-2.5 .pdf

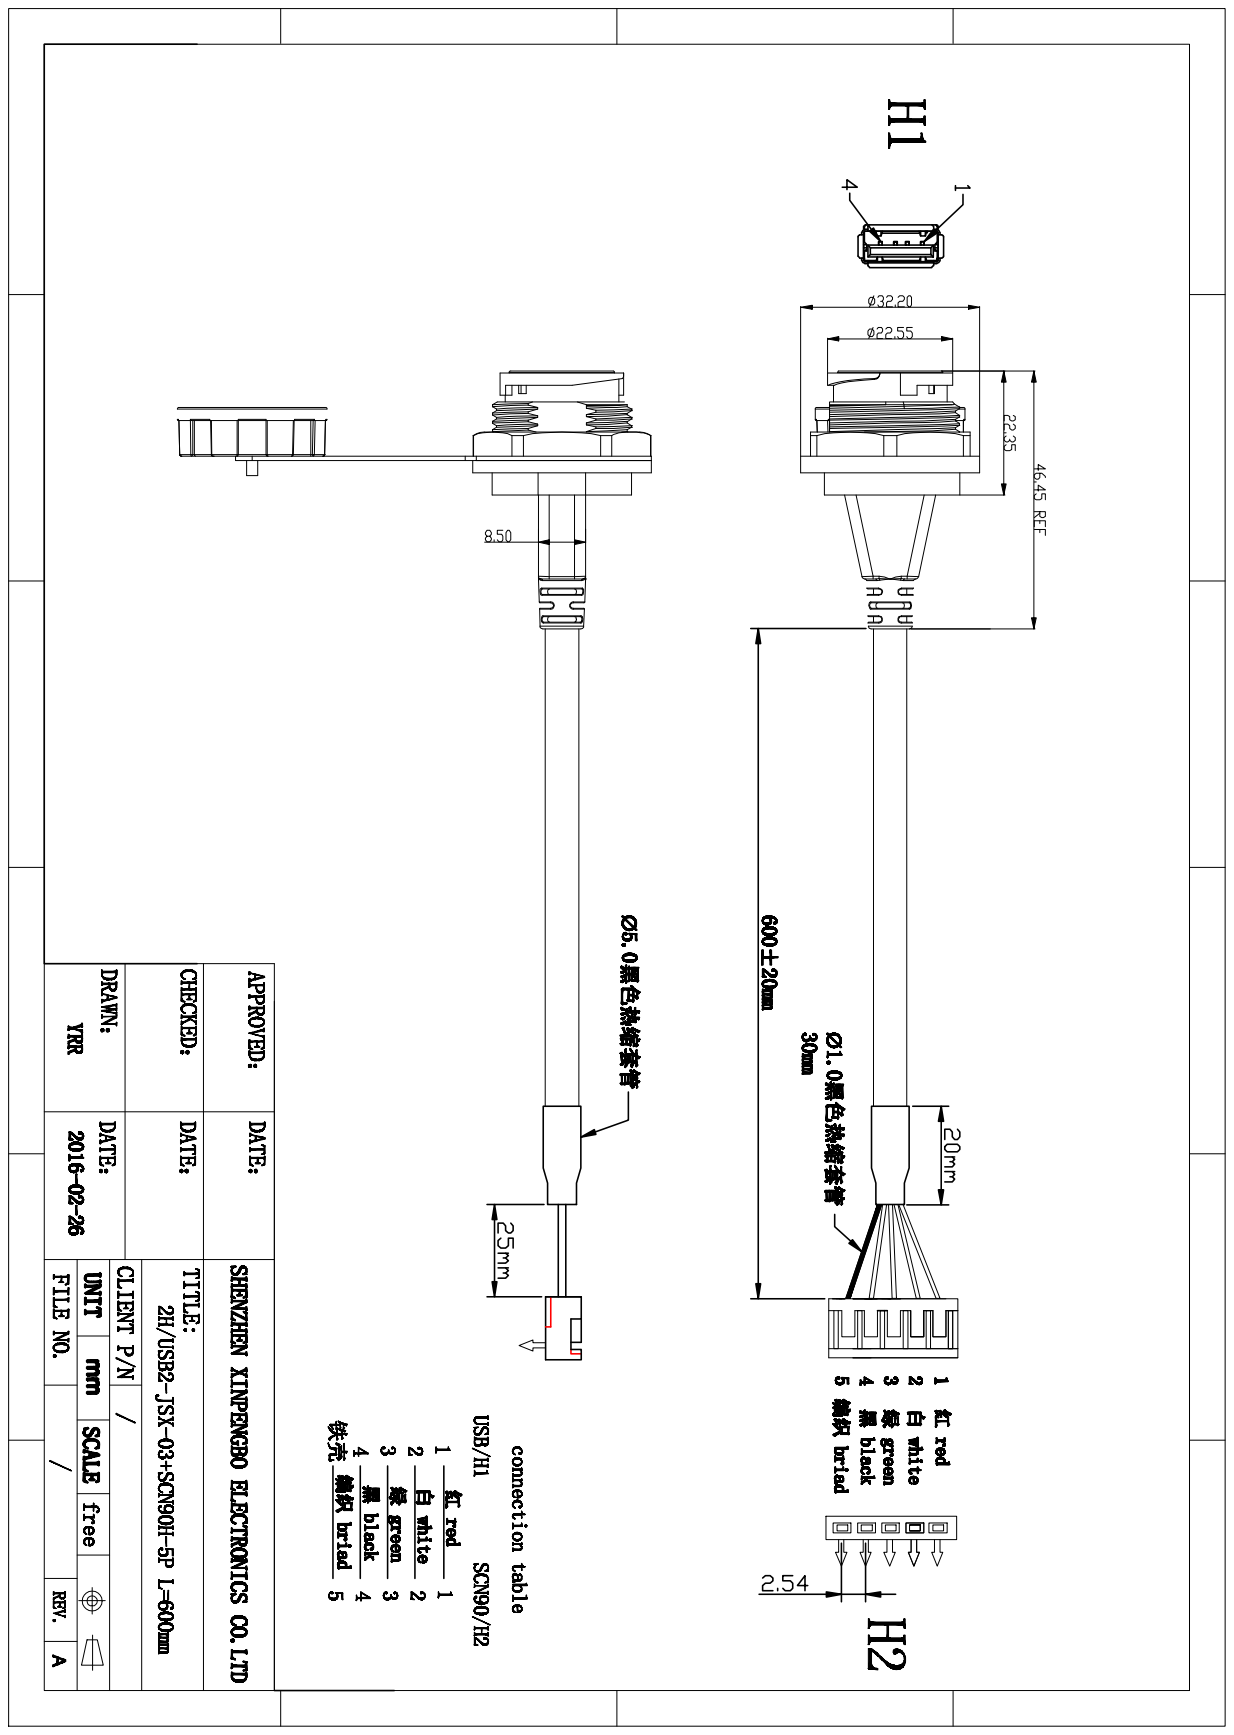
[picture p89: page 1]
