rhoppel/CBS-1100-XV_git/Released/DisplayAssembly/img/[1051.00041.00_1-A.3] Assembly PCB Top 3D View.PDF

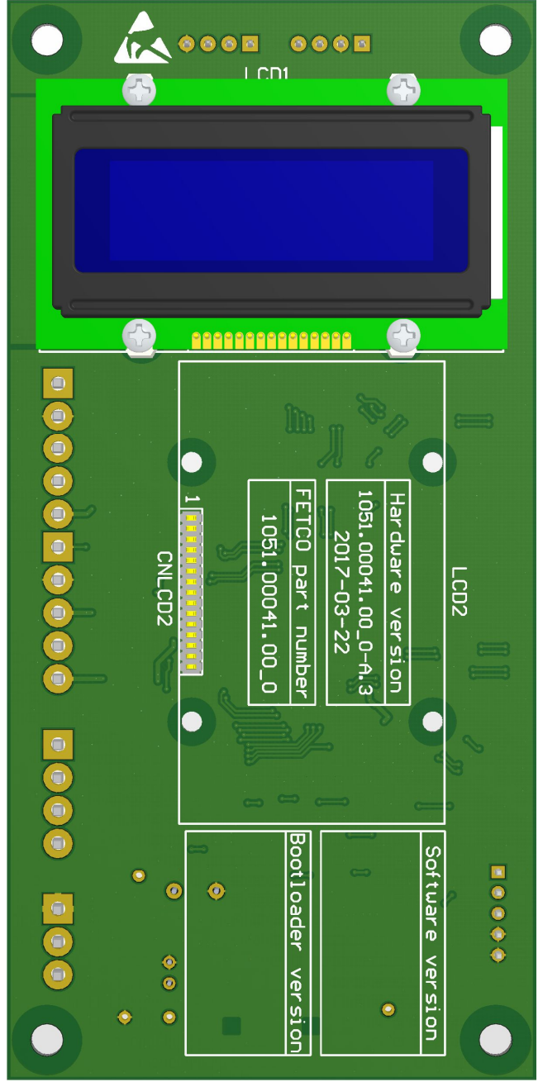
[picture p90: page 1]
