rhoppel/CBS-1100-XV_git/Released/Drawings/1023 (PLASTIC PARTS - MOLDING, INJECTION)/1023.00290.00.pdf

# DETAIL E

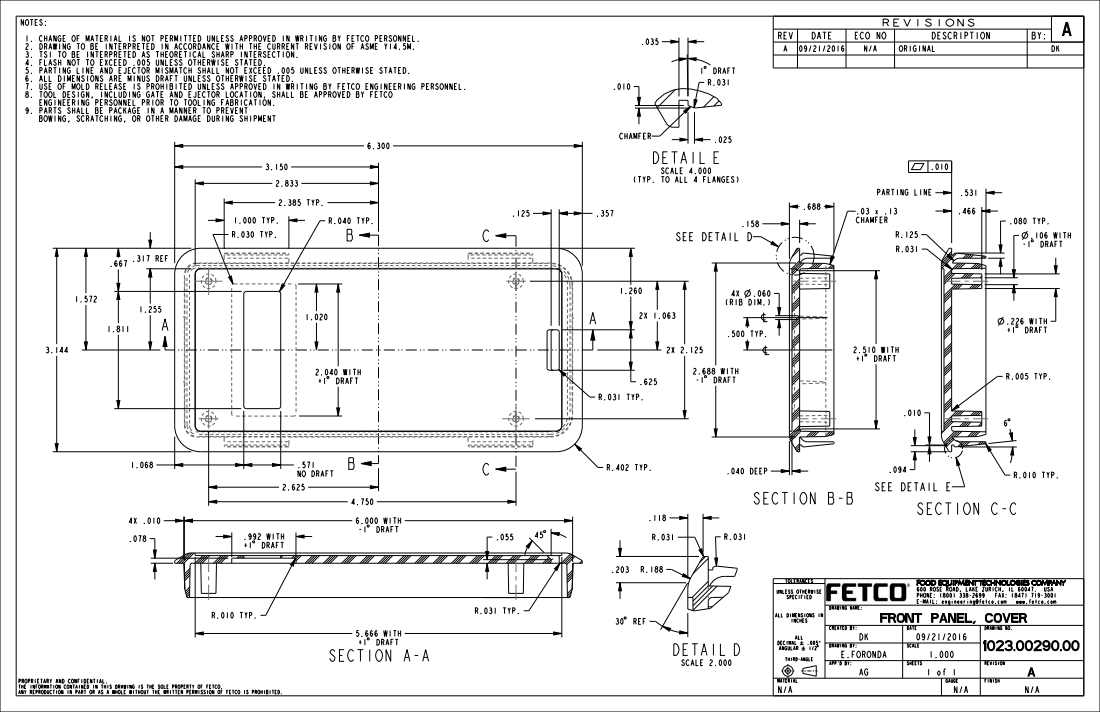
[picture p91: page 1]
WITH; DRAFT; .040 DEEP; R.402 TYP.; R.040 TYP.; R.005 TYP.; 4X (RIB DIM.); R.031 TYP.; 1.000 TYP.; .080 TYP.; R.010 TYP.; .500 TYP.; .317 REF; NO DRAFT; R.030 TYP.; WITH +1$-; 2.385 TYP.; REF; A REVISIONS; REV DATE; ECO NO; DESCRIPTION; ORIGINAL; TOLERANCES; FOOD EQUIPMENT TECHNOLOGIES COMPANY; 600 ROSE; ROAD, LAKE; ZURICH, IL; 60047. USA; UNLESS OTHERWISE SPECIFIED; DRAWING NAME:; INCHES; FRONT PANEL, COVER CREATED BY:; DATE; DRAWING NO.; ALL DECIMAL #-; ANGULAR #-; 09/21/2016 DRAWING BY: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

NOTES:
1. CHANGE OF MATERIAL IS NOT PERMITTED UNLESS APPROVED IN WRITING BY FETCO PERSONNEL.
2. DRAWING TO BE INTERPRETED IN ACCORDANCE WITH THE CURRENT REVISION OF ASME Y14.5M.
3. TSI TO BE INTERPRETED AS THEORETICAL SHARP INTERSECTION.
4. FLASH NOT TO EXCEED .005 UNLESS OTHERWISE STATED.
5. PARTING LINE AND EJECTOR MISMATCH SHALL NOT EXCEED .005 UNLESS OTHERWISE STATED.
6. ALL DIMENSIONS ARE MINUS DRAFT UNLESS OTHERWISE STATED.
7. USE OF MOLD RELEASE IS PROHIBITED UNLESS APPROVED IN WRITING BY FETCO ENGINEERING PERSONNEL.
8. TOOL DESIGN, INCLUDING GATE AND EJECTOR LOCATION, SHALL BE APPROVED BY FETCO
ENGINEERING PERSONNEL PRIOR TO TOOLING FABRICATION.
9. PARTS SHALL BE PACKAGE IN A MANNER TO PREVENT
BOWING, SCRATCHING, OR OTHER DAMAGE DURING SHIPMENT

SCALE 4.000
(TYP. TO ALL 4 FLANGES)

PHONE: (800) 338-2699 FAX: (847) 719-3001
E-MAIL: engineering @fetco.com www.fetco.com

ALL DIMENSIONS IN

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
