rhoppel/CBS-1100-XV_git/Released/DisplayAssembly/Drawings/1058 (SWITCHES LCD DISPLAYS LIGHT INDICATORS)/1058.00050.00.pdf

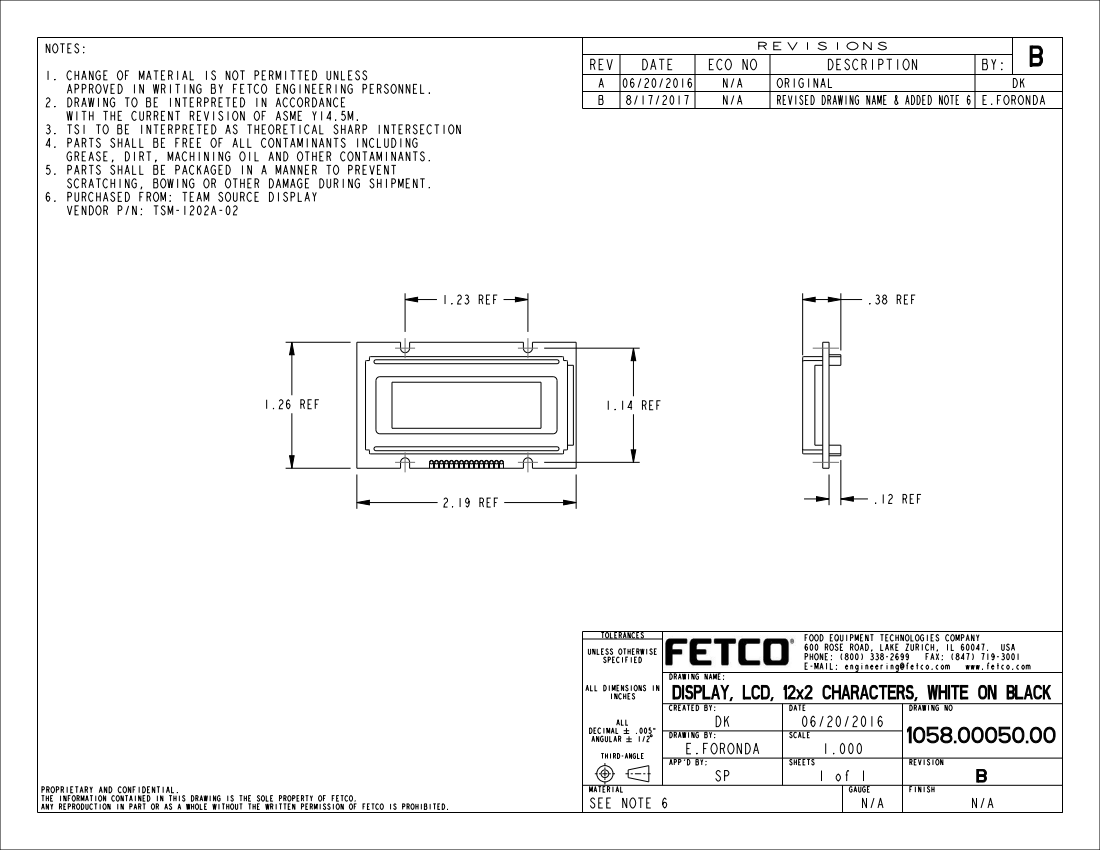
[picture p92: page 1]
1.23 REF; 1.14 REF; 2.19 REF; 1.26 REF; .38 REF; .12 REF; TOLERANCES; FOOD EQUIPMENT; TECHNOLOGIES COMPANY; 600 ROSE; ROAD, LAKE; ZURICH, IL; 60047. USA; INCHES; DISPLAY, LCD,; 12x2 CHARACTERS,; WHITE; BLACK CREATED BY:; DATE; DRAWING NO; ALL DECIMAL #-; ANGULAR #-; E.FORONDA; 1.000 THIRD-ANGLE; APP'D BY:; SHEETS; REVISION; B MATERIAL; GAUGE; FINISH; SEE NOTE 6; B REVISIONS; 1. CHANGE OF MATERIAL IS NOT; PERMITTED UNLESS; WITH; THE CURRENT; REVISION OF ASME Y14.5M.

NOTES:
APPROVED IN WRITING BY FETCO ENGINEERING PERSONNEL.
2. DRAWING TO BE INTERPRETED IN ACCORDANCE
3. TSI TO BE INTERPRETED AS THEORETICAL SHARP INTERSECTION
4. PARTS SHALL BE FREE OF ALL CONTAMINANTS INCLUDING
GREASE, DIRT, MACHINING OIL AND OTHER CONTAMINANTS.
5. PARTS SHALL BE PACKAGED IN A MANNER TO PREVENT
SCRATCHING, BOWING OR OTHER DAMAGE DURING SHIPMENT.
6. PURCHASED FROM: TEAM SOURCE DISPLAY
VENDOR P/N: TSM-1202A-02

REV | DATE | ECO NO | DESCRIPTION | | | BY:
A | 06/20/2016 | N/A | ORIGINAL | | DK
B | 8/17/2017 | | N/A | REVISED DRAWING NAME & ADDED NOTE 6 | | | E.FORONDA

UNLESS OTHERWISE
SPECIFIED
ALL DIMENSIONS IN

PHONE: (800) 338-2699 FAX: (847) 719-3001
E-MAIL: engineering @fetco.com www.fetco.com

DRAWING NAME:

DK | SCALE 06/20/2016 DRAWING BY: 1058.00050.00

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
