rhoppel/CBS-1100-XV_git/Released/DisplayAssembly/Drawings/1081 (FASTENERS)/1081.00068.00.pdf

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

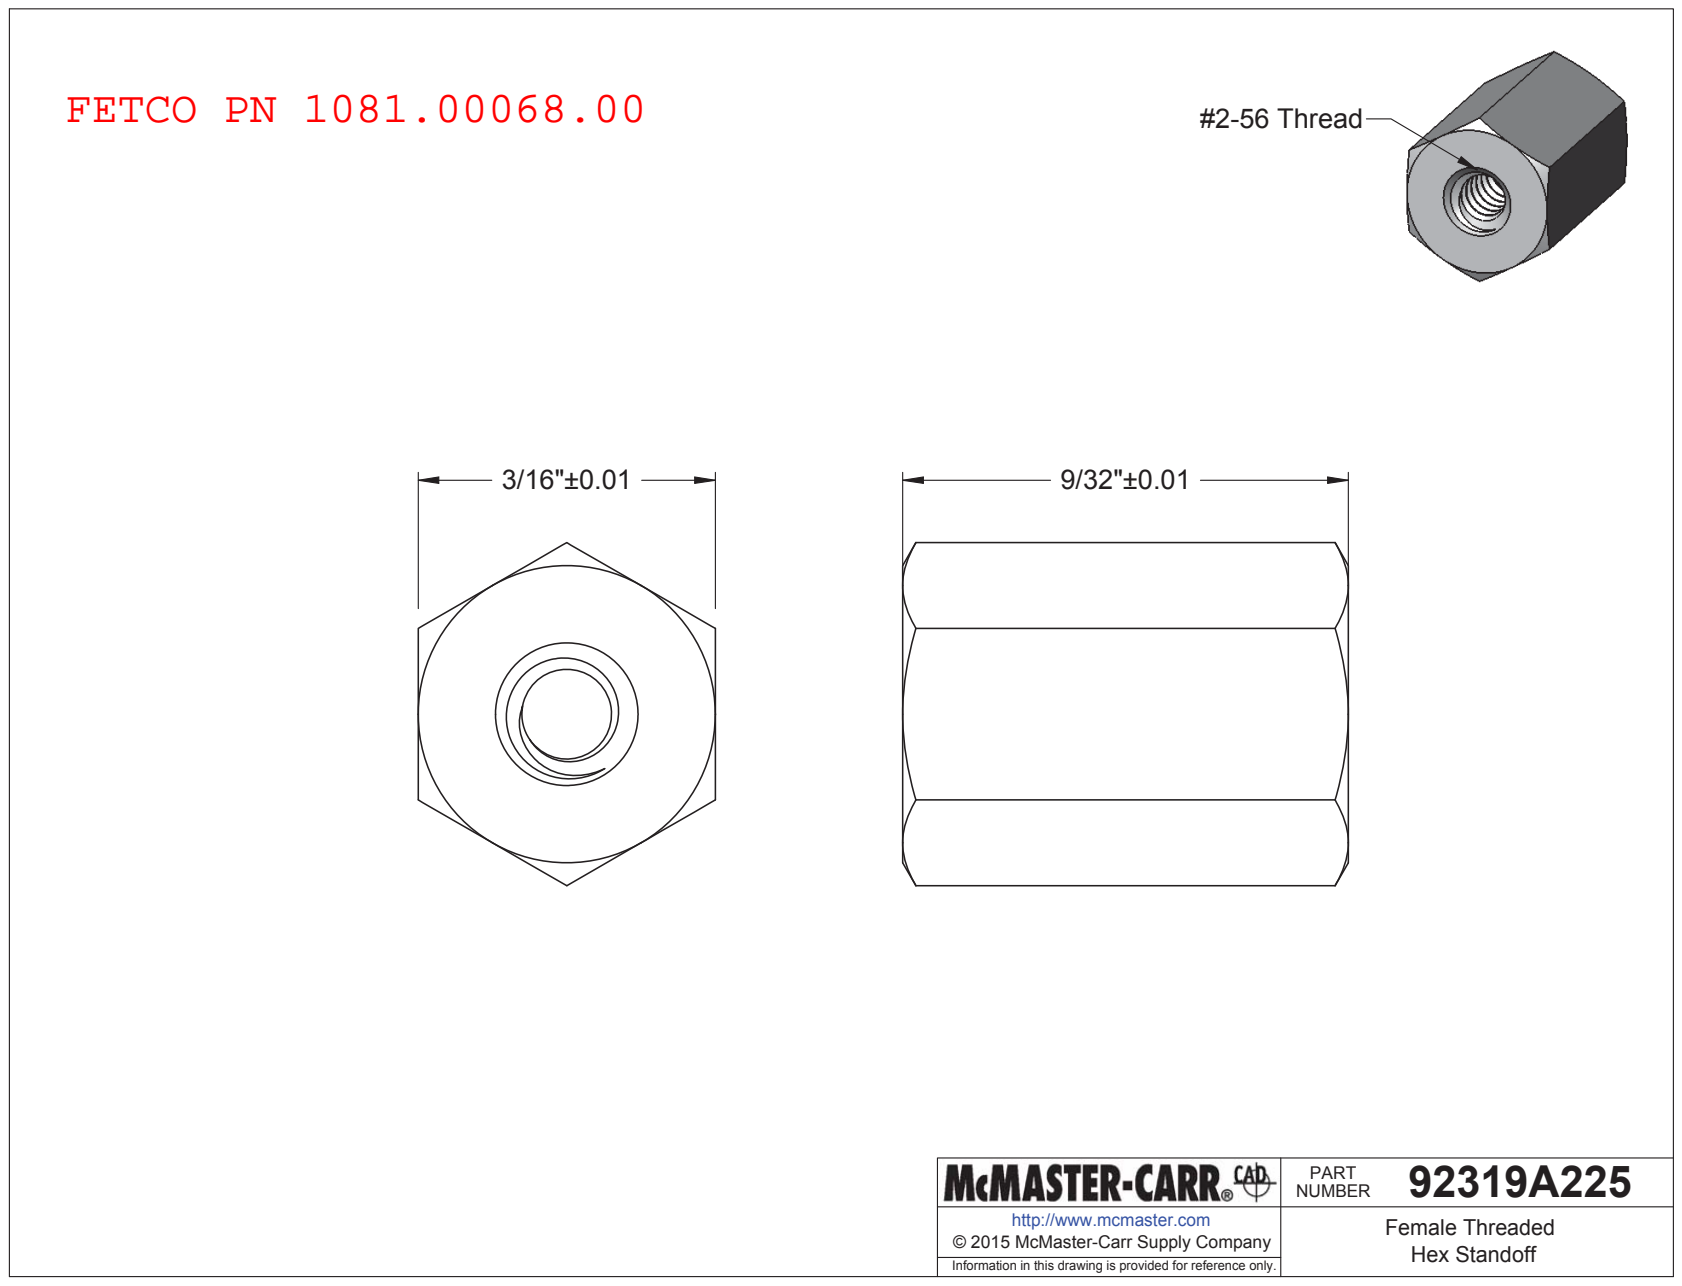
[picture p93: page 1]
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
