rhoppel/CBS-1100-XV_git/Released/DisplayAssembly/Drawings/1082 (SCREWS)/1082.00124.00.pdf

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

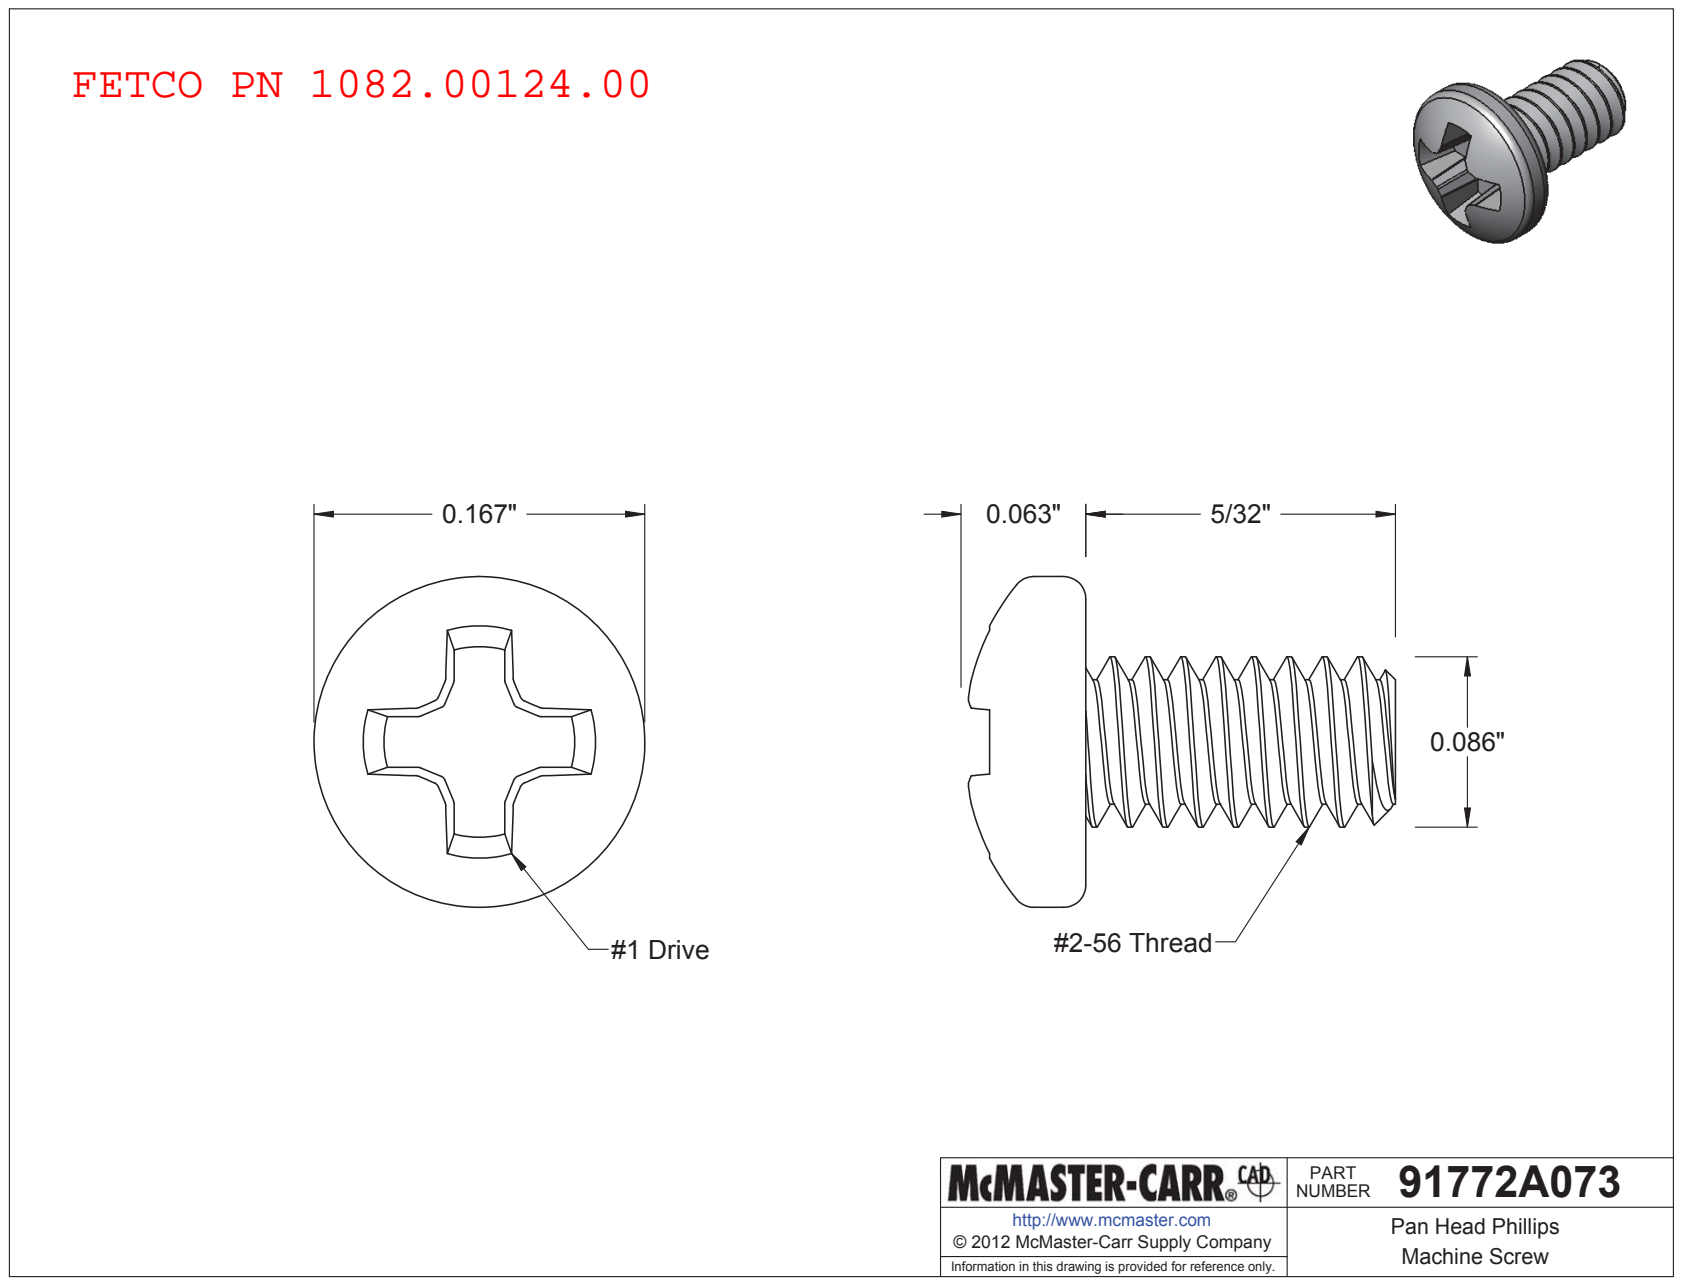
[picture p94: page 1]
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
