rhoppel/CBS-1100-XV_git/Released/PCB/1051.00041.00-A.3/1051.00041.00_1-A.3/Assembly PCB Documentation/[1051.00041.00_1-A.3] Assembly PCB Bottom 3D View.PDF

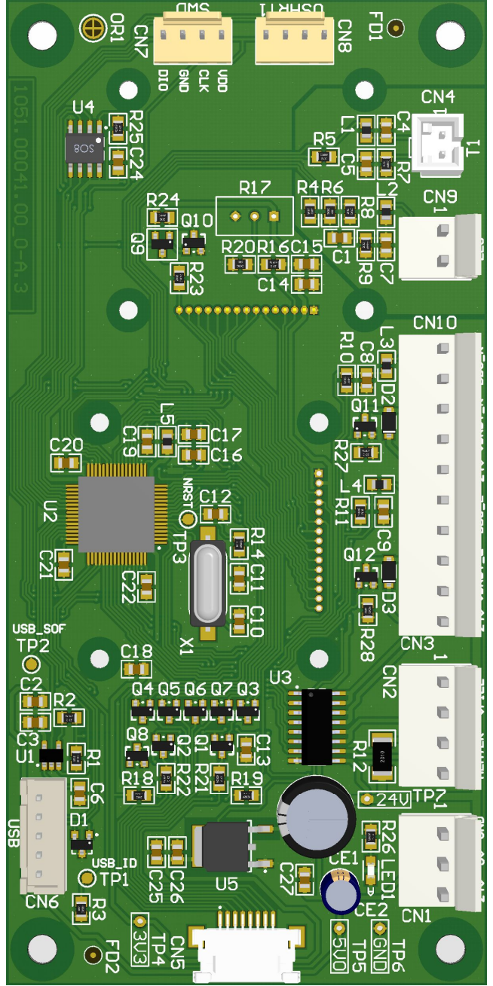
[picture p95: page 1]
