rhoppel/CBS-1100-XV_git/Released/PCB/1051.00041.00-A.3/1051.00041.00_1-A.3/Assembly PCB Documentation/[1051.00041.00_1-A.3] Assembly PCB.PDF

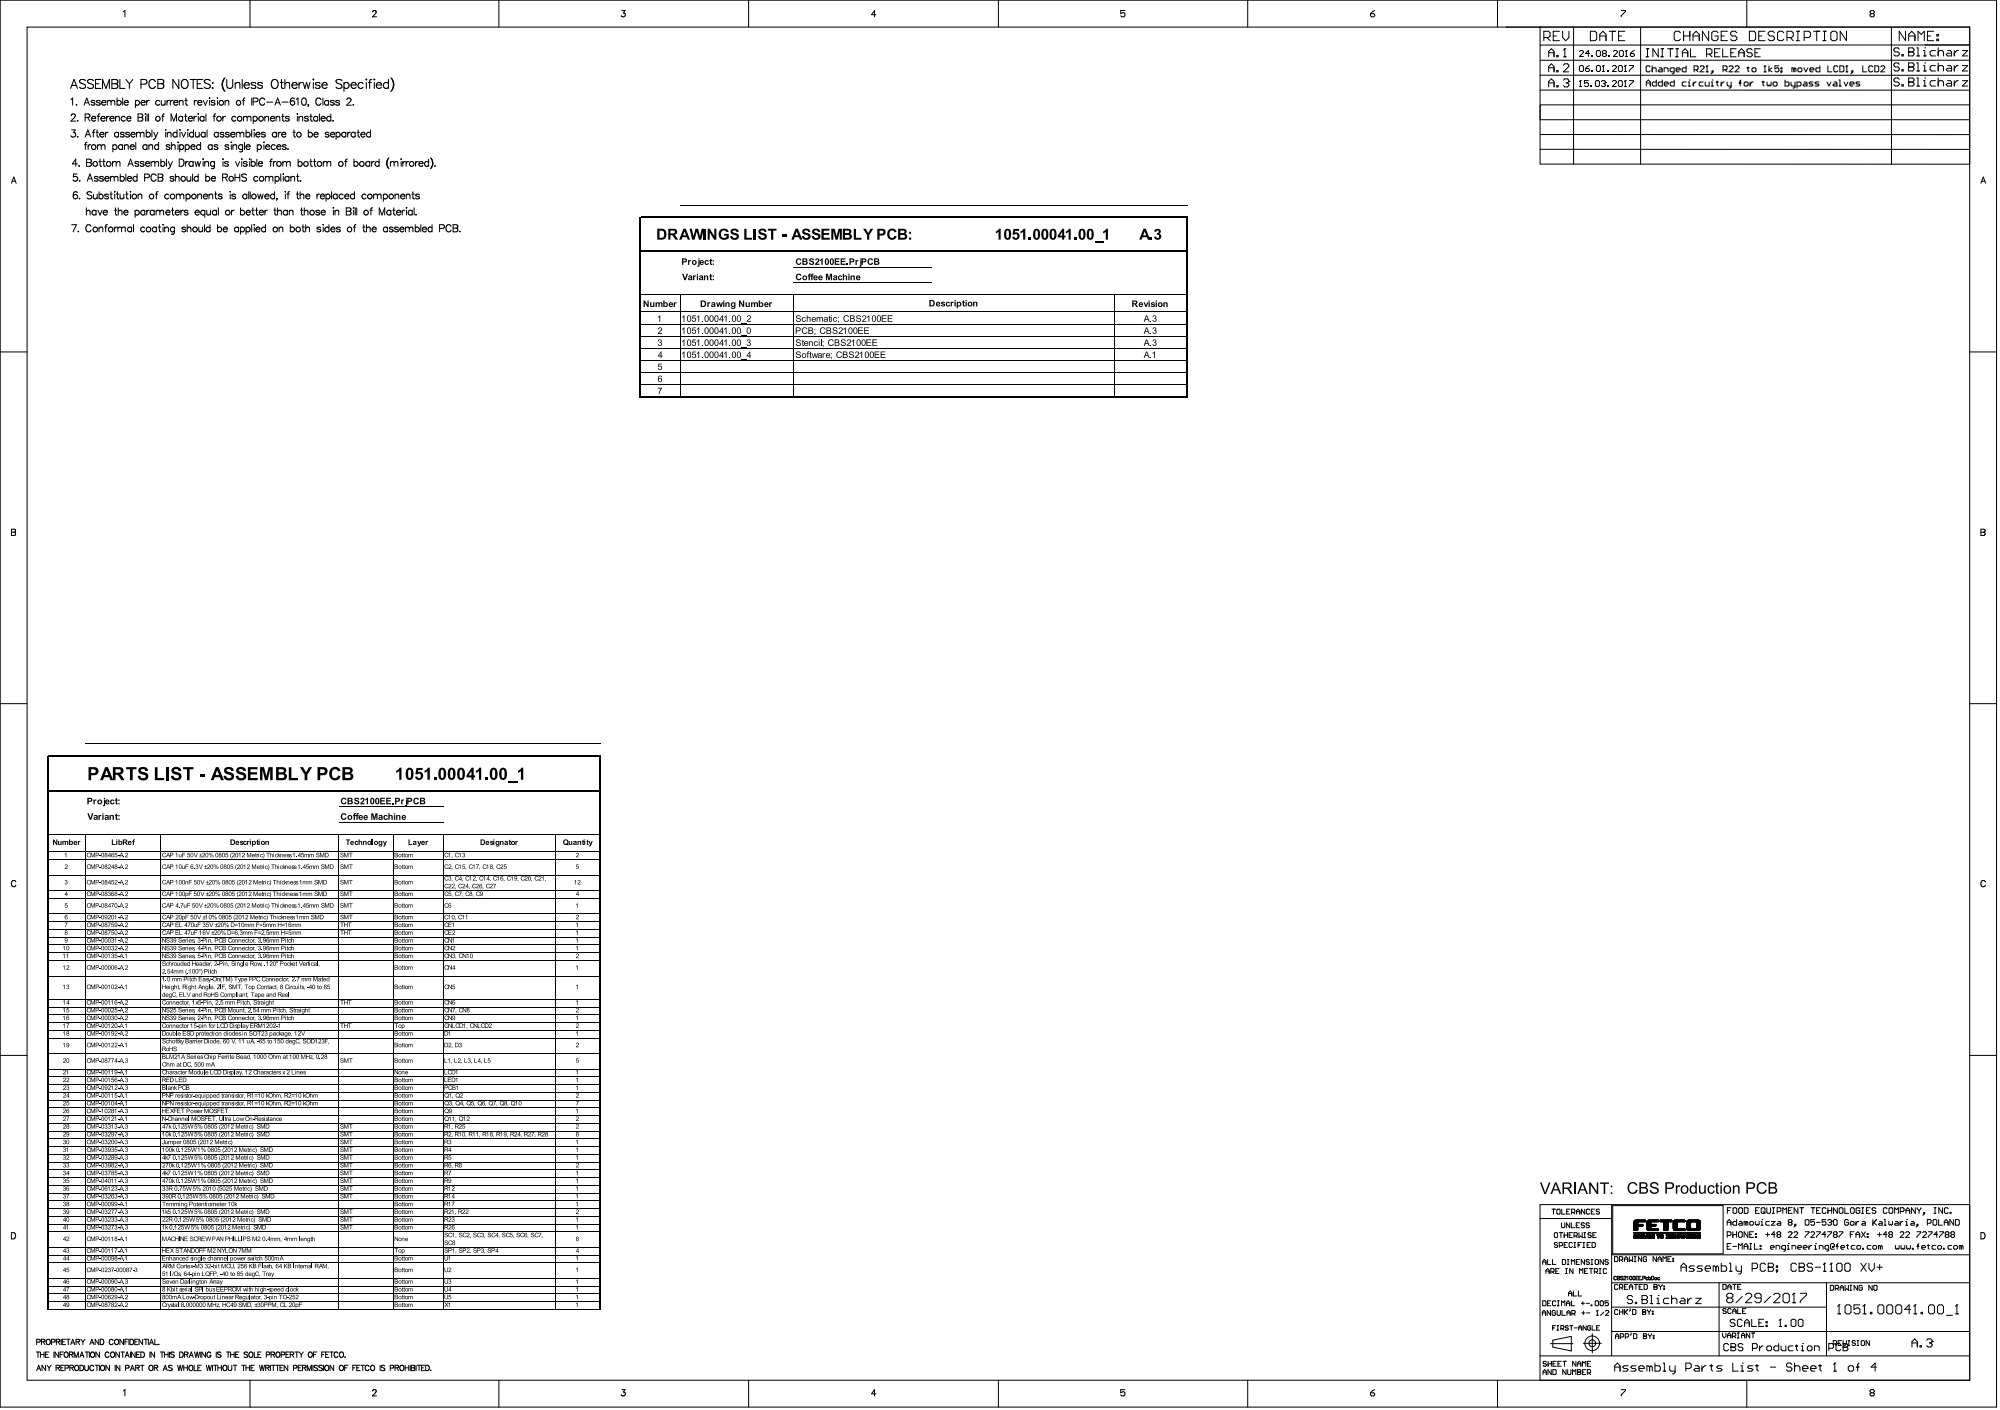
[picture p97: page 1]

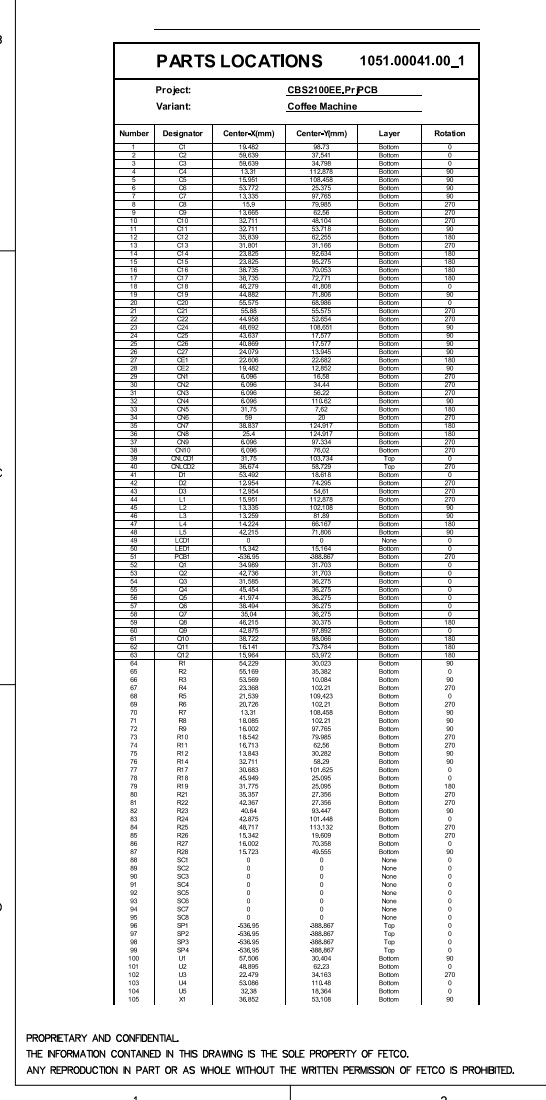
[picture p98: page 2]

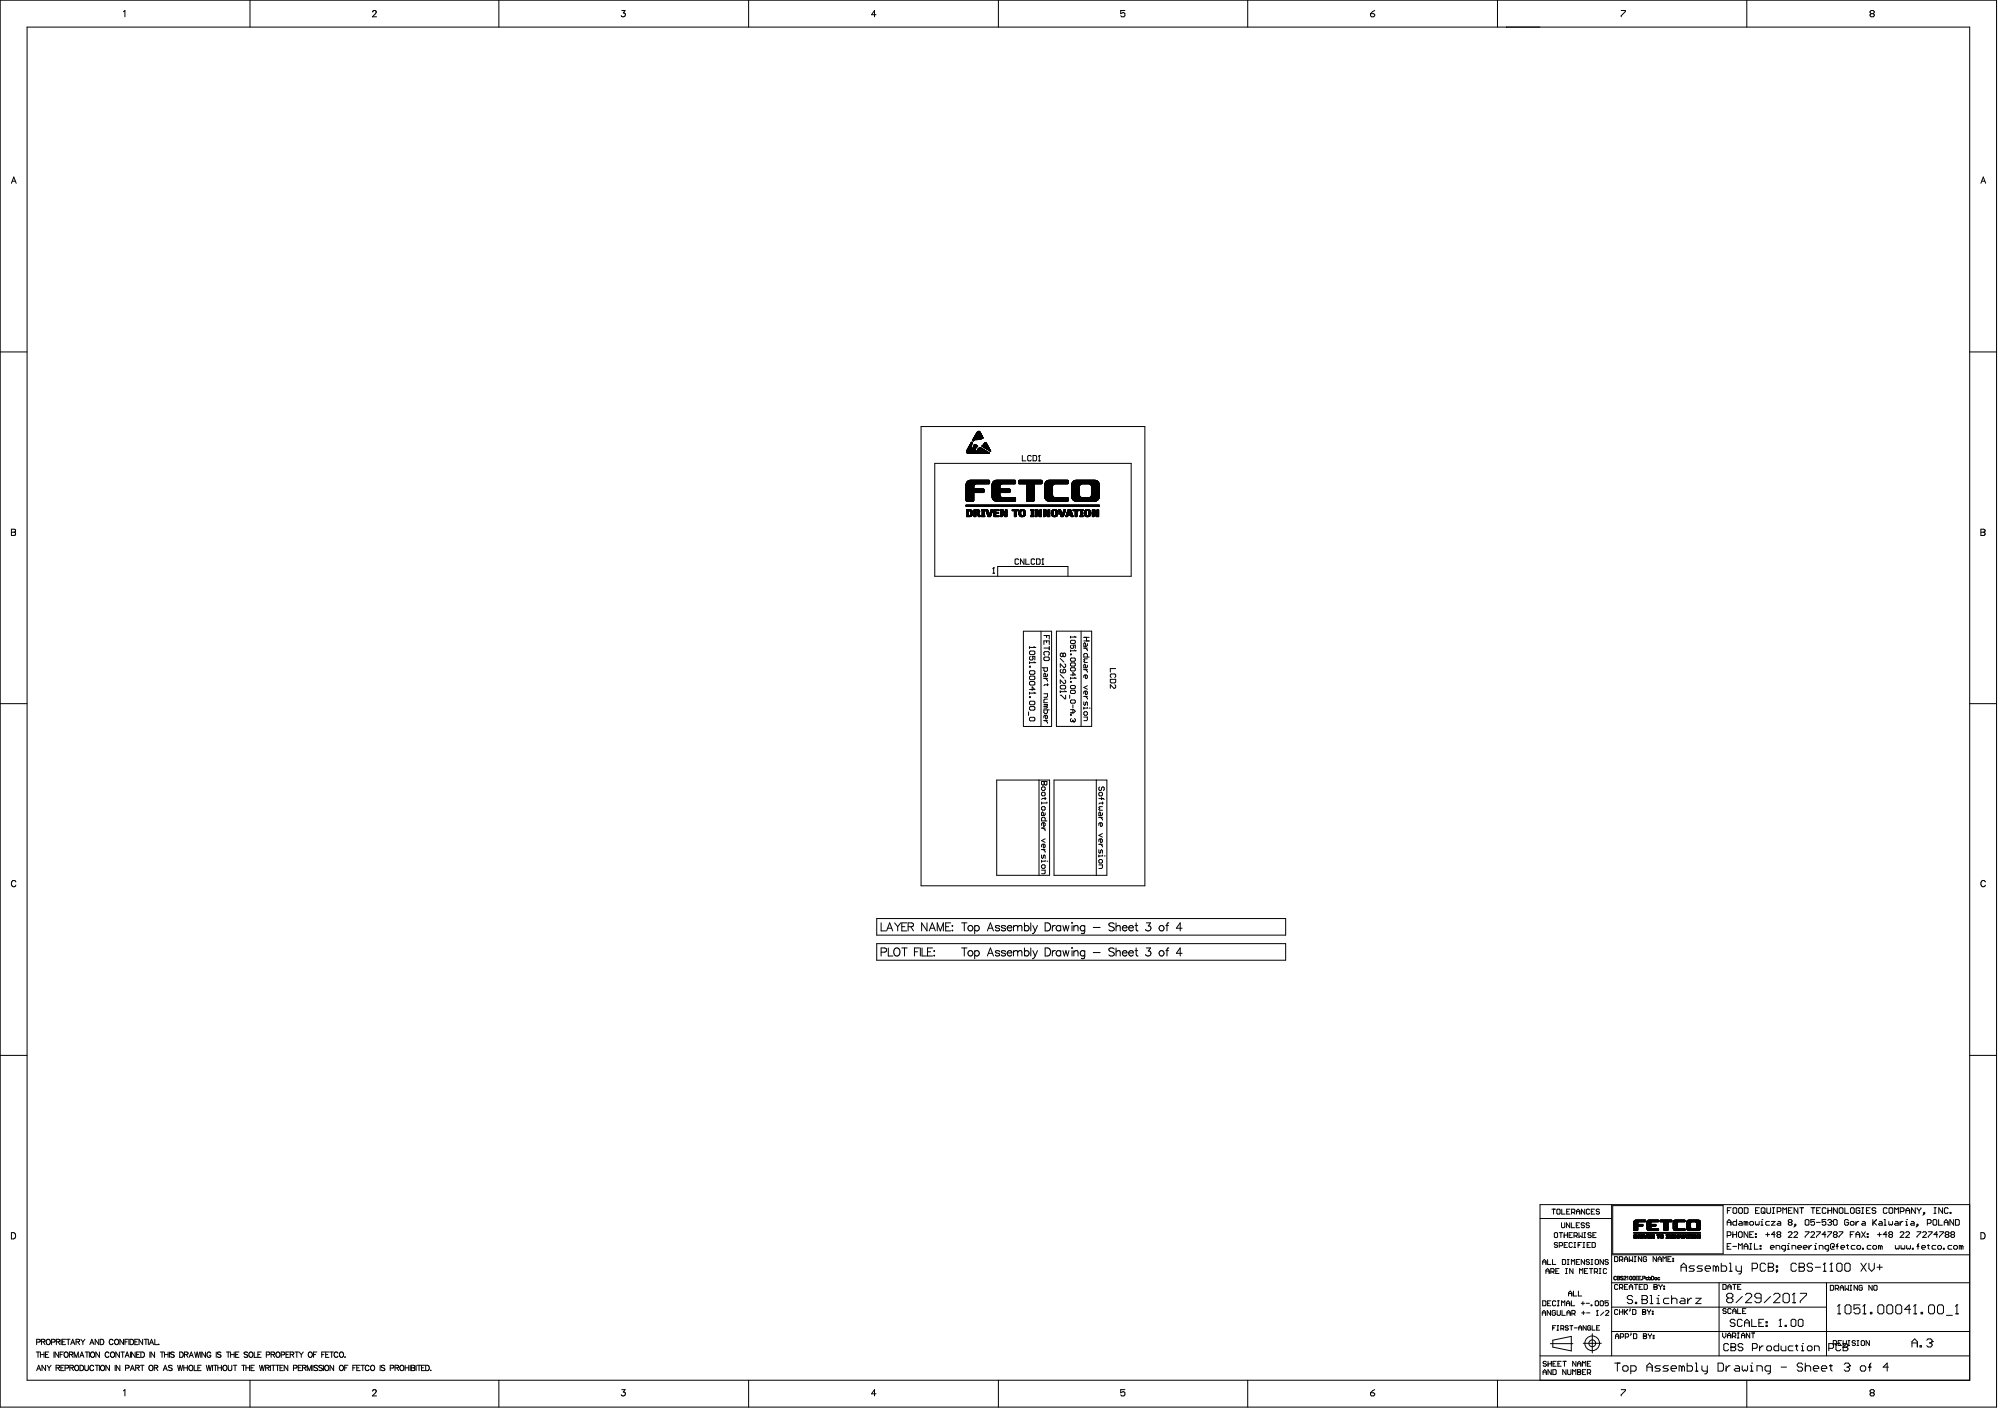
[picture p99: page 3]

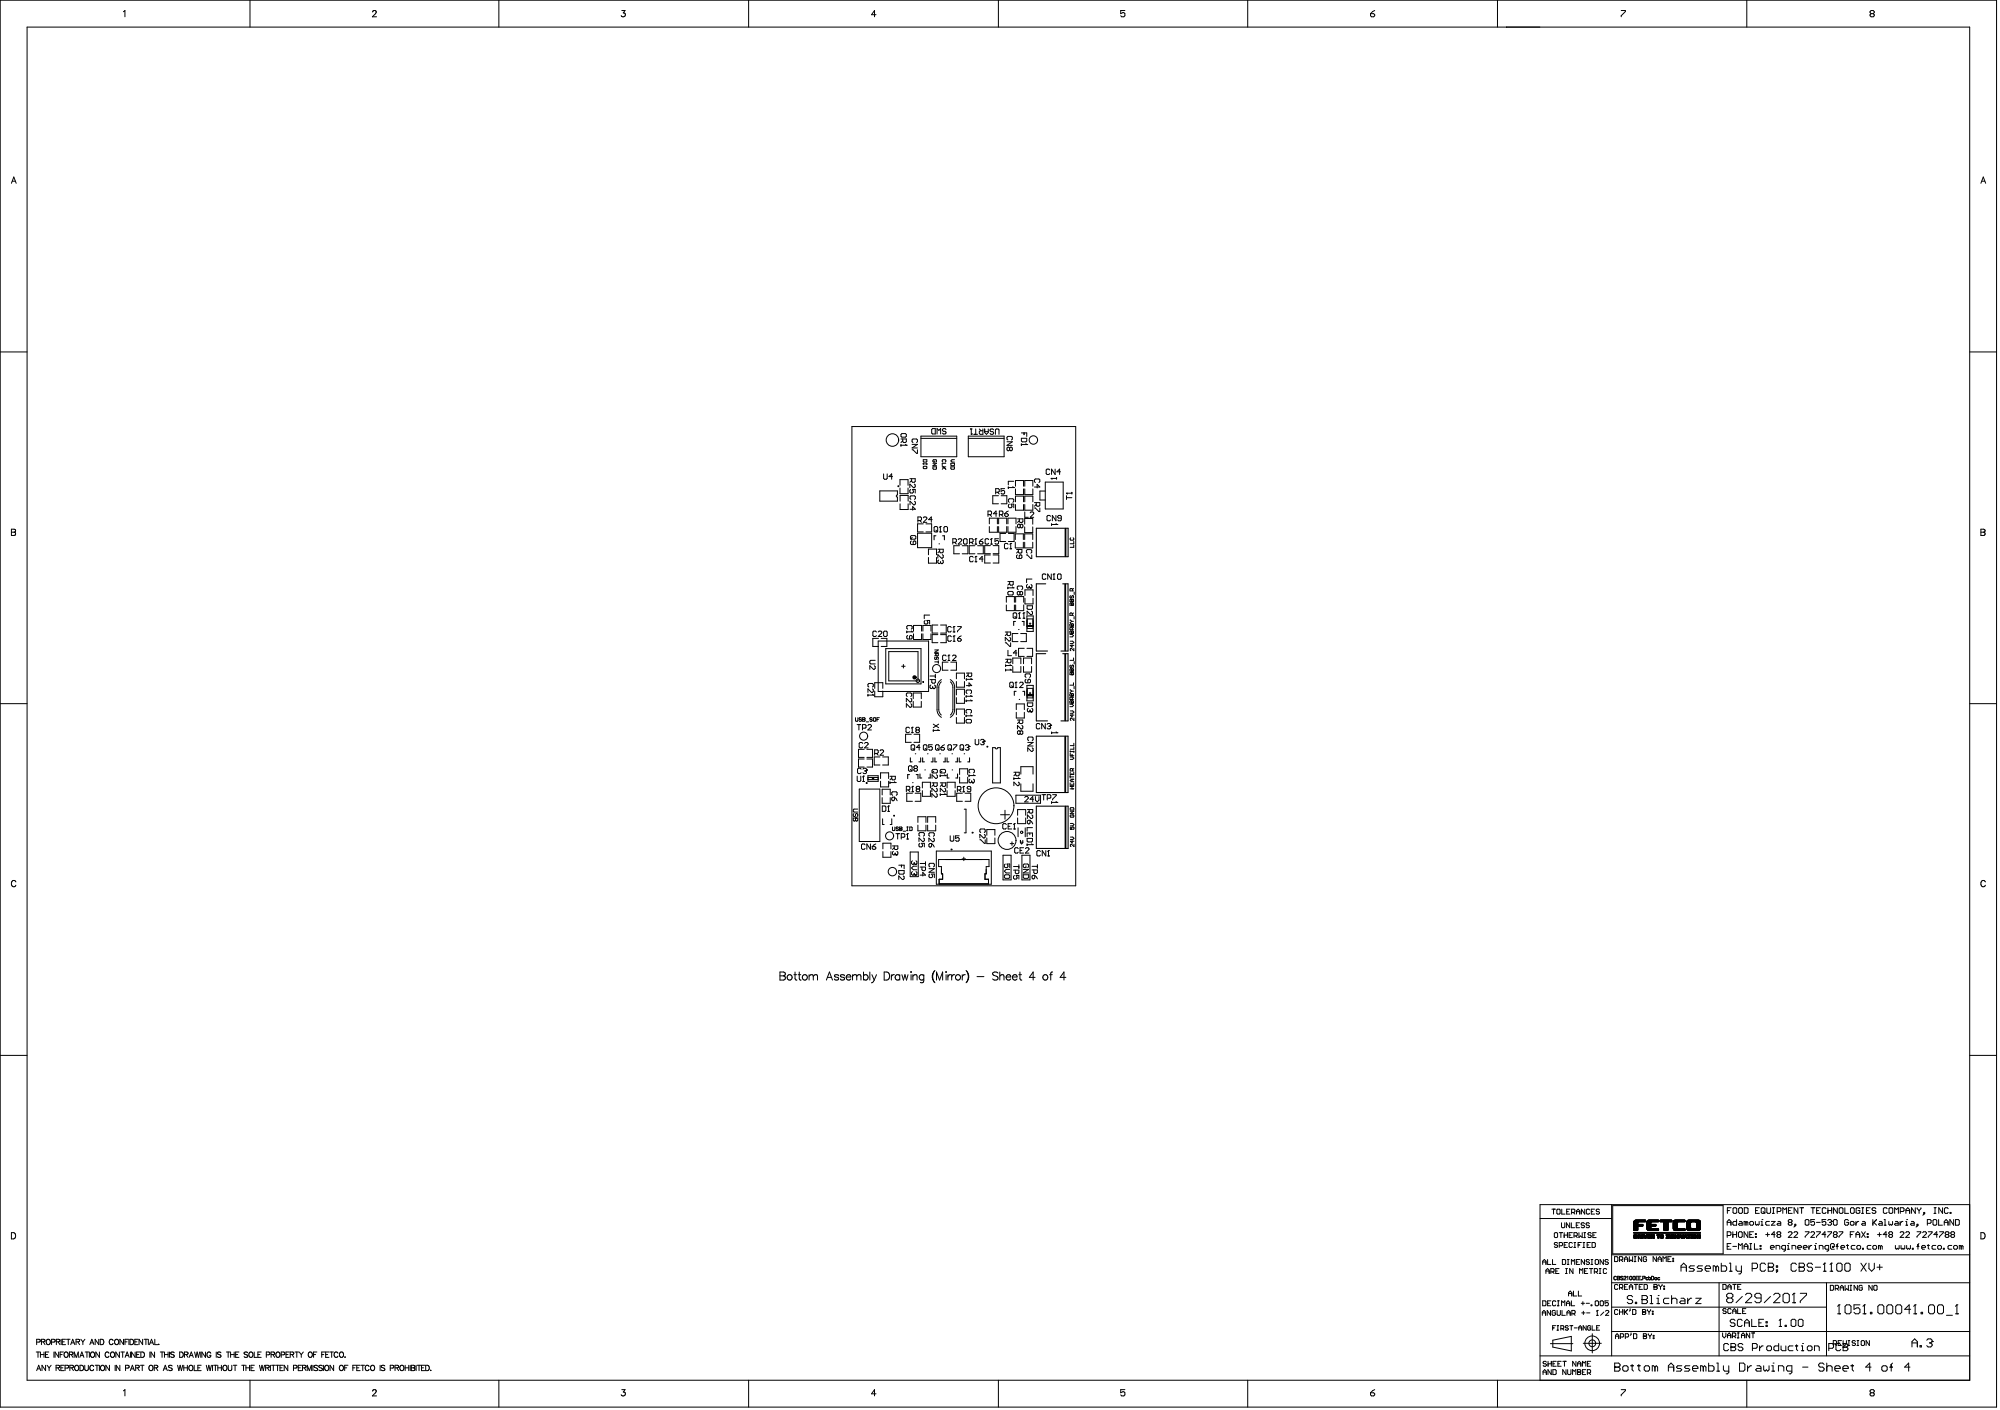
[picture p100: page 4]
