rhoppel/CBS-1100-XV_git/Released/PCB/1051.00041.00-A.3/1051.00041.00_3-A.3/Stencil Documentation/[1051.00041.00_3-A.3] Stencil Frame Printer Details.PDF

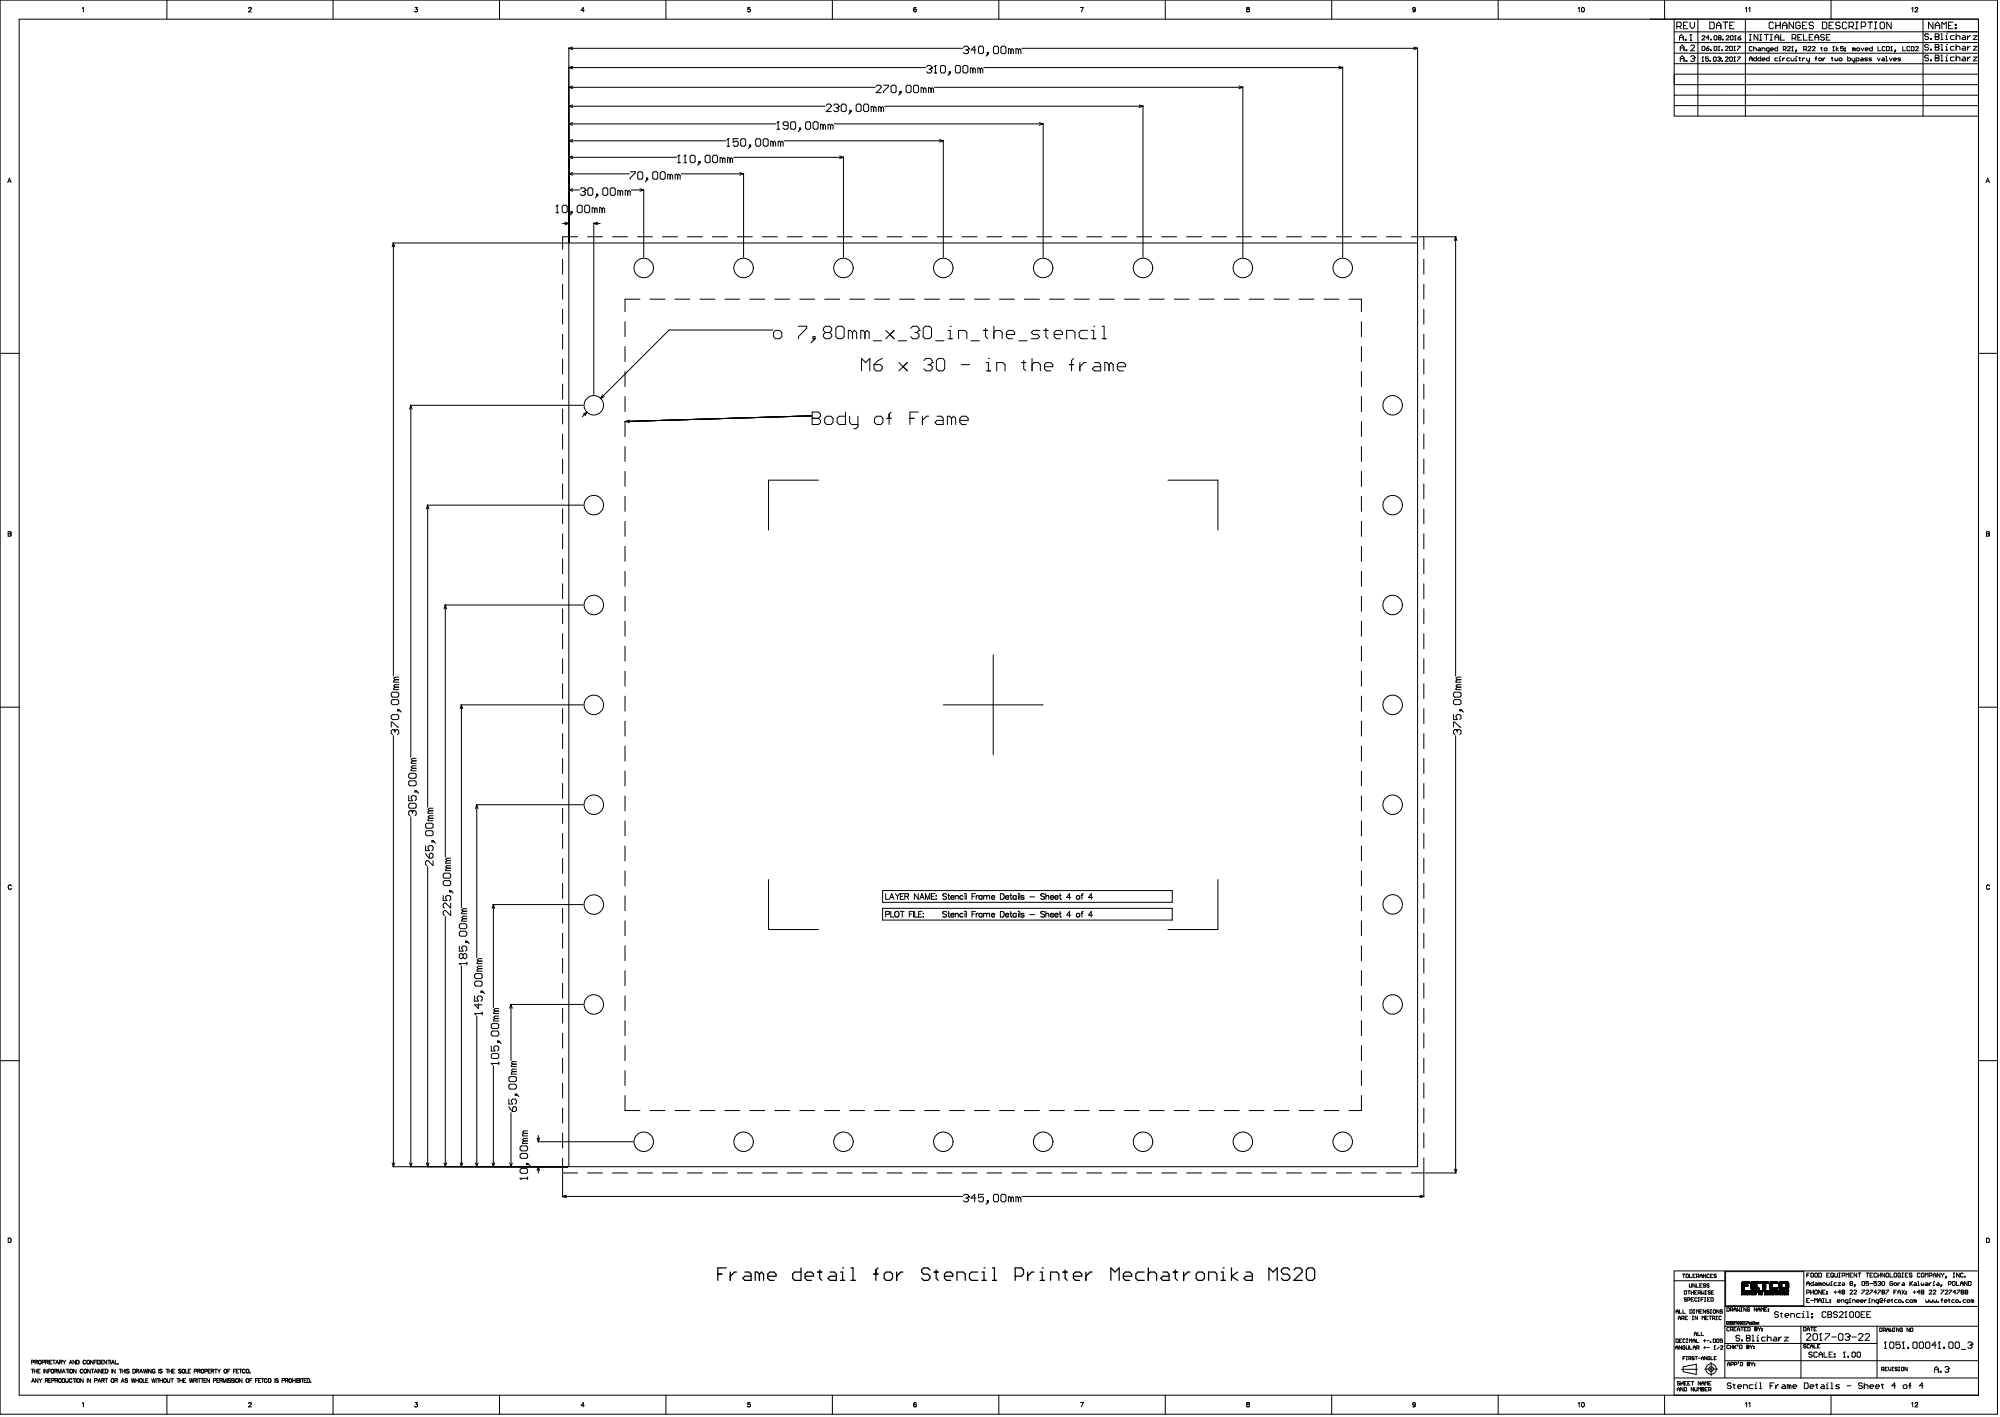
[picture p101: page 1]
