rhoppel/CBS-1100-XV_git/Released/Drawings/1058 (SWITCHES LCD DISPLAYS LIGHT INDICATORS)/1058.00055.00.pdf

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

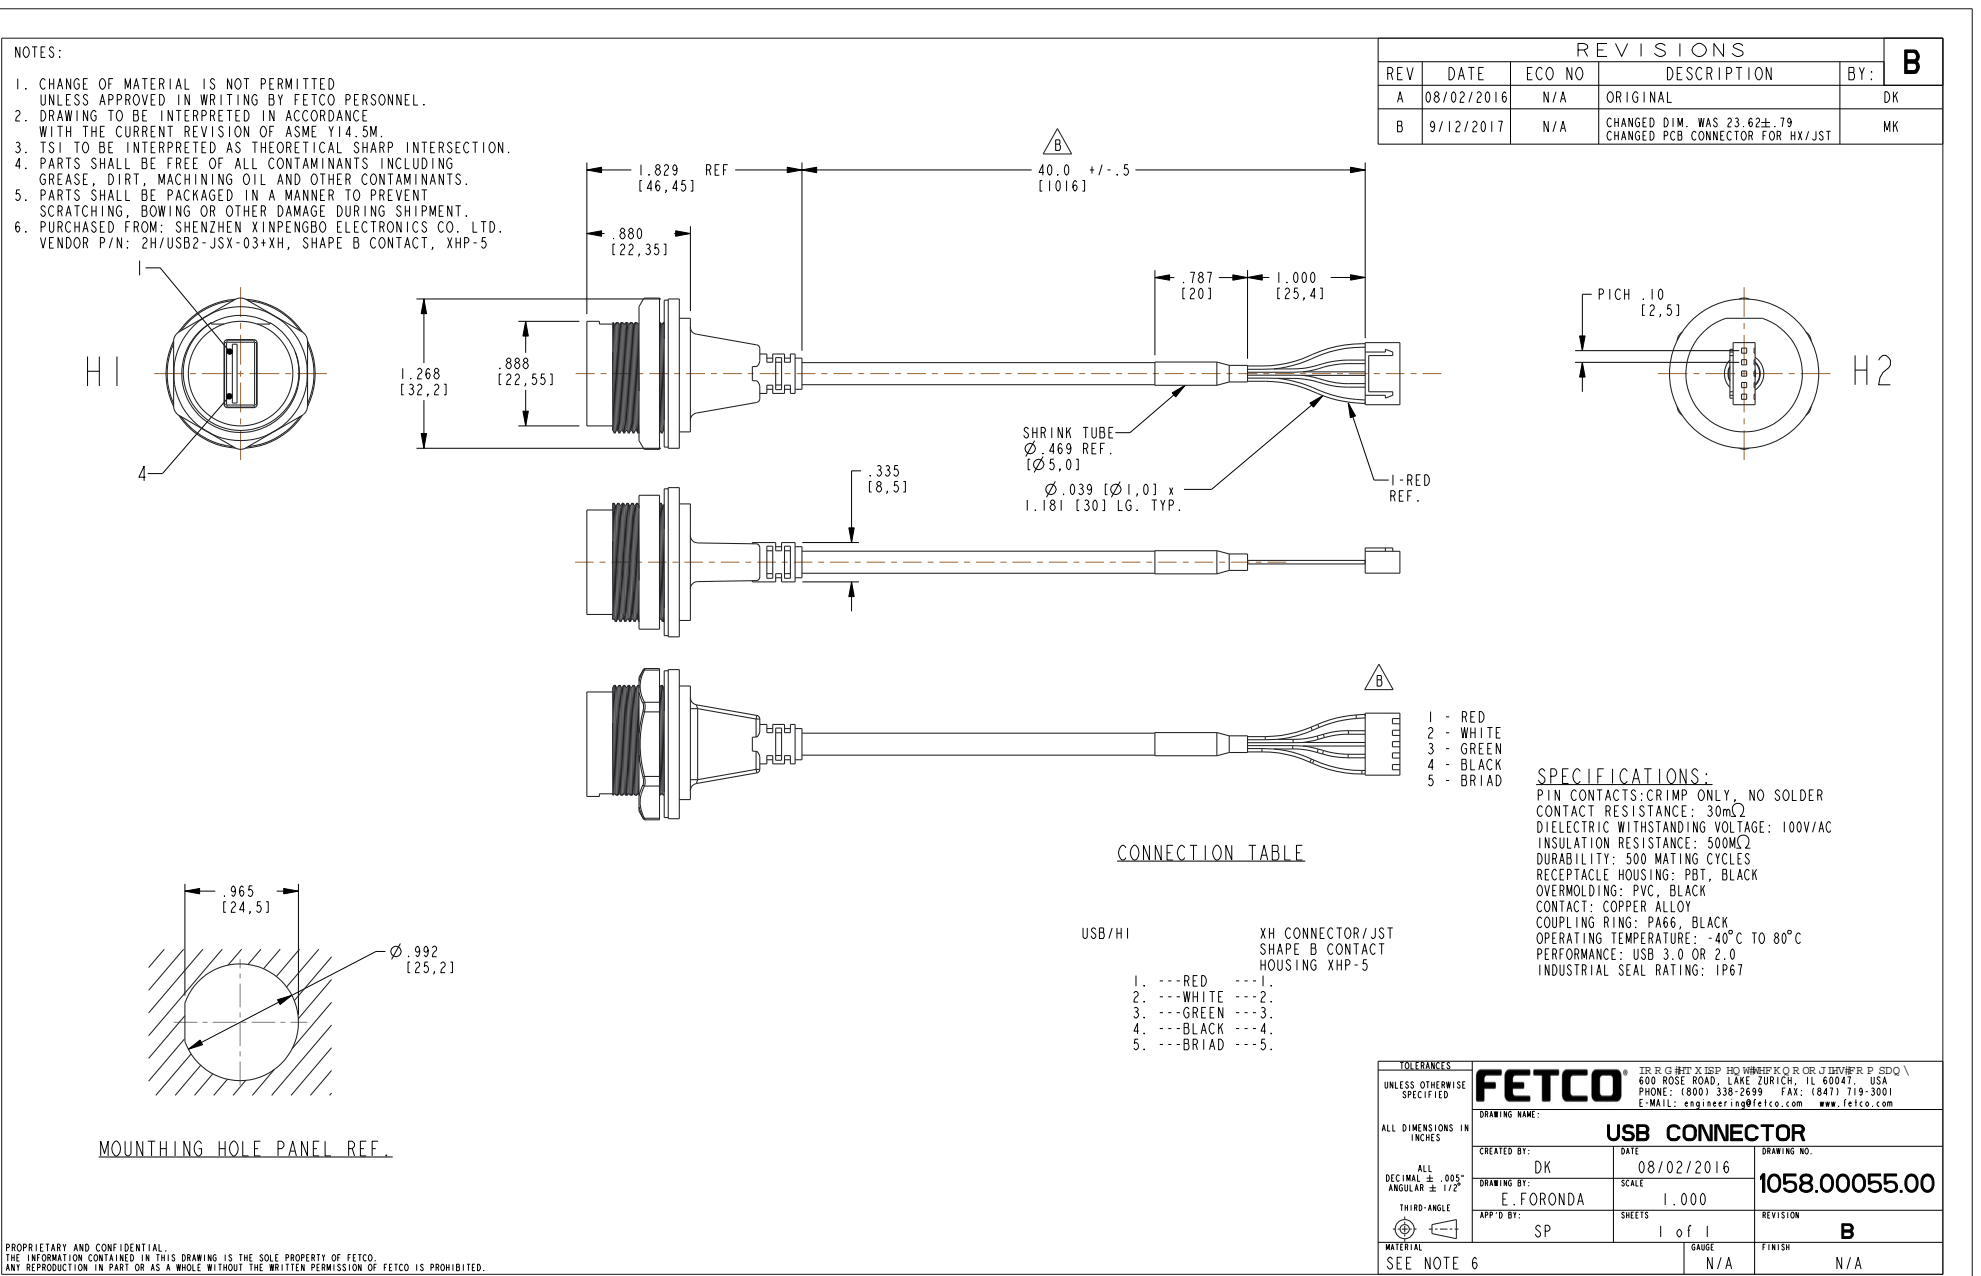
[picture p102: page 1]
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
